danything/outboard/out/board-top.png

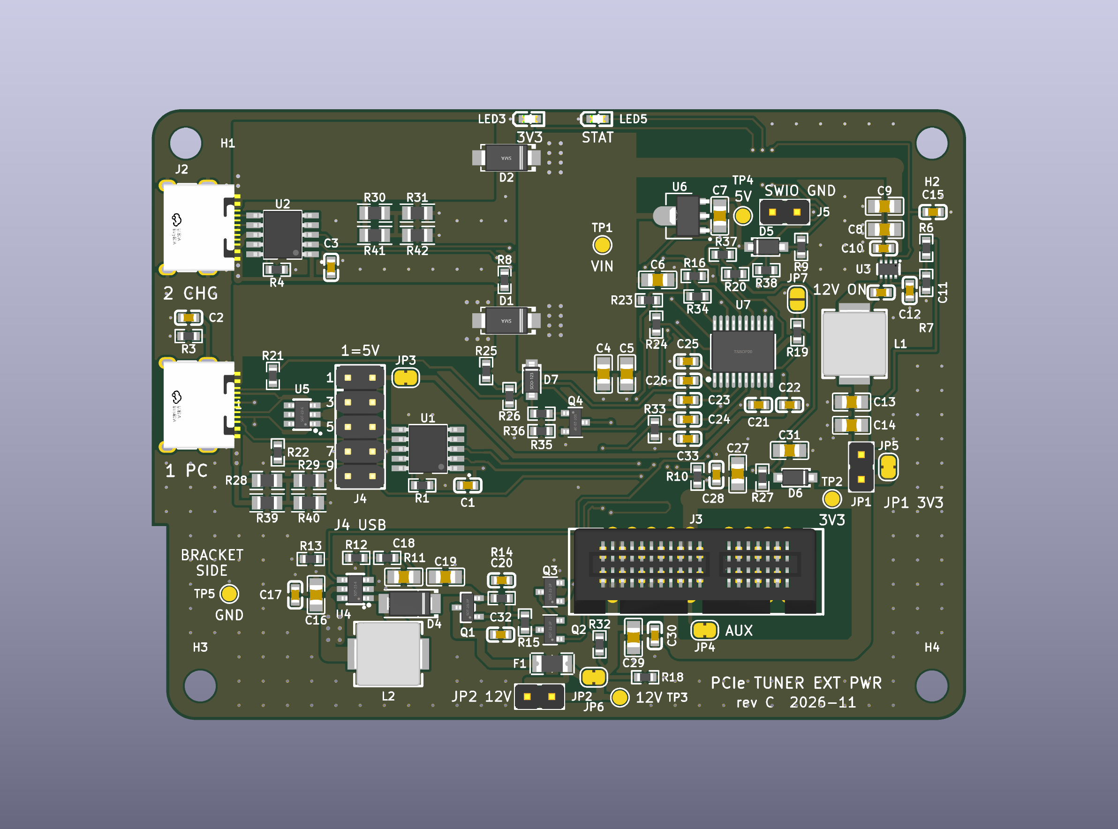
out/board-top.png
