danything/outboard/README.md

# PCIe チューナー外付け基板 (rev C・試作前)

PCIe のスロットから電源だけを取るチューナーカード (PLEX PX-MLT5PE・MLT8PE など。データは内部 USB) を、
PC のスロットなしで外付けの USB チューナーとして使うための基板です。USB-C を 2 つ持ちます。

- J1 (① PC): データ + 電源。D+/D− は ESD 保護 (U5) を通って、内部 USB ヘッダ J4 へ
- J2 (② 充電器): 電源だけ
- どちらも PD で 9V を要求 (CH224A)。取れなければ 5V。2 つの入力はダイオードで VIN にまとめる
- VIN → 3.3V・3A (TPS62933)、VIN → 12V・0.5A (MT3608B + 出力スイッチ + 自動復帰ヒューズ)、VIN → 5V (HT7550-1。マイコンと J4 の VBUS 用)
- 基板は 84 × 63mm・2 層。**USB-C はカードのブラケットと同じ側 (左の辺)**。USB-C の口の面とブラケットの外の面を同じ面にそろえてある
- マイコン (CH32V003) が CC・VIN・VBUS・12V を読み、3.3V と 12V を入り切りする
- ハードで保証していること: ② だけつないでも 3.3V は出ない / 3.3V が無ければ 12V は出ない / マイコンが空なら 12V は出ない / VIN が約 13V を超えたら 12V は入らない (止まっている状態からの保護。下の「過電圧の遮断」)

**実機では何も確かめていません。** 回路図・基板・検査はすべて計算機の上のものです。ファームウェアはまだありません。
rev C は、rev B の再レビューの指摘 (回路の値と小さな追加) と、ケースに入れるための配置替えを入れた版です (下の「rev C で変えた所」)。
**ブラケットの寸法は推定の値で作っています。発注の前に、実物のカードで測ってください (「実物で測る所」)。**

## フォルダの中身

| 場所 | 中身 |
|---|---|
| `pcie-tuner-board.kicad_pro / .kicad_sch / .kicad_pcb / .kicad_dru` | KiCad 10 のプロジェクト (回路図は 1 枚・A2)。ファイルは KiCad 10.0.8 で作った KiCad 10 の形式で、KiCad 9 以前では開けない |
| `lib/` | 自前のシンボル (`pcie-tuner.kicad_sym`)、フットプリント (`pcie-tuner.pretty`)、3D モデル |
| `scripts/` | 作り直すためのスクリプトと、検査のスクリプト |
| `routing/route.ses` | 自動配線の結果 (検査を通ったもの。基板はこれから作り直せる) |
| `fab/` | JLCPCB に出すもの: `pcie-tuner-board-gerber.zip`、`bom.csv`、`cpl.csv` (`gerber/` は zip の中身) |
| `out/` | 回路図の PDF、基板の画像、**寸法の図 (`dimensions.pdf`・`.svg`)**、ERC・DRC・検査の結果、ネットリスト、Q1 のゲートの波形 (`sim/`) |
| `build/` | 途中のファイル (git には入れない) |

## KiCad での開き方と作り直し方

KiCad 10.0 で `pcie-tuner-board.kicad_pro` を開きます。ライブラリはプロジェクトの中を見るので、ほかに何も入れなくて開けます。
**回路図と基板はスクリプトが作ったものです。直すときはスクリプトを直して作り直します。**

Git Bash で、リポジトリの根から (KiCad 10.0.8 が `C:\Program Files\KiCad\10.0` にあること):

```sh
sh scripts/build_all.sh sch      # 回路図・ライブラリ・ERC・ネットリスト・ネットリストの検査
sh scripts/build_all.sh board    # 配置と手配線 → 自動配線 (wslc のコンテナ) → 仕上げ
sh scripts/build_all.sh check    # DRC (回路図との一致つき) と基板の検査
sh scripts/build_all.sh out      # fab/ と out/ の書き出し (寸法の図も)
```

- 自動配線 (freerouting) は**実行のたびに結果が変わります**。つなぎ残す回のほうが多いので、`sh scripts/route_until_clean.sh 8` で、
  DRC が 0 になるまでやり直します (rev C では 4〜5 回に 1 回ほど通りました。1 回 約 70 秒)。通った結果は `routing/route.ses` に残り、リポジトリに入っています
- いまの `routing/route.ses` から基板だけ作り直すなら、KiCad の python で `scripts/finish_board.py`
- 主なスクリプト: `parts.py` (部品)、`gen_project.py` (ルール)、`gen_schematic.py` (回路)、`check_netlist.py`、`board_lib.py` (基板を組む小道具)、
  `make_board.py` (配置と手配線)、`export_dsn.py`・`route.sh` (自動配線)、`finish_board.py` (取り込み・ベタ・シルク)、`check_board.py`、`make_drawing.py` (寸法の図)、`export_fab.py`
- 手で端から端まで引いたネット (電源・USB・CC など) は「Hand」のネットクラスにしてあり、自動配線には触らせません。自動配線が引くのは細い信号と +5V だけです。
  電源の銅の面の上は、自動配線の線を通さないようにしています (DSN にだけ通行止めを足す)
- 外の道具 (コンテナの中でだけ実行): easyeda2kicad 1.0.1 (`python:3.13-slim`)、freerouting 2.5.0 (`eclipse-temurin:25-jre`、sha256 は `route.sh`)、
  ngspice 44.2 (`debian:trixie-slim`。`out/sim/` の波形)。EasyEDA の API は easyeda2kicad 自身からは 403 になるので、データの取得だけ素の curl で行っています

## 機構: ブラケットと USB-C の口 (rev C の中心)

図は `out/dimensions.pdf` (左が全体、右がブラケットのまわりの 6 倍の拡大)。座標は基板の左上の角が (0, 0)、x は右、y は下、単位は mm。
上の長い辺がカードのはんだ面 (A) の側、下が部品面 (B) の側です。

| もの | 位置 | 根拠 |
|---|---|---|
| USB-C の口の面 = ブラケットの外の面 | x = −0.99 (基板の左の辺より 0.99 外) | 口の面と基板の端の差 0.99 は、JLCPCB (EasyEDA) の TYPE-C-31-M-12 のフットプリントの外形から (原点から口まで 5.07、基板の端まで 4.08)。基板の端が後ろの殻の足から 5.79 なのはデータシートの図 |
| スロットの 1 番ピンの中心 | x = 46.55、y = 47.0 ± 1.25 (A 列が上) | 口の面から 47.54。**推定**: PCIe CEM 1.2 を写した KiCad のライブラリ (lucanastasio/PCIexpress-KiCad) の値。CEM そのものは読めていない |
| ブラケットの板 | x = −0.99 〜 −0.13 (厚み 0.86)、y = 44.94 〜 63.36 (幅 18.42) | 厚みは 0.81〜0.86 (Keystone のカタログ)。幅 18.42 と、スロットの中心線から A 面の側へ 約 2.06・B 面の側へ 約 16.36 という分け方は、PCIe CEM 2.0 の図 6-4・6-16 から導いた値 (https://tecsmith.github.io/homeassistant-pc-switch/specs/pci-express-card-electromechanical-specification-revision-2.pdf)。**図の読み方で幅があり、A 面の側は 2.5 とも読める** |
| ブラケットをよける段 | y ≥ 43.0 では、基板の左の辺を x = 1.5 に引っ込めた | ブラケットの下の舌は、基板のおもての面より下まで伸びる (標準の高さで 約 11.8mm、ロープロファイルで 約 7.7mm) ので、そこに基板があると当たる。ブラケットの内の面から 1.63、ブラケットの A 面の側の端から 1.94 (2.5 と読んだときは 1.50) の余裕 |
| カードの基板の端 | x = 0.90 (1 番ピンから 45.65) | 同じライブラリの値。基板より上を通るので当たらない |
| J1 (① PC) / J2 (② 充電器) | 中心 y = 30.5 / 12.2。殻の幅 8.94 | 2 つともカードのはんだ面の側。間隔 18.3 (プラグの樹脂どうしが当たらない) |
| J4 (内部 USB) | 中心 (21.5, 32.8)。カードの面から 14.2 (ヘッダの端から 7.7) | J1 のすぐ奥。カードのはんだ面の側なので、挿したケーブルのプラグ (高さ 約 14) がカードの部品に当たらない。ケースの外からは触らない |
| LED (3.3V・STAT) | (39.0, 1.0)・(46.0, 1.0)。胴体の端は上の辺から 0.6 | 上の長い辺 (はんだ面の側) を選んだ: 下の辺の側はカードの部品 (高さ 14.5 まで) が基板の外まで張り出して LED を上から隠す。上の辺は J4 のケーブルから 20 以上離れている。横向きに光る LED は Basic・Preferred に無いので、ふつうの 0603 (C2286) を辺のすぐそばに置いた |

**ケースの床**: ブラケットの舌は基板のおもての面より下へ、標準の高さのブラケットで 約 11.8mm、ロープロファイルで 約 7.7mm 出ます。
基板の厚み 1.6mm を引いて、基板の下に 10.2mm (ロープロファイルは 6.1mm) 以上の空きか、床に舌の通る穴が要ります。取り付けの足の高さはそれで決まります。

ケースの後ろの板は、内の面がブラケットの板に当たる面 (x = −0.13) になる想定です。ブラケットの厚みが 0.86 なら、USB-C の口は板の穴の中へ 0.86 入ります (指示の 0〜1mm の中)。

取り付け穴 (M3 用、穴 3.2mm、めっきなし):

| 穴 | x | y |
|---|---|---|
| H1 | 3.5 | 3.5 |
| H2 | 80.5 | 3.5 |
| H3 | 5.0 | 59.5 |
| H4 | 80.5 | 59.5 |

H3 だけ、段のぶん 1.5 右に寄っています。

**カードの長さ**: PX-MLT8PE の基板の長さは、公表の値を見つけられませんでした (メーカーの仕様に外形の記載を見つけられず、検索で出たのは非公式のケースの頒布だけ)。
図では、カードが基板の右の端より先へ続くことだけを示しています。基板の右の端は 1 番ピンから 37.45mm、スロットの右の端から 約 14mm なので、ふつうのロープロファイルのカード (120mm 以上) は基板から右へはみ出します。

### 実物で測る所 (発注の前に)

1. **1 番ピンの中心 (カードでは端子の 1 番の中心) からブラケットの外の面まで**: 設計は 47.54。違っていたら `make_board.py` の `PIN1_TO_BRACKET` を直して作り直す
2. **ブラケットの板の厚み**と、**ブラケットがカードの面からどちらへ何 mm 張り出しているか** (設計は A 面の側へ 2.06〜2.5、B 面の側へ 16.36)。A 面の側が 3.5 を超えると、段との余裕が 0.5mm を切る (4.0 で当たる)
3. **ブラケットの下の舌が、スロットに挿したとき基板のおもての面より何 mm 下へ出るか** (設計は 11.8 / 7.7mm と見ている) と、その幅 (幅 18.42 の全部をよけている)
4. カードのはんだ面の側の部品の高さ (J4 のプラグまで 7.7 ある)、カードの USB のケーブルが J4 に届くか
5. カードの基板の長さ (ケースの奥行きを決めるため)
6. USB-C のプラグの樹脂が、ケースの板とブラケットに当たらないか (J1 の殻の下の端からブラケットの端まで 約 10)

## JLCPCB への出し方 (発注はまだしていません)

1. 見積もりで `fab/pcie-tuner-board-gerber.zip` を上げる。2 層、84 × 63mm、1.6mm、銅 1oz、ほかは標準。外形は左下に 1.5mm の段がある (入り隅は工具の丸みになる)
2. 「PCB Assembly」をオン。**Economic**、Top Side、数量 2。**備考欄に「J1/J2 (USB-C) overhang the left board edge by 1 mm」と書く** (基板の端から部品が出ることを先に伝える)
3. BOM に `fab/bom.csv` (36 行)、CPL に `fab/cpl.csv` (98 個) を上げる
4. 部品の割り当ての画面で、全部の行が LCSC の品番で見つかること、在庫、Basic / Extended の区分を確かめる
5. **部品の配置の絵で向きを確かめる** (下の一覧)。ずれていたらその場で回す

**見積もりの画面で見る所 (確かめられなかったこと)**:

- **C404113 (PCIe スロット)・C492422 (2×5 ヘッダ)・C165948 (USB-C) が Economic で載せられるか**。部品検索の API には Economic / Standard の区分の欄が無く (見た欄: `componentLibraryType`・`assemblyComponentFlag` など)、確かめられなかった。
  「Standard only」と出たら、段取り費が大きく変わる (下の見積もりの Standard の列)。その部品だけ載せずに自分で付ける手もある
- **スルーホールの部品 (J3・J4) に Extended の手数料 (Feeder Loading 3.07 ドル) がかかるか**。料金のページは「ピックアンドプレースのフィーダーの段取りの手数料」と説明していて、手はんだの部品にかかるとも、かからないとも書いていない。下の見積もりは、かかるものとして数えている (かからなければ 6.14 ドル安い)
- 実装の最小の枚数 (API の `leastPatchNumber` は、見た 3 部品とも 2)

JLCPCB が付ける物: 表面実装の部品全部と、スルーホールの **J3 (PCIe スロット) と J4 (2×5 のピンヘッダ)**。

載せない物:

- TP1〜TP5、H1〜H4
- はんだジャンパー JP3・JP4・JP5・JP6 (幅 1.0mm の銅の橋で最初からつながっている。切るときはカッターで橋を切る) と JP7 (最初は開いている)
- **1×2 のピンヘッダ J5・JP1・JP2**: 穴だけ作って載せない

届いてから手ですること:

- J4 の 9 番ピン (シルクの「9」の横) を抜く。マザーボードのヘッダと同じ、誤挿し防止の欠けピンにするため
- カードのケーブルが 1 列 5 ピンのときは、**シルクに 1・3・5・7・9 と数字のある列 (J1 に近い列)** に挿す。「1=5V」の側が 1 番 (5V)、3 が D−、5 が D+、7 が GND
- J5 (SWIO・GND) に 2 ピンのヘッダを付けるか、書き込みのときだけ線を当てる
- 電流を測るときだけ: JP5 (3.3V) か JP6 (12V) の橋を切り、JP1 か JP2 にヘッダを付けて電流計を挟む。測らないなら何もしない
- 12V を手で強制オンにしたいとき: JP7 をはんだでつなぐ (ファームウェアが SW1_IN を読む)

J4 は囲いのない 2×5 のヘッダ (C492422) のままです。囲いつきは IDC 用の箱形ヘッダ (C19193807・C53207560、どちらも Extended) しか無く、
マザーボードの USB ヘッダ用のプラグ (欠けピンで向きを決める) は IDC の箱の切り欠きに合う作りではないので、採っていません (判断。実物では確かめていない)。

### 配置の絵で見る所 (CPL の回転は補正 0。フットプリントを JLCPCB のライブラリのものにそろえたので理屈では合うが、確かめていない)

基板を「USB-C が左、スロットが下寄り」に置いて見たとき (rev C で向きが変わった):

| 部品 | 正しい向き |
|---|---|
| D1・D2 (SS54)・D4 (SS34)・D6 (1N4148W) | 帯 (カソード) が右 |
| D5 (1N4148W) | 帯が左 |
| D7 (BZT52B12) | 帯が上 |
| Q1・Q2・Q3 | 足 1 本の側が左、2 本の側が右 |
| Q4 (MMBT3904) | 足 2 本の側が左、1 本の側が右 |
| U1・U2 (CH224A)・U4 (MT3608B)・U5 (SRV05-4) | 1 番ピンが右下 |
| U3 (TPS62933) | 1 番ピンの丸印が右上 |
| U6 (HT7550-1) | 大きいタブが左 |
| U7 (CH32V003) | 1 番ピンが左下 |
| LED3・LED5 | カソードの印が左 |
| J1・J2 | 口が左 (基板の外) |
| J3 | 切り欠きが中央より右、「A」が上・「B」が下 |
| J4 | 1 番ピン (四角のパッド) が左上 |

## rev C で変えた所

配置 (持ち主の希望):

| # | 何を | どうした |
|---|---|---|
| 1 | USB-C | ブラケットと同じ側 (左の辺) へ。口の面 = ブラケットの外の面。基板をブラケットの側へ伸ばし、ブラケットが通る所は辺を 1.5mm 引っ込めた (上の「機構」) |
| 2 | LED | 2 個とも上の長い辺に、辺から 0.6mm、間隔 7mm、基板のまん中あたり (x = 39・46。基板の幅は 84) |
| 3 | 取り付け穴 | 四隅 (上の表) |
| 4a | D1・D2 の銅 | アノードはおもての面 212mm² (VBUS1)・230mm² (VBUS2)、カソードは 2 個で共用のおもての面 406mm² + うらの面 372mm²。カソードのパッドのすぐ横に外径 0.8mm のビア 8 個ずつ (`check_board.py` の値) |
| 4b | CC の線 | USB-C の殻の下を通さない: パッドから奥へ出して手で引いた。① は J4 のピンの間を抜けて U1 へ。`check_board.py` (殻の四角と CC の線・ビア) と、DRC のルール (`.kicad_dru`) の両方で見ている |
| 4c | うらの面の線 | **目標の 150mm には届いていない: 257mm** (rev B は 約 250mm)。降圧・昇圧の下は 0 本。USB のデータ線の下は、D+ 自身の A6 の渡り (2.3mm) だけで、ほかのネットは 0 本 (検査あり)。長い順: LED3_A 36、EN_3V3 25、I2C2_SCL 22、I2C1_SCL 21、I2C2_SDA 16、+5V 15、CC2_SENSE 15mm。手で決めたうらの線は、VIN の面をくぐる 3 本 (I2C2 と EN_3V3、各 14mm)、降圧への幹をくぐる 3 本 (各 3.6mm)、PERST# (13mm)、Q3 のゲートの +3V3 (14mm)、① の殻 (9mm)、U1 の VBUS (5mm) |
| 4d | F1 | Q1 から 10.5mm、D4 から 16.0mm、L2 から 16.9mm (中心どうし)。スロットの 1 番ピンのすぐ下 |
| 4e | JP5 などの橋 | 閉じたはんだジャンパーの銅の橋を、幅 0.6mm から 1.0mm に (JP3・JP4・JP6 も同じフットプリント) |
| 4f | J3 の柱の穴 | **2 か所とも 2.35mm (rev B と同じ)**。UMAX の図面 (318307001、4/5 枚目) の推奨が 2 か所とも ø2.35±0.05。柱は、切り欠きの横が ø2.20±0.10、端が ø2.05±0.10 (1/5 枚目)。切り欠きの横を 2.40 に広げる案は、A11・B11 の穴との壁が 0.47mm に減るのでやめた (2.35 で 0.495mm、パッドの銅まで 0.27mm)。柱が最大 (2.30) で穴が最小 (2.30) だと、すきまは 0 |
| 4g | 部品の外枠 (コートヤード) の DRC | 有効にして 0 件。除外は無い |
| 追加 | J4 | JLCPCB に載せてもらう (C492422、Extended)。J1 のすぐ奥、カードのはんだ面の側 |

回路 (再レビューの指摘):

| # | 何を | どうした |
|---|---|---|
| 5 | Q1 のゲート | C20 100nF → **1µF**、R15 100kΩ → **150kΩ** (C22807)、C32 47nF → **33nF** (C21117)、R14 は 100kΩ のまま (下の「Q1 のゲート」) |
| 6 | F1 | nSMD075-16V → **1206L110/16NR** (C7542961、LUTE、保持 1.1A・遮断 2.2A・16V、1206)。データシートの表で 60℃ 0.72A・70℃ 0.66A・85℃ 0.55A。在庫 18,883 (2026-11-11) |
| 7 | ブリーダ | VBUS1・VBUS2 それぞれ、1kΩ 0805 (C17513、125mW) を 2 直列 × 2 並列 = 1kΩ。21V で 1 本 110mW、9.9V で 25mW (`check_netlist.py` が定格と比べる) |
| 8 | 直列の 1kΩ | マイコンの PC4 と PERST# の間に R37、PC3 と U3 の EN の間に R38。PC4 が Low のとき PERST# は 0.21V、PC3 が Low のとき EN は 0.05V (VBUS1 が 20V でも 0.20V) |
| 9 | D1・D2 | **SS54 のまま** (下の「SSL54 との比べ」) |
| 追加 | CH224A の CC | 端子の CC1 を IC の 6 番 (CC2)、CC2 を 7 番 (CC1) へ**入れ替えてつないだ**。基板の上で 2 本を交差させない (うらを通さない) ため。CH224A のデータシートは 2 本とも「Type-C CC 信号線」としていて、区別が出てくるのは使っていない eMarker の模擬 (オス端子) だけ。向きを IC がどちらと見るかが変わるだけで、動作は同じと判断した (**実機では確かめていない**) |
| 追加 | 分圧の下の抵抗 | R24・R26 は上の抵抗のそばへ移した (回路は同じ)。R8 (EN の分圧の上) は D1 のアノードの面の右上へ |

マイコンのピンは rev B と同じです。

## 設計の決めごとと根拠

### VIN や VBUS が 20V になったとき (充電器の異常) と、12V の過電圧の遮断

TVS は載せていません (Basic に 20V 級は無い。Preferred の SMF24A は抑える電圧が 38.9V で、守りにならない)。
20V (PD の上限は 21V) がかかっても壊れないこと:

- VIN の側: U3 30V (最大定格 32V)、U4 24V (最大定格 26V)、U6 30V、コンデンサ 25V 以上、D1・D2 40V
- VBUS の側: CH224A の VHV・VBUS は 30V 級、CC は直列 100kΩ でマイコンへ (0.15mA)、**ブリーダは 21V で 1 本 110mW (定格 125mW)**、VBUS のコンデンサ 50V、
  U3 の EN は D5 が 5.7V に抑える (20V のとき D5 に 0.14mA)、マイコンの ADC は 20V で 4.96V

昇圧は止めていても入力を出力へ通すので、VIN が高いとき Q1 を入れるとカードにその電圧がかかります。これをハードで止めます:
VIN → D7 (BZT52B12、12V ±2%) → R35 (10kΩ) → Q4 (MMBT3904) のベース、R36 (10kΩ) でベースを GND へ。Q4 のコレクタが Q2 のゲートを GND に引きます。

- 効きはじめる VIN = Vz + 2 × Vbe → **12.2〜13.6V** (下の端は計算で 12.16V)。確実に切れるのは 13.8V 以上 (hFE 30 として)。9V の PD (VIN は最大 9.5V) では必ず入り、15V では必ず切れる
- **これは「止まっている状態」の保護です。** 12V を出している最中に VIN が 9V から 20V へ上がった場合、Q1 が切れるまで数十 ms かかり (ゲートの 1µF と 33nF を 100kΩ で放電する。
  下の表の「オフの遅れ」は 157ms)、その間はカードに高い電圧がかかります。防ぐのはファームウェアの役目で、CH224A に 9V より上を決して要求しないことです
- **12V 固定の AC アダプタ (PD でない、VIN が 11.6〜12.3V) は、下のしきい値 (12.16V) に触れます。** その入力では 12V の出力は保証しません (入ったり入らなかったりする)
- Q1 (AO3401A) の Vgs は、切れる手前の 13.8V でも −5.5V。最大定格は ±12V
- ツェナーの数十 µA での電圧は、データシートの表に無く、見積もりです

20V を超える電圧、挿した瞬間の跳ね上がりは、防いでいません。

### Q1 のゲート (ngspice の結果。`out/sim/` に回路・波形・表)

回路: Q1 のゲート-ソースに R14 100kΩ と C20、ドレイン-ゲートに C32、ゲートから R15 を通って Q2・Q3 で GND へ。

| | rev B (100k / 100n / 47n) | 再レビューの案 (33k / 1µ / 47n) | **採った値 (150k / 1µ / 33n)** |
|---|---|---|---|
| 挿した瞬間の Vgs (9V の PD、VIN 8.6V) | Vth を超えて Q1 が入る | −0.38V | **−0.27V** (4.6V のとき −0.15V) |
| 同 (20V の異常、19.6V) | — | — | −0.63V (Vth が最小 0.5V の個体は、出力に 2.5V 漏れる) |
| オンのときの Vgs (12.36V / 13.8V) | −6.2 / −6.9V | −9.3 / **−10.4V** | **−4.94 / −5.52V** |
| 立ち上がり・突入 (負荷のコンデンサ 100 / 220µF、無負荷) | — | 0.7 / 1.3A | 1.8V/ms、**0.21 / 0.42A** (14.7ms の遅れのあと) |
| オフの遅れ (SW12_ON を下げてから出力が下がりはじめるまで) | — | — | 157ms (0.5V まで 207ms)。0.5A を流したまま切ると Q1 に 53mJ |

- 挿した瞬間は、C32 と C20 の分圧でゲートが取り残されます (Vgs = VIN × C32 / (C32 + C20) = 8.6 × 33n / 1.033µ = 0.27V)。AO3401A の Vth の最小は 0.5V なので入りません。`check_netlist.py` がこの式で見ています
- 再レビューの案は、13.8V で Vgs が −10.4V (定格 ±12V に近い) で、突入も大きいので採っていません
- オンの Vgs −4.9V は、データシートの −4.5V の条件 (最大 60mΩ) より少し深い。0.5A で 30mV・15mW
- **出力の短絡は、SW12_ON を下げても守れません** (切れるまで 50〜250ms、その間 Q1 に 1〜3J)。EN_12V を下げても、昇圧は D4 で素通しなので電流は止まりません。
  短絡のときは Q1 を入れたまま F1 に任せます (ファームウェアの仕様 5)。
  **次の版の候補**: ゲートを速く放電する回路 (Q1 のゲート-ソースを小さな PNP か P-MOSFET で短絡する、または R14 を小さくして専用のドライバで引く) を足し、短絡でも数 ms で切れるようにする。rev C には入れていません

### ブリーダ抵抗と、D1・D2 (SS54) の熱、SSL54 との比べ

SS54 (MDD、C22452、`build/ds/C22452.pdf`): 逆電流は最大 1.0mA (25℃)・50mA (100℃) (40V)。9V のときはグラフ (typical) から 25℃ 約 4µA、75℃ 約 0.2mA、100℃ 約 3mA。
順電圧は最大 0.55V (5A)、グラフ読みで 2A 約 0.36V・3A 約 0.42V。RθJA 60℃/W (5 × 5cm の銅)。接合温度は 125℃ まで。

SSL54 (C41410770、Preferred、在庫 13,264。データシート `build/ds/C41410770.pdf`): 順電圧は最大 0.48V (5A)、グラフ読みで 2A 約 0.36V・3A 約 0.38V。
逆電流は最大 0.5mA (25℃)・50mA (100℃) (40V)、9V のグラフ読みで 25℃ 約 15µA・100℃ 約 4.5mA。RθJA 80℃/W、接合温度 150℃ まで。

| | SS54 | SSL54 |
|---|---|---|
| 3A のときの損失 | 約 1.26W | 約 1.14W (1 割減) |
| 9V・100℃ の逆電流 (typical) → 1kΩ のブリーダでの VBUS | 約 3mA → 3.0V | 約 4.5mA → 4.5V |
| 9V・75℃ | 約 0.2mA → 0.2V | グラフから読めない (SS54 より多い) |
| 手数料 | Basic | Preferred (FAQ では Extended の手数料がかからない) |

**替えていません。** 順電圧の得は 3A で 0.04V ほど (グラフ読みの粗さと同じくらい) なのに、熱いときの逆電流が 1.5 倍で、② だけつないだときに VBUS1 が 0.8V (vSafe0V) を超える温度が下がります。
SSL54 には EasyEDA のフットプリントも無く、SS54 のランドを流用することになります。熱は、銅を広げたこと (rev C) で対処しました。

ブリーダ: ② だけに 9V が来ているとき、D1 の逆電流が VBUS1 に流れ込みます。1kΩ なら 75℃ で 0.2V、0.8V に届くのは 0.8mA (グラフでは 85〜90℃)。
U3 の EN がオンになる 2.9V に届くのは 2.9mA (約 100℃)。**熱いときの余裕は typical の線に対するもの**です。

熱 (計算。損失は rev B と同じ): 5V・3A で 1.26W、5V・2.5A で 約 1.0W、9V・2A で 0.72W、9V・1.35A で 約 0.45W。
rev C では、アノードとカソードそれぞれに 200〜400mm² のおもての銅と、うらの面 (ビア 8 個) が付いたので、熱抵抗はデータシートの 60℃/W (25cm² の銅) と rev B (パッドのそば 33mm²) の間のどこかです。
**何 ℃/W かは計算できていません。** 60〜90℃/W と見れば、5V・3A で 76〜113℃ の上がり (まわりが 40℃ なら接合 116〜153℃) で、**5V で 3A を流し続けるのはまだ危ない**見込みです。試作で温度を測ります。

### 値の計算

- **3.3V**: 0.8V × (1 + 47k/15k) = 3.307V。500kHz、4.7µH。ソフトスタート 100nF → 14.5ms。出力 22µF × 3
- **U3 の EN**: VBUS1 × 68k / 168k。データシートのしきい値は、上がりが標準 1.21V・最大 1.28V、下がりが標準 1.17V・最小 1.10V。EN のピンの電流 (0.7µA、オンのあと +1.4µA) を入れて VBUS1 に直すと、
  **オンは標準 2.92V・最大 3.09V、オフは標準 2.68V・最小 2.51V**。5V で 2.11V、9V で 3.73V、12V で 4.94V。C15 1µF で 約 37ms の遅れ
- **12V**: 0.6V × (1 + 100k/5.1k) = 12.36V。F1 の抵抗 0.04〜0.25Ω (データシート) で、0.5A のとき 0.02〜0.13V 下がる
- **PERST#**: 15kΩ × 10µF = 150ms、2.0V まで 約 140ms
- **ADC**: VIN・VBUS1・+12V は 100k/33k (0.248 倍)。5V → 1.24V、9V → 2.23V、12.36V → 3.07V、20V → 4.96V。CC は直列 100kΩ
- **配線** (`check_board.py` が道すじをたどって見ている): 3.3V は 1.5〜2.0mm (JP1 から A10 まで 9.5mΩ、B8 まで 10.6mΩ。rev B は 5.5 / 13.5)。
  VIN は面と 1.5〜2.0mm。昇圧へはうらの帯 (最細 1.1mm・平均 3.4mm。ビアや段でくびれる)。
  VBUS は、パッドの上だけ 0.5〜0.6mm、列を出たら 0.8〜0.9mm で面へ (① の下のパッドは、CC2 の線の横の 1.5mm が 0.5mm のまま)。
  ① の下のパッドからは、うらの帯 (最細 1.3mm・平均 2.7mm・長さ 約 57mm)。② の下のパッドからは、うらの橋 (1.2mm × 約 10mm)。
  12V は 0.8〜1.0mm。**F1 から JP2 (ヘッダ) への枝だけ 0.6mm** (ふだんの電流は、幅 0.8mm の JP6 の側を通る)
- **USB**: D+ と D− の主な道 (B6 → J4 の 5、A7 → J4 の 3) は同じ長さ (差 0)。線の中心で 14.72mm (`check_board.py`)、パッドの中の端まで数えると 約 14.9mm。
  裏返しに挿したときの A6 の側は、うらの渡りを通るぶん長く、約 17.7mm。rev B の形のまま 180 度回した

### マイコンのピン (CH32V003F4P6、TSSOP20)

| ピン | 名前 | つなぐ先 | | ピン | 名前 | つなぐ先 |
|---|---|---|---|---|---|---|
| 1 | PD4/A7 | VIN_SENSE | | 11 | PC1/SDA | U1 の SDA |
| 2 | PD5/A5 | VBUS1_SENSE | | 12 | PC2/SCL | U1 の SCL |
| 3 | PD6/A6 | CC1_SENSE | | 13 | PC3 | R38 1kΩ → EN_3V3 (Low に引くか Hi-Z) |
| 4 | PD7/NRST | 未接続 | | 14 | PC4 | R37 1kΩ → PERST# (Low に引くか Hi-Z) |
| 5 | PA1/A1 | CC2_SENSE | | 15 | PC5 | U2 の SCL (I2C1 を付け替え) |
| 6 | PA2/A0 | 12V_SENSE | | 16 | PC6 | U2 の SDA |
| 7 | VSS | GND | | 17 | PC7 | 未接続 |
| 8 | PD0 | LED_STAT | | 18 | PD1 | SWIO (J5 の 1 番) |
| 9 | VDD | +5V | | 19 | PD2 | EN_12V (U4 の EN。100kΩ で GND へ) |
| 10 | PC0 | SW1_IN (10kΩ で +5V へ。JP7 をつなぐと GND) | | 20 | PD3 | SW12_ON (10kΩ を通して Q2 のゲートへ。ゲートは 100kΩ で GND へ) |

### PCIe のピンの対応の確かめ方

部品は UMAX 3183-10200P1T (C404113。品番の読み: 黒・Dual Post・1µ" 金・足 2.30mm・36 ピン)。データシートの推奨パターンと EasyEDA のフットプリントを突き合わせました:
1 番ピンの側に 11 ピン、切り欠き、7 ピン。A 列が上、B 列が下。カードの側は同じデータシートの図で B 面 = 部品面、ブラケット (I/O PANEL DIRECTION) は 1 番ピンの先。
つなぎ先は `check_netlist.py` が 36 ピンとも検査しています。B7 (GND、内側の列) は、うらでは 2 列の間の細い GND にしかつながらないので、おもてで B4 (GND) にもつないであります。

## 部品 (rev C で替えたもの・足したもの)

区分と在庫は、JLCPCB の部品検索の API を 2026-11-11 に読んだ値です (Basic 351 件・Preferred 1,235 件の全件から探した)。

| 部品 | 品番 | 区分 | 在庫 | メモ |
|---|---|---|---|---|
| F1 1206L110/16NR | C7542961 | Extended | 18,883 | 保持 1.1A・16V。1812 の 33V 品 (C142747 44,580 個、C269134 380,450 個) も候補だったが、70℃ の保持が 0.63A でこれより低い |
| R28〜R31・R39〜R42 1kΩ 0805 | C17513 | Basic | | ブリーダ |
| R15 150kΩ | C22807 | Basic | | |
| C32 33nF 50V | C21117 | Basic | | |
| R37・R38 1kΩ 0603 | C21190 | Basic | | 既存の品 |
| J4 2×5 ピンヘッダ | C492422 | Extended | | 載せることにした |
| (削除) | nSMD075-16V、2kΩ、47nF | | | |

Extended は 9 種類: USB-C (C165948)、PCIe スロット (C404113)、CH224A (C42459160)、TPS62933 (C3200405)、MT3608B (C19189893)、CH32V003 (C5187096)、
4.7µH (C167220)、PTC (C7542961)、2×5 ヘッダ (C492422)。Preferred は 3 種類 (HT7550-1、BZT52B12、SRV05-4)。残りは Basic。
降圧 IC とマイコンは替えていません (指示)。Extended のままにした理由は rev B と同じです (Basic・Preferred に代わりが無い)。

### 見積もり (実装 2 枚・基板は 5 枚)

料金は https://jlcpcb.com/help/article/pcb-assembly-price (2026-10-22 更新) の Economic の値: Setup 8.18、Stencil 1.53、Extended の手数料 (Feeder Loading) 3.07、
手はんだ 3.58 + 1 か所 0.0164 ドル。「1 種類ごとに 3.07 ドル」とはページに明記が無く、そう読んでいます。Preferred に手数料がかからないのは FAQ の記述から。
実装の最小の枚数は確かめられていません (2 枚と仮定)。部品代は概算です。

| | rev B (Economic) | **rev C (Economic)** | rev C (Standard になった場合) |
|---|---|---|---|
| Extended の種類 | 8 | **9** (J4 のヘッダが増えた) | 部品 36 種類の全部に手数料 |
| 部品の段取りの手数料 (Feeder Loading) | 24.56 | **27.63** (3.07 × 9) | 55.08 (1.53 × 36。Basic にもかかる) |
| 段取り + ステンシル | 9.71 | 9.71 | 33.77 (25.56 + 8.21、片面) |
| スルーホール (3.58 + か所 × 0.0164 × 2 枚) | 4.76 (36 か所) | 5.09 (46 か所。J3 と J4) | 5.09 |
| 表面実装のはんだ (概算) | 0.8 | 0.9 | 0.9 |
| 部品 (2 枚ぶん、概算) | 9.2 | 9.6 | 9.6 |
| Standard だけの費用 | — | — | 取り扱い 14.93 以上 + 梱包 0.5 + 1 枚ずつの実装 0.48 × 2。治具 (16.42) が要るかは不明 |
| 合計 (基板の代金・送料・税は別) | 約 49 ドル | **約 53 ドル** (スルーホールに手数料がかからなければ 約 47 ドル) | 約 121 ドル (治具が要れば 約 137 ドル) |

Standard の列は、料金のページ (2026-10-22 更新) の Standard PCBA の値をそのまま足したものです。USB-C・スロット・ヘッダのどれかが「Standard only」だった場合の目安で、
実際にそうなるかは見積もりの画面でしか分かりません (上の「見積もりの画面で見る所」)。

基板は 84 × 63mm で、100 × 100mm 以下の料金の枠に入ります (rev B は 90 × 48mm)。

## ファームウェアが最低限やること (仕様)

1. I2C のピン (PC1/PC2・PC5/PC6) は必ずオープンドレイン。プッシュプルで High を出さない (CH224A の中のプルアップに任せる)
2. **I2C のペリフェラルは 1 つ (I2C1) だけ**。U1 と話すときは PC1/PC2、U2 と話すときは PC5/PC6 に付け替える (AFIO の I2C1_RM)。付け替える前に、いま使っていない側のピンを入力 (Hi-Z) に戻す。2 つの IC は同じアドレスなので、同時にはつながない
3. CH224A のレジスタ 0x0A に、9V より上 (2 以上) を書かない。**これが、動いている最中の過電圧からカードを守る唯一の手段** (ハードの遮断は間に合わない)
4. VIN_SENSE が 12.0V を超えたら 12V を入れない。入っていたら SW12_ON と EN_12V を下げる (短絡でないとき。負荷の電流は小さいので、Q1 が切れるまでの 約 0.2 秒は熱の問題にならない)
5. **12V を入れる順 (必須)**: EN_12V を上げ、VIN_SENSE と時間で昇圧が立ったと見てから SW12_ON を上げる。昇圧が止まったまま SW12_ON を上げない
   (5V 入力では昇圧の出力に VIN が素通しで 約 4.6V しか無く、Q1 の Vgs が −1.84V で半端にオンする)。
   **12V の短絡を見たとき** (+12V の ADC が上がらない・落ちる): 昇圧は D4 で入力から出力へ素通しなので、EN_12V を下げても短絡の電流は止まらない。
   電流が流れているまま SW12_ON を下げると、Q1 が線形の状態を数十 ms 通って危ない。→ **Q1 は入れたままにして、F1 (と電源の側の保護) に任せる。
   +12V の電流が落ちた (F1 が切れた、または VIN が落ちた) のを VIN_SENSE・12V_SENSE で見てから、SW12_ON と EN_12V を下げる。そのあと一定の時間 (例: 10 秒) は 12V を入れ直さない**
6. **3.3V が落ちたら (EN_3V3 を下げるとき・VBUS1 が無くなったとき)、先に 12V を切る** (EN_12V と SW12_ON を下げ、+12V の ADC が下がってから 3.3V を切る)。入れる順は 3.3V → 12V
7. 電力が足りると分かるまで EN_3V3 を Low に押さえる。PD の相手は CH224A の I2C の状態と電流から、PD でない相手だけ CC の電圧から判断する
8. **PC3 (EN_3V3) と PC4 (PERST#) は、Low を出すか Hi-Z (入力) にするかの 2 通りだけ。** プッシュプルの High は決して出さない (PC3 は 5V で、U3 の EN の推奨 5.5V に近く、PC4 は 5V を 3.3V の PERST# に押し込む。直列の 1kΩ は、まちがえたときの電流を抑えるだけ)
9. ADC は中の基準電圧 (Vrefint) で補正する (5V 入力では VDD が 4.2〜4.4V になる)
10. スタンバイは使わない
11. PERST# は、3.3V と 12V が立ってから 100ms 後に離す (それまで PC4 で Low に押さえる。ハードの遅れは 約 140ms)
12. 5V 入力では 12V の電流を抑える (値は、試作で U4 の温度を測ってから決める)

STAT (LED5) の点滅の案: 点灯 = 正常 / 1 回 = 電力不足で 3.3V を入れていない / 2 回 = 12V を止めた (過電圧・短絡・電圧の低下) /
3 回 = PD の交渉に失敗 (9V が取れず 5V) / 4 回 = JP7 で 12V を強制オン中。

## 試作で最初に確かめること

- 上の「実物で測る所」(発注の前)
- CH224A が電源の無いときに相手から見えるか (Rd)。9V を出せない相手で 5V に落ちるか。**CC を入れ替えてつないだまま、表でも裏でも PD が通るか**
- **D1・D2 の温度** (5V・2.5A)。5V 入力で 12V・0.5A のときの U4 の温度
- 充電器を挿した瞬間に +12V の線が動かないこと (Q1 が入らないこと)。12V を入れたときの立ち上がりと突入
- VIN を 9V から上げていって、12V が入らなくなる電圧 (12.2〜13.6V の見込み)
- 5V 入力のとき J4 の VBUS が 4.2〜4.4V になること (カードが受け付けるか)
- ② だけつないだとき VBUS1 が 0.8V 以下か (ブリーダ)、熱いときも
- PC に ① をつないだとき、カードが USB 機器として見えるか

## 検査の結果 (2026-11-12、rev C)

| 検査 | 結果 | 記録 |
|---|---|---|
| ERC | エラー 0・警告 0 | `out/erc.rpt` |
| DRC (回路図との一致つき、全部の重さ、部品の外枠の重なりも) | 違反 0・未配線 0・不一致 0 | `out/drc.rpt` |
| ネットリストの検査 | 84 項目 OK | `out/netlist_check.txt` |
| 基板の検査 | 75 項目 OK (うらの線の 150mm の目標は未達と記録) | `out/board_check.txt` |
| シンボルと EasyEDA のピンの突き合わせ | 不一致 0 | `out/lib_check.txt` |

DRC の決まり: めっきのない穴と銅は 0.2mm (ほかは 0.3mm)、文字の高さは 0.8mm 以上、CC の線は USB-C の殻の下に入れない。`lib_footprint_issues`・`lib_footprint_mismatch` は切ってあります。

## 確かめていないこと・不安な所

- 実際の電気的な動作、発熱、PD の相手ごとの振る舞いは、何も確かめていない
- **ブラケットの寸法は推定**。1 番ピンからブラケットまでが違えば、USB-C の口とブラケットの面がずれる
- **うらの面の線が 257mm** あり、うらの GND は細かく区切られている。浮いた島はビアで全体につないである (DRC の未接続 0) が、信号の帰り道としては rev B より良くなっていない。
  ① の VBUS の下のパッドと昇圧の VIN は、うらの帯 (VBUS1: 最細 1.3mm・長さ 約 57mm、VIN: 最細 1.1mm) を通り、そのぶんもうらの GND が切れている
- **D1・D2 の熱**: 銅は増やしたが、熱抵抗は計算できていない。5V・3A は危ない見込みのまま
- **CH224A の CC の入れ替え**は、データシートの記述からの判断
- **USB の信号**: 差動 90Ω にはなっていない (0.2mm と 0.5mm 幅、長さ 約 14.9mm、裏返しの A6 の側は 約 17.7mm)。CC1・CC2 と CC2 を読む線が J4 のピンの間 (すき間 0.84mm に 0.2mm の線) を通る
- **3.3V の出口**は降圧の下の端からスロットまで 約 20mm (9.5mΩ)。3A で 29mV 下がる
- **12V 固定のアダプタ**では 12V の出力を保証しない。動いている最中の過電圧はファームウェア頼み
- **12V の短絡**は、F1 が切れるまで Q1 を入れたままにするファームウェアの手順に頼っている (ハードで速く切る回路は無い)
- **JLCPCB の Economic で USB-C・スロット・ヘッダを載せられるか**は確かめられていない
- **Q1 の立ち上がりと挿した瞬間**は ngspice だけ (AO3401A のモデルはデータシートの値から作ったもの)
- **自動配線**: 4〜5 回に 1 回しか通らない。線は IC のピンの所で 0.15〜0.19mm にしぼられる所がある (0.125mm になった所は 0.15mm に戻している)
- **ダイオード・LED・ツェナーの極性と、SOT-23 のピンの並び**は、EasyEDA のシンボルを信じている。CPL の回転は補正 0 で、確かめていない
- **過電圧の遮断のしきい値**は計算だけ
- **CH224A**: DP/DM を浮かせてよいか、PG を浮かせてよいか、I2C のプルアップの電圧は、データシートに書かれていない
- 部品の在庫と区分は、発注の日に見積もりの画面で確かめる
