danything/outboard/out/sim/README.txt

12V 高い側スイッチ (Q1 AO3401A + R14/R15/C20/C32) の過渡解析  2026-11-11

■ 道具と版
  コンテナ : wslc 3.0.3.0 / debian:trixie-slim (Debian 13.7)
  ngspice  : 44.2 (Debian trixie のパッケージ)
  Python   : 3.13.5 / matplotlib 3.10.1 / numpy 2.2.4
  回し方 (Git Bash):
    MSYS_NO_PATHCONV=1 wslc run --rm -v "$(cygpath -w /d/danything/pcie-tuner-board/out/sim):/w" -w /w \
      debian:trixie-slim sh -c 'apt-get update -qq && apt-get install -y -qq ngspice python3-matplotlib >/dev/null && python3 -B sim.py'

■ ファイル
  hs_switch.cir  共通の部分 (Q1 のモデル、ゲートの回路、出力の側)。各場面から .include
  plug.cir / on.cir / off.cir / short.cir  場面 1〜4 (既定値は A 案・Vth typ。単体で ngspice -b でも回る)
  sim.py         .param を差し替えて全部の組を回し、results.csv と PNG を書く
  results.csv    全部の組の数値 (1 行 = 1 回の解析)
  plug.png / on.png / off.png / short.png  波形 (A・B・C 案を重ねた)

■ モデルの置き方
  Q1: LEVEL=1 の PMOS。KP=26.7 A/V^2、RD=31mΩ、RS=5mΩ、LAMBDA=0.01、VTO=-0.9 (typ) / -0.5 (min)
      → Rds(on) 47mΩ@-4.5V・60mΩ@-2.5V (データシート typ) に一致。gfs は 14.6 S @4A (データシート 17 S)
      外付け: Cgs 590pF、Cgd 55pF、Cds 25pF (データシート Ciss 645 / Coss 80 / Crss 55 pF @Vds=-15V)、Rg 7.8Ω
      ※ 依頼の文には Crss 約 80pF とあったが、データシート (Rev 3.1) は Coss 80pF・Crss 55pF
  SWN (Q2+Q3): 理想スイッチ 10Ω / 開放。F1: 0.2Ω の抵抗。コンデンサは理想 (ESR なし)
  場面 1: S を理想の電圧源で 0 → VIN (立ち上がり 10µs / 100µs / 1ms)。CL 100µF、負荷なし
  場面 2〜4: 12.36V の電源 → 1Ω → S、S に 44µF (20µF も試した: 差なし)
  時刻はどの場面も t = 1ms が出来事の始まり (CSV と図は そこを 0 とした)
  案: A = R15 150k / C20 1µ / C32 33n、B = 33k / 1µ / 47n、C (旧 rev B) = 100k / 100n / 47n、R14 は全部 100k
      D = A の C20 を 2.2µ に、E = R15 220k / C20 1µ / C32 22n (詰める候補。数値だけ)

■ 数値 (Vth typ。( ) の中は Vth min -0.5V のモデル)
                                      A            B            C           D           E
 1 挿した瞬間 Vgs 最小 [V] 4.6V     -0.15        -0.21        -1.31       -0.07       -0.10
                           8.6V     -0.27        -0.39        -1.88       -0.13       -0.19
                          19.6V     -0.63        -0.88        -2.89       -0.29       -0.42
   OUT に漏れる最大 [V]   4.6V       0.00         0.00       1.57 (2.86)   0.00        0.00
                           8.6V      0.00         0.00       5.54 (6.85)   0.00        0.00
                          19.6V    0.01 (2.54)  0.01 (7.43)  16.5 (17.8)   0.01        0.00
   Id 最大 [A]            8.6V       0            0          11.9 (15.1)   0           0
                          19.6V    0 (0.24)     0 (1.96)     44.6 (48.1)   0           0
   (立ち上がり 10µs の値。100µs・1ms でも A・B・D・E の Vgs はほぼ同じ。C は 1ms で -1.09〜-1.30V)
 2 オン  遅れ (10% まで) [ms]        14.7          3.4          2.0        30.4        21.5
   立ち上がり 10→90% [ms] CL100µ      5.6          1.8          4.6         6.5         6.3
   傾き [V/ms]             CL100µ    1.77         5.60         2.13        1.52        1.58
   突入の最大 [A] CL100µ / 220µ   0.21 / 0.42  0.70 / 1.28  0.24 / 0.47  0.20 / 0.38  0.20 / 0.38
     24Ω の負荷つき                0.62 / 0.78  1.02 / 1.54  0.68 / 0.88  0.60 / 0.72  0.60 / 0.74
   S の落ち込み [V] CL100µ / 220µ 0.21 / 0.42  0.69 / 1.28  0.24 / 0.47  0.20 / 0.38  0.20 / 0.38
   最終の Vgs [V] @12.36V / @13.8V -4.94 / -5.52 -9.29 / -10.37 -6.18 / -6.90 -4.92 / -5.49 -3.86 / -4.31
 3 オフ  90% を割るまで [ms]      157 (207)    227 (278)     31 (40)    335 (440)   129 (178)
   0.5V まで [ms]                 207 (289)    292 (384)     82 (125)   402 (551)   168 (241)
   Q1 の損失 [mJ] (CL100µ)         53 (90)      71 (119)     53 (91)     75 (125)    39 (68)
   瞬時電力の最大 [W]              1.38         1.41         1.39        1.41        1.34
 4 短絡  Id の最大 [A] (瞬間)      16.7         16.8         16.8        16.7        16.6
   Id @50ms [A] / S [V]           9.1 / 3.2    9.1 / 3.2    8.8 / 3.6   9.2 / 3.2   9.1 / 3.3
   Q1 の損失 50ms [mJ]            213          194          328         202         235
   SWN オフから止まるまで [ms]    143 (213)    174 (249)     48 (72)    335 (472)   113 (178)
   その間の Q1 の損失 [J]         1.9 (2.6)    2.2 (3.1)    0.9 (1.3)   3.7 (5.1)   1.6 (2.3)
   (止まる = Id < 10mA。瞬時電力の最大は 29W)

■ 読み方
  ・挿した瞬間の Vgs は容量の分圧 -VIN × C32/(C20+C32) で決まる (A 3.2%、B 4.5%、C 32%)。立ち上がりの速さにはほぼよらない
  ・オンの傾きは (ゲートを引く電流)/C32、突入は (CL+10µF) × 傾き
  ・オフの遅れは R14 × C20 でゲートが抜ける時間。短絡のときも同じだけ待たされる

■ 注意 (モデルが粗い)
  ・LEVEL=1 は しきい値より下の電流 (サブスレッショルド) が 0。実物は |Vgs| < Vth でも µA〜mA が流れうる
  ・Vth の温度による動き (高温で約 -2mV/℃ ぶん小さくなる)、Rds の温度係数、自己発熱は入っていない
  ・Cgd は一定値 (実物は Vds が小さいと数倍になる)。C32 が 33nF 以上なので影響は小さい
  ・飽和の電流は実物より大きく出る (LEVEL=1 は 2 乗則のまま。データシートの -4.5V の曲線は 20A 台で寝る)
  ・電源は「12.36V + 1Ω」。本物の昇圧は 0.5A ほどで垂れるので、短絡の 9A・1.9J は上限の見積もり。
    一方で昇圧はダイオードで入力から素通しになるので、短絡の電流は入力の側 (USB の電源) の制限で決まる
  ・PTC は 0.2Ω のまま (切れない)。コンデンサの DC バイアスによる減り・ESR・配線のインダクタンスはなし
  ・2N7002 の Coss や漏れ、ゲートの保護は入っていない
