danything/outboard/out/netlist_check.txt

# ネットリストの検査 (scripts/check_netlist.py が out/netlist.net を読んで作る)

部品 115 個、ネット 56 本 (未接続の印のピン 42 本)

[OK] J3: 電源・GND・PERST# の 18 ピンが決めたネットにつながっている
       +12V x5, +3V3 x3, +3V3AUX x1, PERST# x1, GND x9
[OK] J3: ほかの 17 ピン (PRSNT#・WAKE#・JTAG・SMBus・REFCLK・レーン) はどこにもつながっていない
       17 ピン
[OK] J3: +12V のネットに乗っているスロットのピンは A2 A3 B1 B2 B3 だけ
       A2 A3 B1 B2 B3
[OK] J3: +3V3AUX のネットに乗っているスロットのピンは B10 だけ
       B10
[OK] J3: PERST# のネットに乗っているスロットのピンは A11 だけ
       A11
[OK] J3: +3V3 のネットに乗っているスロットのピンは A9 A10 B8 だけ
       A10 A9 B8
[OK] 電源のネットが別々に存在する (名前の取り違えで 1 つにまとまっていない)
       13 本
[OK] 直流で素通しになる部品 (コイル・ジャンパー) がつなぐネットは決めたとおり
       JP1: +3V3 - +3V3_BUCK; JP2: +12V - +12V_F; JP3: +5V - USBH_VBUS; JP4: +3V3 - +3V3AUX; JP5: +3V3 - +3V3_BUCK; JP6: +12V - +12V_F; JP7: GND - SW1_IN; L1: +3V3_BUCK - SW_3V3; L2: SW_12V - VIN
[OK] 端子のほかに 2 本以上の電源にまたがる部品は D1・D2・Q1・F1・U6 だけ (3.3V と 12V と VIN を直接つなぐ部品はない)
       D1:VBUS1/VIN D2:VBUS2/VIN F1:+12V_F/+12V_SW Q1:+12V_BOOST/+12V_SW U6:+5V/VIN
[OK] 電源と電源を直接つなぐ抵抗はない
       0 個
[OK] USB_DP: J1 の A6・B6、U5 の 1 (IO1)、J4 の 5 だけ
       J1.A6 J1.B6 J4.5 U5.1
[OK] USB_DN: J1 の A7・B7、U5 の 3 (IO2)、J4 の 3 だけ
       J1.A7 J1.B7 J4.3 U5.3
[OK] J4: 1・2 = USBH_VBUS、7・8 = GND、4・6・9・10 は未接続
[OK] U5: 2 = GND、5 (REF) は未接続 (REF の TVS は 6V で、9V の VBUS にはつなげない)、4・6 (IO3・IO4) も未接続
[OK] J2 の D+/D-/SBU と J1 の SBU は未接続
[OK] U1: VHV(1)・VBUS(8) = VBUS1、IC の 6・7 (CC2・CC1) = J1 の A5・B5 (CC1・CC2。基板の上で線を交差させないため入れ替えてある。IC は 2 本を同じに扱う)、GND、DP/DM と PG は未接続
[OK] VBUS1: GND へのブリーダは合成 1kΩ 以下。VBUS が 21V (20V の PD の上限) でも 1 本の損失が定格以下。VBUS1 から GND へじかにつながる抵抗はない
       R28 R39 + R29 R40: 合成 1000Ω、21V で 1 本 110 mW (定格 125 mW)、9.9V で 25 mW
[OK] U1: CFG1 と GND の間に 6.8kΩ (データシートの表 5-1 で 9V)、CFG1 にはほかに何もつながない
       ['R1'] 6800Ω
[OK] VBUS1 (端子の側) のコンデンサは合計 10µF 以下で、VHV に 1µF がある
       C1 = 1.0µF
[OK] U1: I2C は I2C1_SCL(2)・I2C1_SDA(3) で、マイコンのピンとだけつながる
[OK] U2: VHV(1)・VBUS(8) = VBUS2、IC の 6・7 (CC2・CC1) = J2 の A5・B5 (CC1・CC2。基板の上で線を交差させないため入れ替えてある。IC は 2 本を同じに扱う)、GND、DP/DM と PG は未接続
[OK] VBUS2: GND へのブリーダは合成 1kΩ 以下。VBUS が 21V (20V の PD の上限) でも 1 本の損失が定格以下。VBUS2 から GND へじかにつながる抵抗はない
       R30 R41 + R31 R42: 合成 1000Ω、21V で 1 本 110 mW (定格 125 mW)、9.9V で 25 mW
[OK] U2: CFG1 と GND の間に 6.8kΩ (データシートの表 5-1 で 9V)、CFG1 にはほかに何もつながない
       ['R4'] 6800Ω
[OK] VBUS2 (端子の側) のコンデンサは合計 10µF 以下で、VHV に 1µF がある
       C3 = 1.0µF
[OK] U2: I2C は I2C2_SCL(2)・I2C2_SDA(3) で、マイコンのピンとだけつながる
[OK] U1 と U2 の I2C は別のバス (アドレスを選べないため)
[OK] D1: アノード = VBUS1、カソード = VIN
       VBUS1 -> VIN
[OK] D2: アノード = VBUS2、カソード = VIN
       VBUS2 -> VIN
[OK] D4: アノード = SW_12V、カソード = +12V_BOOST
       SW_12V -> +12V_BOOST
[OK] D5: アノード = EN_3V3、カソード = +5V
       EN_3V3 -> +5V
[OK] D6: アノード = PERST#、カソード = +3V3
       PERST# -> +3V3
[OK] LED3: アノード = LED3_A、カソード = GND
       LED3_A -> GND
[OK] LED5: アノード = LED5_A、カソード = GND
       LED5_A -> GND
[OK] VIN から VBUS1・VBUS2 へ戻る道は D1・D2 (逆向き) だけ
[OK] VBUS1 と VBUS2 を直接つなぐ部品はない
[OK] U3: 1 RT 未接続 (500kHz)、2 EN、3 VIN、4 GND、5 SW、6 BST、7 SS、8 FB
[OK] U3: 出力 = 0.8V × (1 + Rtop/Rbot) が 3.3V ± 3% (PCIe の許す幅は ±9%)
       R6/R7 -> 3.307V
[OK] U3: BST-SW に 100nF、SS に 6.8nF 以上 (浮かせない)、入力に 10µF 以上と 100nF
[OK] U3: ソフトスタートの時間 = Css × 0.8V / 5.5µA
       14.5 ms
[OK] U3: 出力のコンデンサの公称の合計 (データシートの実効の目安 40µF、最小 15µF)
       66.1µF
[OK] U3 の EN は J1 の VBUS (VBUS1) からの分圧だけで上がる (VIN や VBUS2 からの抵抗はない)
       R8=100k / R9=68k, 比 0.405
[OK] EN: VBUS1 が 4.0V (USB の下限) で確実にオン (しきい値の最大 1.28V)
       オンになる VBUS1: 標準 2.92V・最大 3.09V (EN 1.21V / 1.28V)、オフ: 標準 2.68V・最小 2.51V (EN 1.17V / 1.10V)
[OK] EN: VBUS1 が 5V・9V・9.9V・12V のとき 5.5V (推奨の上限) 以下
       5V -> 2.11V / 9V -> 3.73V / 9.9V -> 4.09V / 12V -> 4.94V
[OK] EN: 分圧だけで 6V (最大定格) に届く VBUS1
       14.8V (5.5V に届くのは 13.6V)
[OK] EN: それ以上の異常な電圧は D5 (EN -> +5V) が +5V + 0.7V = 5.7V 以下に抑える (最大定格 6V 未満)
       20V のとき D5 に流れる電流 0.14 mA
[OK] EN_3V3 につながるのは U3 の EN・分圧・コンデンサ・D5 と、マイコンの PC3 への直列 1kΩ だけ
       C15.1 D5.2 R38.2 R8.2 R9.1 U3.2
[OK] EN: マイコンが PC3 を Low にしたとき、直列 1kΩ があっても EN はオフのしきい値 (最小 1.1V) より十分低い
       VBUS1 が 20V でも 0.20V、5V で 0.05V
[OK] EN: VBUS1 が 5V になってから EN がしきい値に届くまで 20ms 以上 (挿した直後のばたつきを避ける)
       C15 1.0µF: 37 ms
[OK] U4: 1 SW、2 GND、3 FB、4 EN、5 VIN、6 NC
[OK] U4: 出力 = 0.6V × (1 + R1/R2) が 12V ± 8% の中 (PCIe の許す幅)
       R11/R12 -> 12.36V
[OK] U4: コイルは VIN と SW の間、D4 は SW から +12V_BOOST
[OK] U4 の EN は抵抗で GND に落ちている (マイコンが空・リセット中は昇圧しない)
       ['R13'] 100k
[OK] U4 の EN につながるのは U4・プルダウン・マイコンの PC3 だけ
[OK] Q1: 1 G = Q1_G、2 S = +12V_BOOST、3 D = +12V_SW (ボディダイオードは出力から昇圧の側を向く)
[OK] Q1 (AO3401A、Vgs の最大 ±12V): ゲートはソースへ抵抗で引かれ (ふだんはオフ)、オンのときの Vgs は -4.5V から -12V の中。VIN が 20V (昇圧の出力に 19.5V が素通し) でも -12V を超えない
       R14/R15 -> Vgs = -4.9V、VIN 20V のとき -7.8V
[OK] Q1: ドレイン-ゲートの間に 33nF (立ち上がりを緩める)、ゲート-ソースの間に 1µF。挿した瞬間に容量の分圧でできる Vgs が 0.5V (Vth の最小) より小さい
       C32 33nF / C20 1.0µF: 9V の PD (VIN 8.6V) で -0.27V、20V の異常 (19.6V) で -0.63V。波形は out/sim/
[OK] Q2: 1 G = Q2_G、3 D = Q2_D、2 S = Q2_S。ゲートは抵抗で GND に落ちている (マイコンが空なら 12V は出ない)。マイコンの SW12_ON からは 10kΩ を通る
[OK] 過電圧の遮断: D7 (カソード = VIN) -> R35 -> Q4 のベース、R36 でベースを GND へ、Q4 のコレクタ = Q2 のゲート
[OK] 過電圧の遮断: 9V の PD (VIN の最大 9.5V) では必ず入り、15V では必ず切れる
       効きはじめる VIN 12.2〜13.6V、確実に切れるのは 13.8V 以上。15V のときベース電流 0.14 mA (要るのは 0.015 mA)
[OK] Q1: 過電圧の遮断が効く手前 (VIN が最大でも上の値) まで入っていても、Vgs は -12V の中
       昇圧の出力が VIN の素通しで 13.8V になっても Vgs = -5.5V (最大定格 ±12V。データシートで確認)
[OK] Q3: 1 G = +3V3、3 D = Q2_S、2 S = GND (3.3V が無ければ、Q1 のゲートを引く道が切れて 12V は出ない)
[OK] F1 (PTC): Q1 の出力 (+12V_SW) と JP2 (+12V_F) の間
[OK] +12V の線に GND への抵抗がある (切ったあと 0V まで下げる)
       R18
[OK] U6: 1 GND、2 VIN、3 VOUT = +5V。入力と出力に 10µF
[OK] U7: ピンの割り当てが README の表のとおり (ADC は A7・A5・A6・A1・A0、I2C は PC1/PC2 と PC5/PC6、SWIO は PD1)
[OK] J5: 1 = SWIO、2 = GND
[OK] JP7 (開いたはんだジャンパー): マイコンの入力 SW1_IN と GND の間。入力は +5V へプルアップ
[OK] VIN_SENSE: VIN が 3〜20V (TVS が抑える上限) のどこでも、ピンの電圧 ≤ マイコンの電源
       比 0.248: 5V->1.24V, 9V->2.23V, 20V->4.96V (電源 5.0V)。余裕の最小 0.04V @ 20.0V
[OK] VIN_SENSE: VIN からマイコンのピンへは抵抗を通る (直結していない)
[OK] VBUS1_SENSE: VBUS1 が 3〜20V (TVS が抑える上限) のどこでも、ピンの電圧 ≤ マイコンの電源
       比 0.248: 5V->1.24V, 9V->2.23V, 20V->4.96V (電源 5.0V)。余裕の最小 0.04V @ 20.0V
[OK] VBUS1_SENSE: VBUS1 からマイコンのピンへは抵抗を通る (直結していない)
[OK] 12V_SENSE: +12V が 3〜20V (TVS が抑える上限) のどこでも、ピンの電圧 ≤ マイコンの電源
       比 0.248: 5V->1.24V, 9V->2.23V, 20V->4.96V (電源 5.0V)。余裕の最小 0.04V @ 20.0V
[OK] 12V_SENSE: +12V からマイコンのピンへは抵抗を通る (直結していない)
[OK] CC1_SENSE: J1_CC1 から直列の抵抗を通る。CC が 20V に触れても、ピンへ流れ込む電流は 4mA (最大定格) 未満
       R21 100kΩ -> 0.15 mA。ふだんの CC は 2.1V 以下
[OK] J1_CC1 につながるのは端子・PD の IC・直列の抵抗だけ (PD の通信の線にコンデンサを直接ぶら下げない)
[OK] CC2_SENSE: J1_CC2 から直列の抵抗を通る。CC が 20V に触れても、ピンへ流れ込む電流は 4mA (最大定格) 未満
       R22 100kΩ -> 0.15 mA。ふだんの CC は 2.1V 以下
[OK] J1_CC2 につながるのは端子・PD の IC・直列の抵抗だけ (PD の通信の線にコンデンサを直接ぶら下げない)
[OK] PERST#: +3V3 へ抵抗、GND へコンデンサ。2.0V に届くまで 100ms 以上 (PCIe の T_PVPERL)
       R27·C31: τ = 150 ms、2.0V まで 140 ms
[OK] PERST#: D6 が抵抗に並列 (3.3V が落ちたらコンデンサをすぐ空にする)。マイコンの PC4 へは直列 1kΩ を通る
       PC4 が Low のとき PERST# = 3.3V × 1k / (R27 + 1k) = 0.21V (Low の上限 0.8V より下)
[OK] F1 (PTC): 保持電流 1.1A (25℃)・定格 16V 以上。60℃ / 70℃ でも 0.5A 以上 (データシートの表の値)
       1206L110/16NR (C7542961): 25℃ 1.1A、60℃ 0.72A、70℃ 0.66A、16V
[OK] VIN・VBUS・12V の線のコンデンサは耐圧 25V 以上
       すべて 25V か 50V
[OK] 部品を載せるものには全部 LCSC の品番がある (J4 も載せる)
       115 個中、載せないのは TP・H・はんだジャンパー・1x2 のピンヘッダ (J5・JP1・JP2)
[OK] 全部の部品にフットプリントがある
[OK] ピンが 1 つしか乗っていないネットはない (ラベルの書き違いがない)

結果: 84 項目中 OK 84、NG 0
