danything/outboard/out/dimensions.pdf

bracket | inner face -> board edge mouth beyond board edge 39.0 | 7.0 CARD: A (solder) side up, B (component) side down. Continues to the right - length not published, measure card PCB end x = 0.90 (pin 1 - 45.65) H1 (3.5, 3.5) H3 (5.0, 59.5) J2 (charger) J1 (PC) | LED 3V3 / STAT pin 1 | USB-C mouth face = bracket outer face (difference 0.00)
card PCB H2 (80.5, 3.5) H4 (80.5, 59.5) 18.42 (est) bracket | 43.0 step | 30.5 | 12.2 | BRACKET (est) | 47.0 slot centre | 1.94 (est)

J4

J3 PCIe x1

0.86

0.99

1.63 bracket

(est) = estimated value, to be measured on the real card and case before ordering: - pin 1 centre to bracket outer face 47.54 (from a KiCad library built from PCIe CEM 1.2; CEM itself not read) - bracket plate 0.86 thick, 18.42 wide: 2.06 (up to 2.5 by another reading) to the A side and 16.36 to the B side of the slot centre line (derived from PCIe CEM 2.0 figures 6-4 and 6-16) - the bracket tongue goes below the board top surface (about 11.8 standard / 7.7 low profile), so the edge is set back 1.5 mm for y >= 43 USB-C mouth 0.99 beyond the board edge: outline of the JLCPCB (EasyEDA) footprint of TYPE-C-31-M-12; board edge

is 5.79 from the rear shell legs (datasheet drawing). Case panel: inner face = bracket plate, so the mouth

sticks 0.86 into the panel hole when the bracket is 0.86 thick. | USB-C J1 BOARD

top view, mm. left: whole board 1:1. right: detail x6. origin (0, 0) = top-left corner of the board, x right, y down.

47.54 (est) USB-C mouth = bracket outer face -> pin 1

84.0 | 63.0

## PCIe tuner external power board rev C - bracket / USB-C / board edge
