danything/outboard/out/board-bottom.png

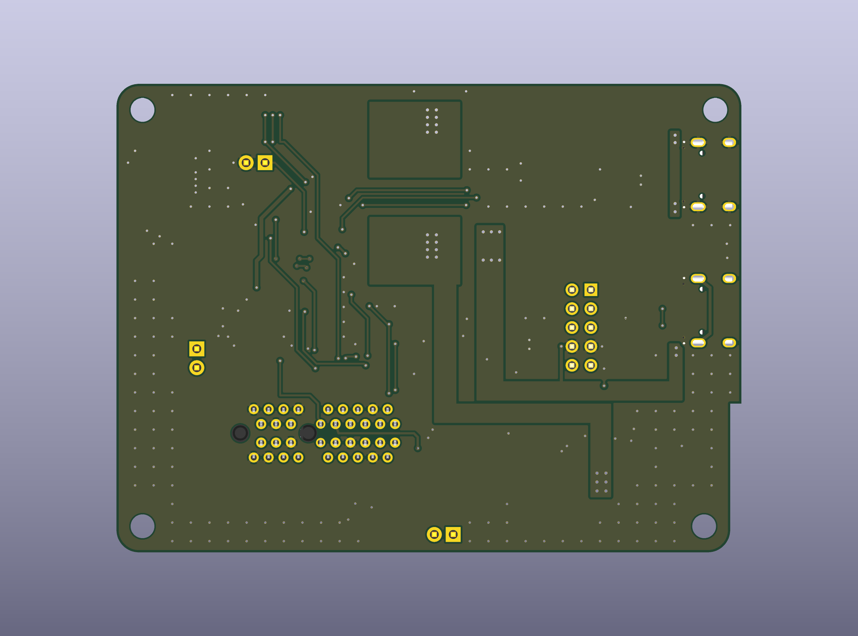
out/board-bottom.png
