danything/outboard/out/sim/off.png

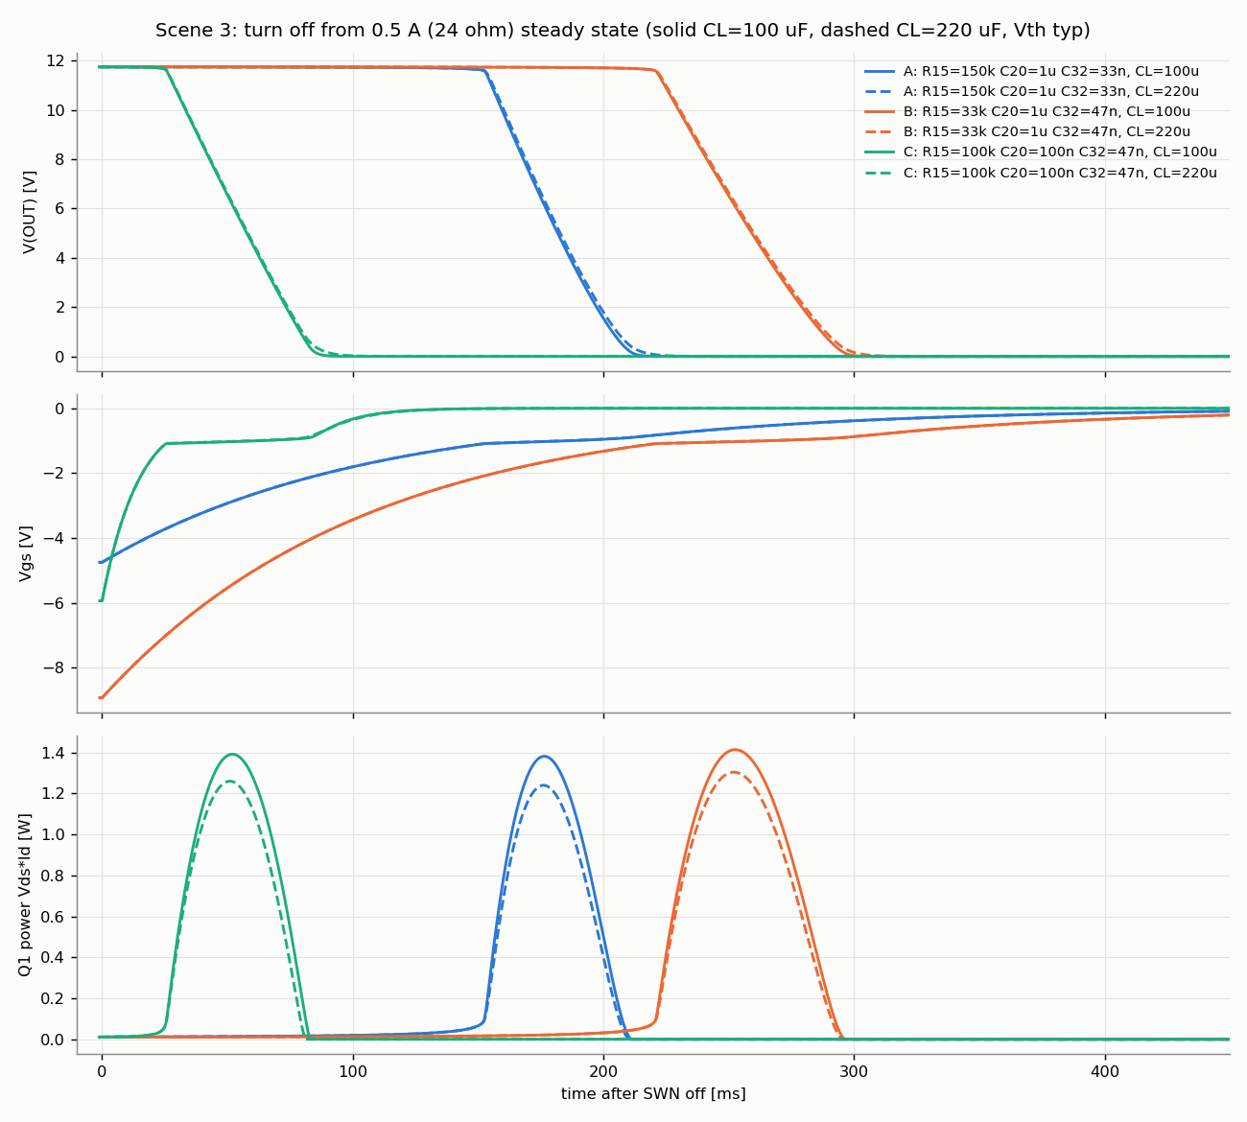
out/sim/off.png
