danything/outboard/out/sim/on.png

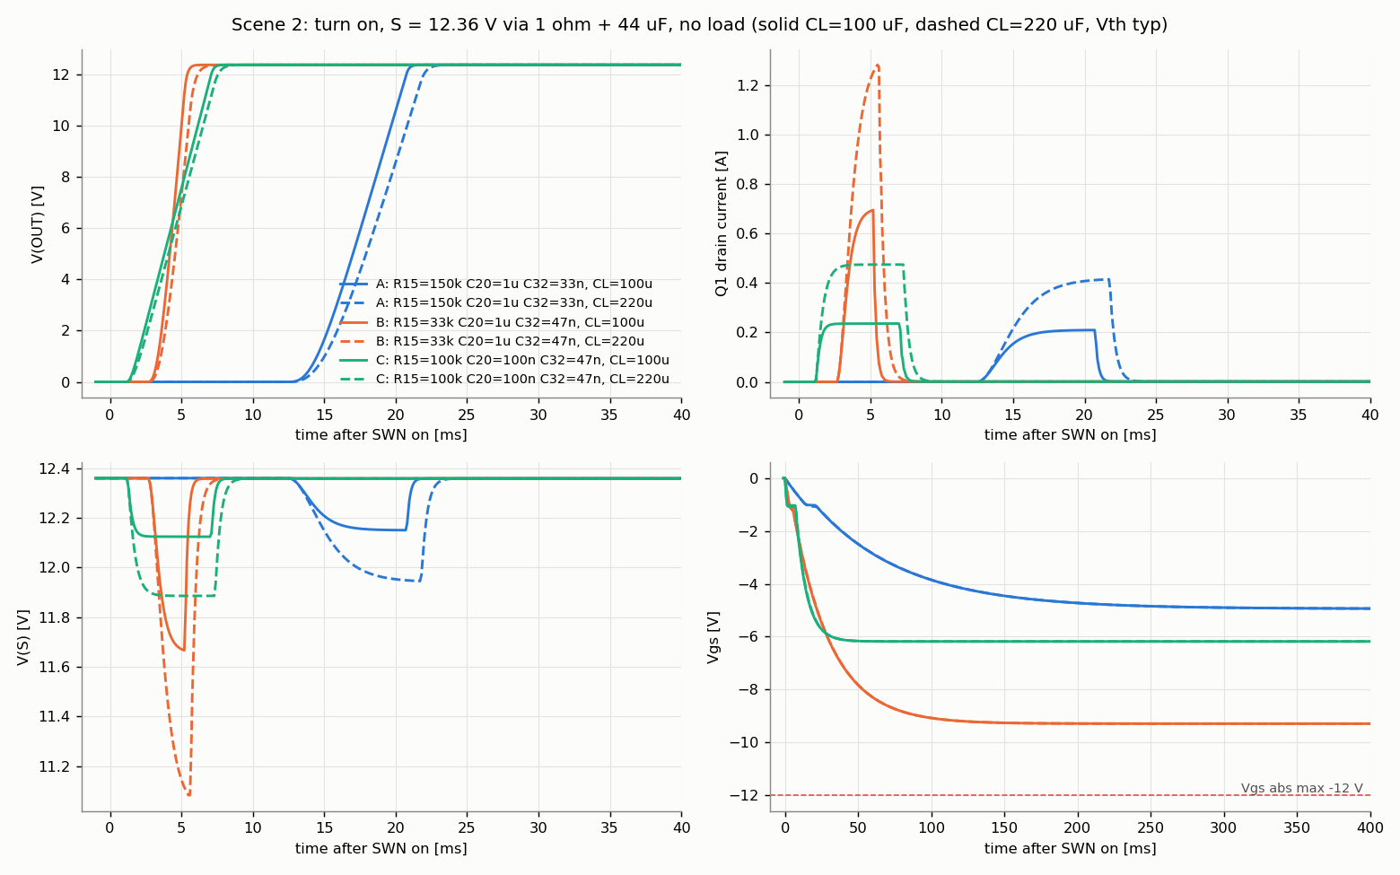
out/sim/on.png
