danything/outboard/out/sim/plug.png

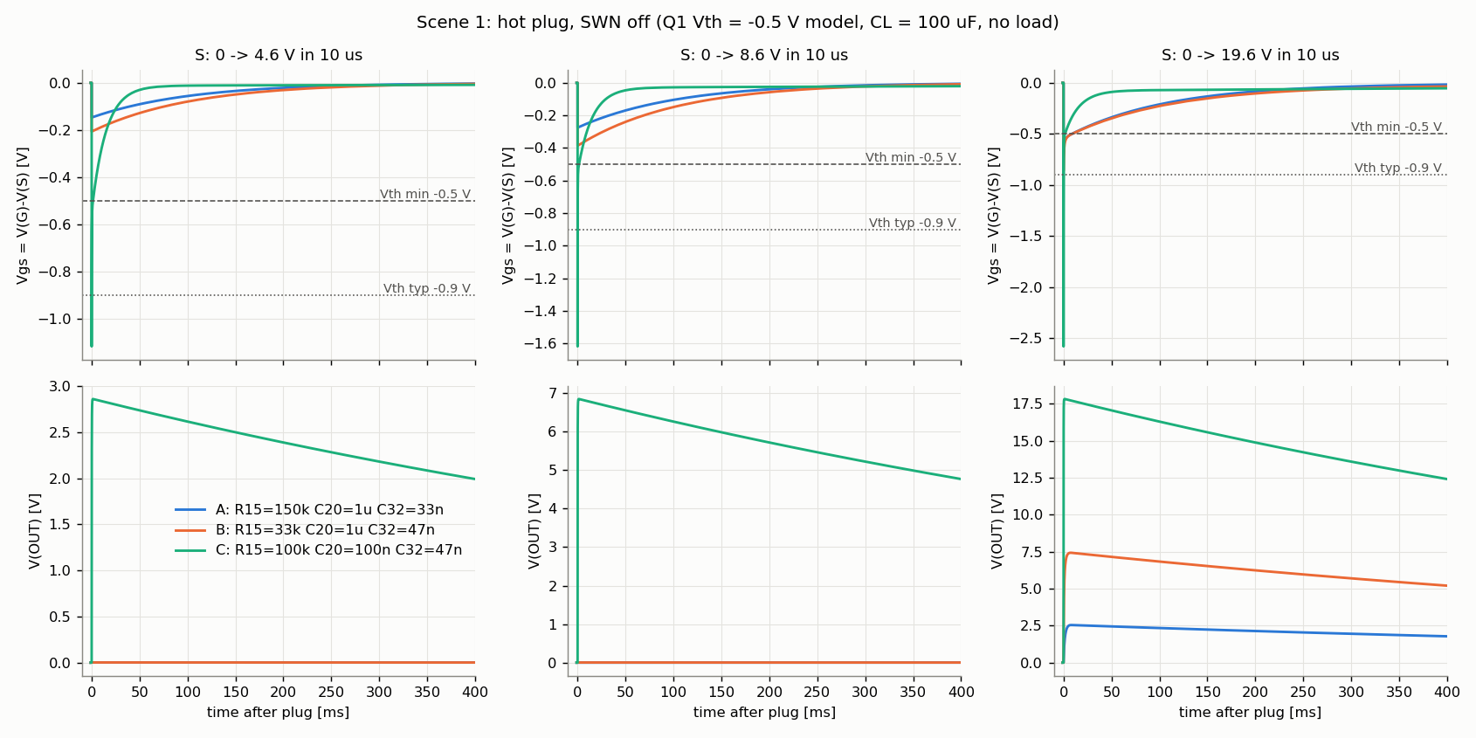
out/sim/plug.png
