danything/outboard/out/sim/short.png

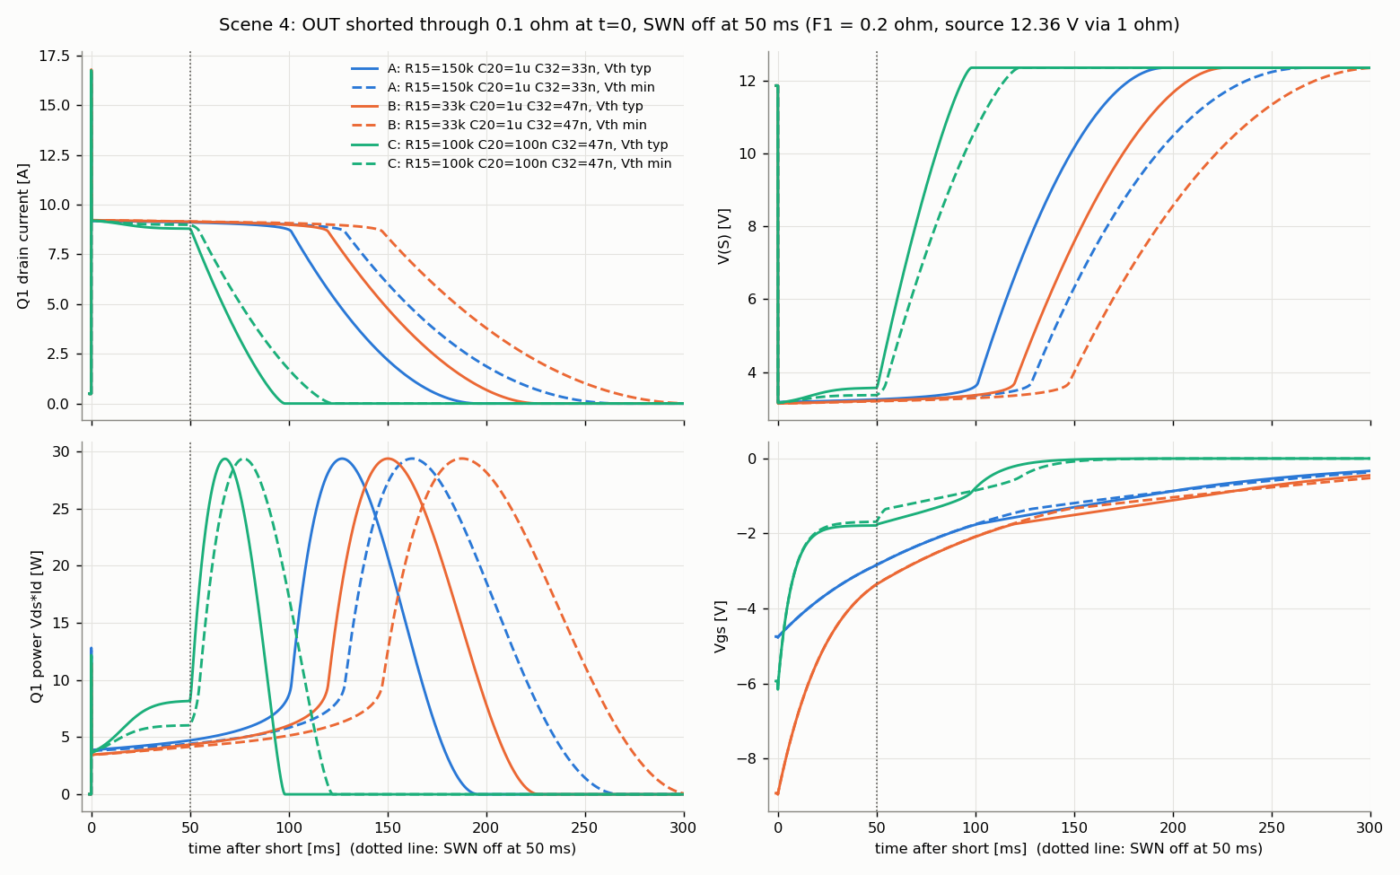
out/sim/short.png
