danything/outboard/scripts/lcsc_parts.txt

# LCSC の品番  用途 (easyeda2kicad でシンボル・フットプリント・3D を作る部品の一覧)
C165948   J1 J2 USB-C TYPE-C-31-M-12
C404113   J3 PCIe x1 3183-10200P1T
C492422   J4 2x5 PZ254V-12-10P
C492401   JP1 JP2 J5 1x2 PZ254V-11-02P
C42459160 U1 U2 CH224A
C3200405  U3 TPS62933DRLR
C19189893 U4 MT3608B
C85364    U5 SRV05-4-P-T7
C16106    U6 HT7550-1
C5187096  U7 CH32V003F4P6
C15155    Q1 AO3407A
C8545     Q2 2N7002
C22452    D1 D2 SS54
C19077506 D3 SMF12A
C8678     D4 SS34
C167220   L1 L2 FXL0630-4R7-M
C431540   SW1 MSK12C02
C2290     LED white KT-0603W
C2286     LED red KT-0603R
C23212    R 6.8k 0603
C25804    R 10k 0603
C21190    R 1k 0603
C25803    R 100k 0603
C23186    R 5.1k 0603
C22935    R 1M 0603
C14663    C 100nF 50V 0603
C15849    C 1uF 50V 0603
C15850    C 10uF 25V 0805
C45783    C 22uF 25V 0805
C1621     C 4.7nF 50V 0603
C25819    R 47k 0603
C22809    R 15k 0603
C23231    R 68k 0603
C4216     R 33k 0603
C23162    R 4.7k 0603
C81598    D 1N4148W SOD-123
C15127    Q1 AO3401A (rev B)
C70079    F1 nSMD075-13.2V PTC 1206 (rev B)
C1622     C 47nF 50V 0603 (rev B)
C22975    R 2k 0603 (rev B)
C22395569 D7 BZT52B12 zener 12V 2% SOD-123 (rev B)
C20526    Q4 MMBT3904 (rev B)
C70080    F1 nSMD075-16V PTC 0.75A 16V 1206 (rev B)
C7542961  F1 1206L110/16NR PTC 1.1A 16V 1206 (rev C)
C17513    R 1k 0805 (rev C, bleeders)
C22807    R 150k 0603 (rev C)
C21117    C 33nF 50V 0603 (rev C)
C21263091 J3 PCIe x1 straddle X1613WS-36D-9TV01 (rev D)
C492433   J4 2x5 right angle PZ254R-12-10P (rev D)
