danything/outboard/fab/bom.csv

Comment | Designator | Footprint | LCSC Part #
CL10A105KB8NNNC 1uF 50V | C1,C3,C15,C20,C22 | C0603 | C15849
CC0603KRX7R9BB104 100nF 50V | C2,C10,C11,C12,C17,C21,C23,C24,C25,C26,C28,C30,C33 | C0603 | C14663
CL21A226MAQNNNE 22uF 25V | C4,C5,C13,C14,C16,C18,C19,C27 | C0805 | C45783
CL21A106KAYNNNE 10uF 25V | C6,C7,C8,C9,C29,C31 | C0805 | C15850
CL10B333KB8NNNC 33nF 50V | C32 | C0603 | C21117
SS54 | D1,D2 | SMA_L4.4-W2.8-LS5.4-R-RD | C22452
SS34 | D4 | SMA_L4.3-W2.6-LS5.2-RD | C8678
1N4148W | D5,D6 | SOD-123F_L2.7-W1.6-LS3.8-RD | C81598
BZT52B12 | D7 | SOD-123_L2.7-W1.6-LS3.7-RD | C22395569
1206L110/16NR | F1 | F1206 | C7542961
TYPE-C-31-M-12 | J1,J2 | USB-C_SMD-TYPE-C-31-M-12_1 | C165948
3183-10200P1T PCIe x1 slot | J3 | CONN-TH_36P-P1.00-V_3183-XXXXXPXT | C404113
PZ254V-12-10P J4 USB header | J4 | HDR-TH_10P-P2.54-V-M-R2-C5-S2.54 | C492422
FXL0630-4R7-M 4.7uH FXL0630 | L1,L2 | IND-SMD_L7.0-W6.6 | C167220
KT-0603R Red | LED3,LED5 | LED-SMD_L1.6-W0.8-R-RD | C2286
AO3401A | Q1 | SOT-23_L2.9-W1.3-P1.90-LS2.4-BR | C15127
2N7002 | Q2,Q3 | SOT-23-3_L2.9-W1.3-P1.90-LS2.4-BR | C8545
MMBT3904 | Q4 | SOT-23-3_L2.9-W1.3-P1.90-LS2.4-BR | C20526
0603WAF6801T5E 6.8k | R1,R4 | R0603 | C23212
0603WAF1004T5E 1M | R3 | R0603 | C22935
0603WAF4702T5E 47k | R6 | R0603 | C25819
0603WAF1502T5E 15k | R7,R27 | R0603 | C22809
0603WAF1003T5E 100k | R8,R11,R13,R14,R16,R21,R22,R23,R25,R32 | R0603 | C25803
0603WAF6802T5E 68k | R9 | R0603 | C23231
0603WAF1001T5E 1k | R10,R20,R37,R38 | R0603 | C21190
0603WAF5101T5E 5.1k | R12 | R0603 | C23186
0603WAF1503T5E 150k | R15 | R0603 | C22807
0603WAF1002T5E 10k | R18,R19,R34,R35,R36 | R0603 | C25804
0603WAF3302T5E 33k | R24,R26,R33 | R0603 | C4216
0805W8F1001T5E 1k | R28,R29,R30,R31,R39,R40,R41,R42 | R0805 | C17513
CH224A | U1,U2 | ESSOP-10_L4.9-W3.9-P1.0-LS6.0-TL-EP | C42459160
TPS62933DRLR | U3 | SOT-583-8_L2.1-W1.2-P0.50-LS1.6-BR | C3200405
MT3608B | U4 | SOT-23-6_L2.9-W1.6-P0.95-LS2.8-BR | C19189893
SRV05-4-P-T7 | U5 | SOT-23-6_L2.9-W1.6-P0.95-LS2.8-BR | C85364
HT7550-1 | U6 | SOT-89-3_L4.5-W2.5-P1.50-LS4.2-BR | C16106
CH32V003F4P6 | U7 | TSSOP-20_L6.5-W4.4-P0.65-LS6.4-BL | C5187096
