danything/outboard/out/sim/results.csv

scene | plan | vth | vin_V | rise | CL | load | vgs_min_V | t_absvgs_gt_0p5_ms | vd_max_V | vout_max_V | id_max_mA | CS | vbst_V | vout_final_V | t_delay_10pct_ms | t_rise_10_90_ms | slew_V_per_ms | id_max_A | s_min_V | s_dip_V | vgs_final_V | vout_start_V | t_delay_90pct_ms | t_fall_90_10_ms | t_to_0p5V_ms | e_q1_mJ | e_q1_fall_only_mJ | p_max_W | id_at_50ms_A | s_at_50ms_V | vgs_at_50ms_V | e_q1_50ms_mJ | p_at_50ms_W | t_stop_after_off_ms | e_q1_after_off_mJ
plug | A | typ | 4.6 | 10u | 100u | none | -0.1471 | 0.0 | 0.0043 | 0.0013 | 0.0362
plug | A | typ | 4.6 | 100u | 100u | none | -0.147 | 0.0 | 0.0016 | 0.0013 | 0.0036
plug | A | typ | 4.6 | 1m | 100u | none | -0.1464 | 0.0 | 0.0014 | 0.0013 | 0.0004
plug | A | typ | 8.6 | 10u | 100u | none | -0.2749 | 0.0 | 0.008 | 0.0025 | 0.0677
plug | A | typ | 8.6 | 100u | 100u | none | -0.2748 | 0.0 | 0.0031 | 0.0025 | 0.0067
plug | A | typ | 8.6 | 1m | 100u | none | -0.2736 | 0.0 | 0.0026 | 0.0025 | 0.0007
plug | A | typ | 19.6 | 10u | 100u | none | -0.6266 | 23.241 | 0.0183 | 0.0057 | 0.1543
plug | A | typ | 19.6 | 100u | 100u | none | -0.6263 | 23.323 | 0.007 | 0.0057 | 0.0154
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
