danything/outboard/out/assembly-top.pdf

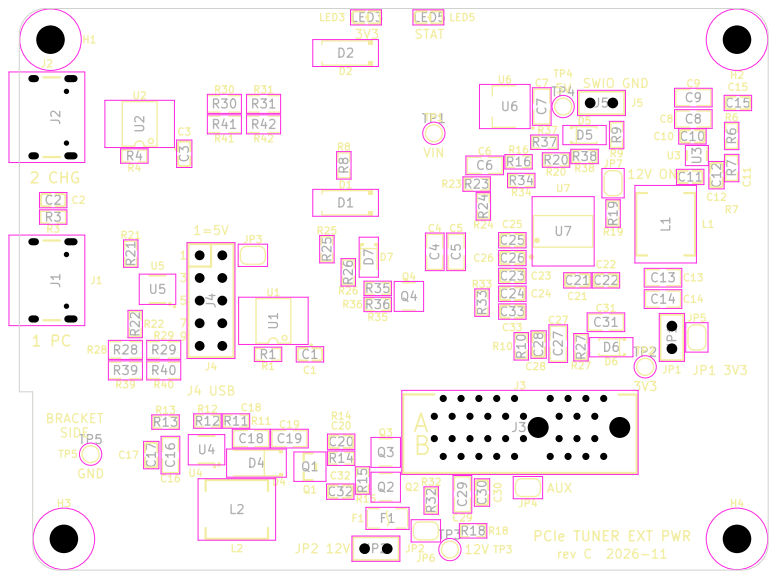
[picture p7: page 1]

9 BRACKET SIDEGND
JP1 3V3 PCIe TUNER EXT PWR 1 PC
