danything/outboard/out/board-layers.pdf

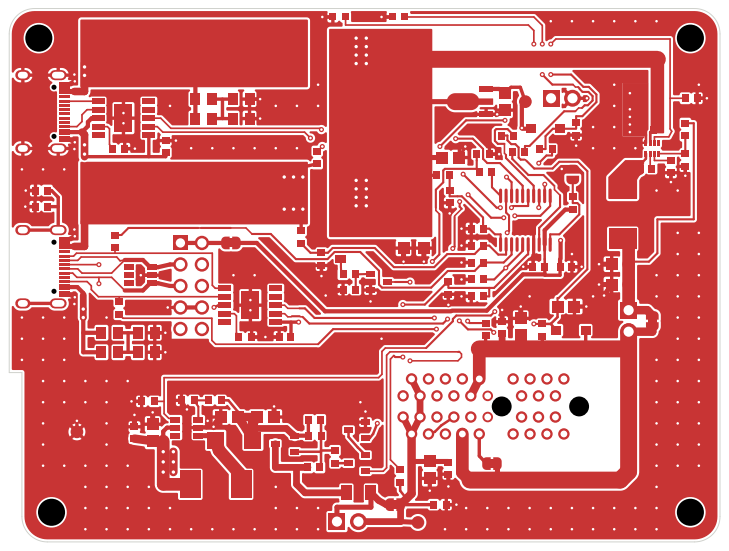
[picture p9: page 1]

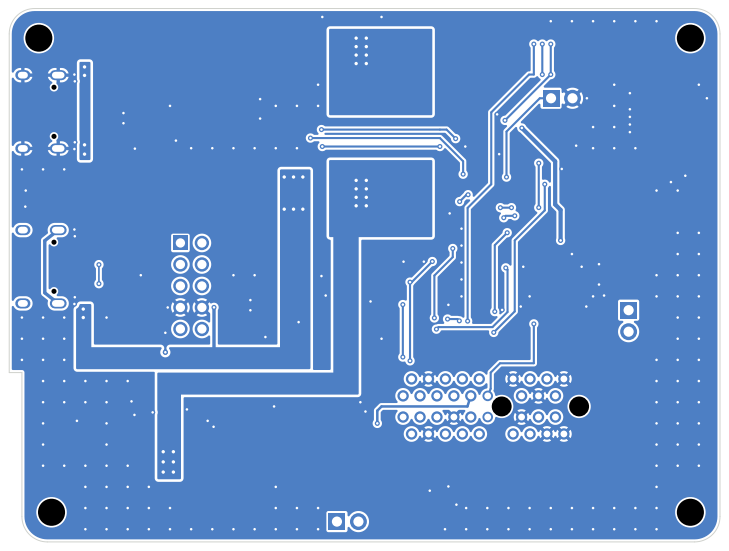
[picture p10: page 2]

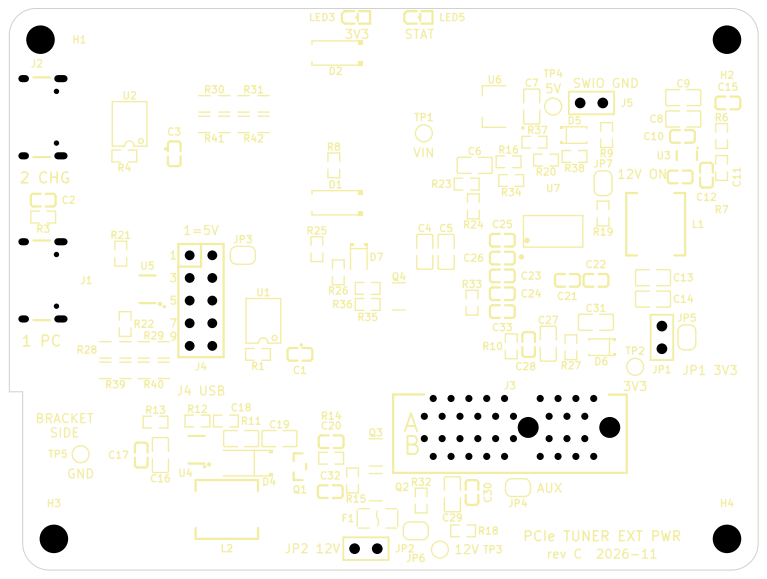
[picture p11: page 3]

9 BRACKET SIDEGND
JP1 3V3 PCIe TUNER EXT PWR 1 PC

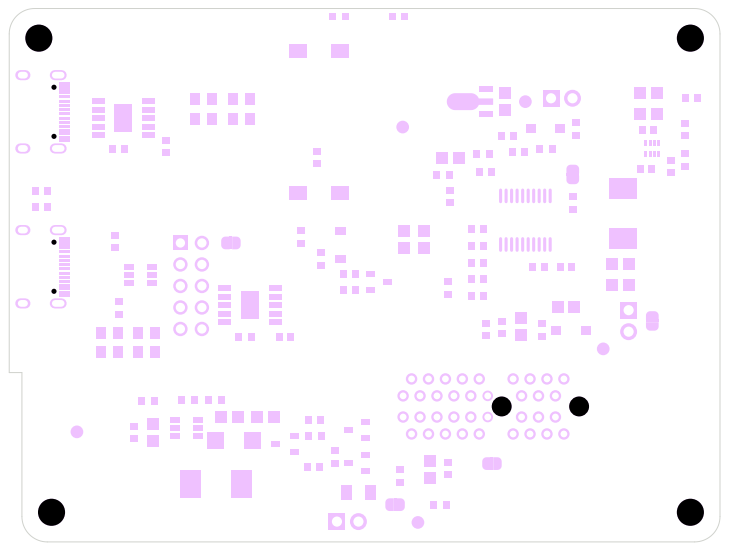
[picture p12: page 4]
