danything/outboard/out/sim/on.cir

* on.cir - scene 2: turn on. S fed from VBST through RSRC, SWN closes at t = 1 ms
.param VBST=12.36
.param RSRC=1
.param R14=100k
.param R15=150k
.param C20=1u
.param C32=33n
.param CL=100u
.param RL=1e9
.param VTO=-0.9
.param CS=44u
VB   src 0 {VBST}
RSRC src s {RSRC}
CS   s 0 {CS}
VCTL ctl 0 PWL(0 0 1m 0 1.001m 1)
.include hs_switch.cir
.tran 20u 700m 0 100u
.end
