danything/outboard/pcie-tuner-board.kicad_pcb

## KiCad design pcie-tuner-board.kicad_pcb (2026-11-12)

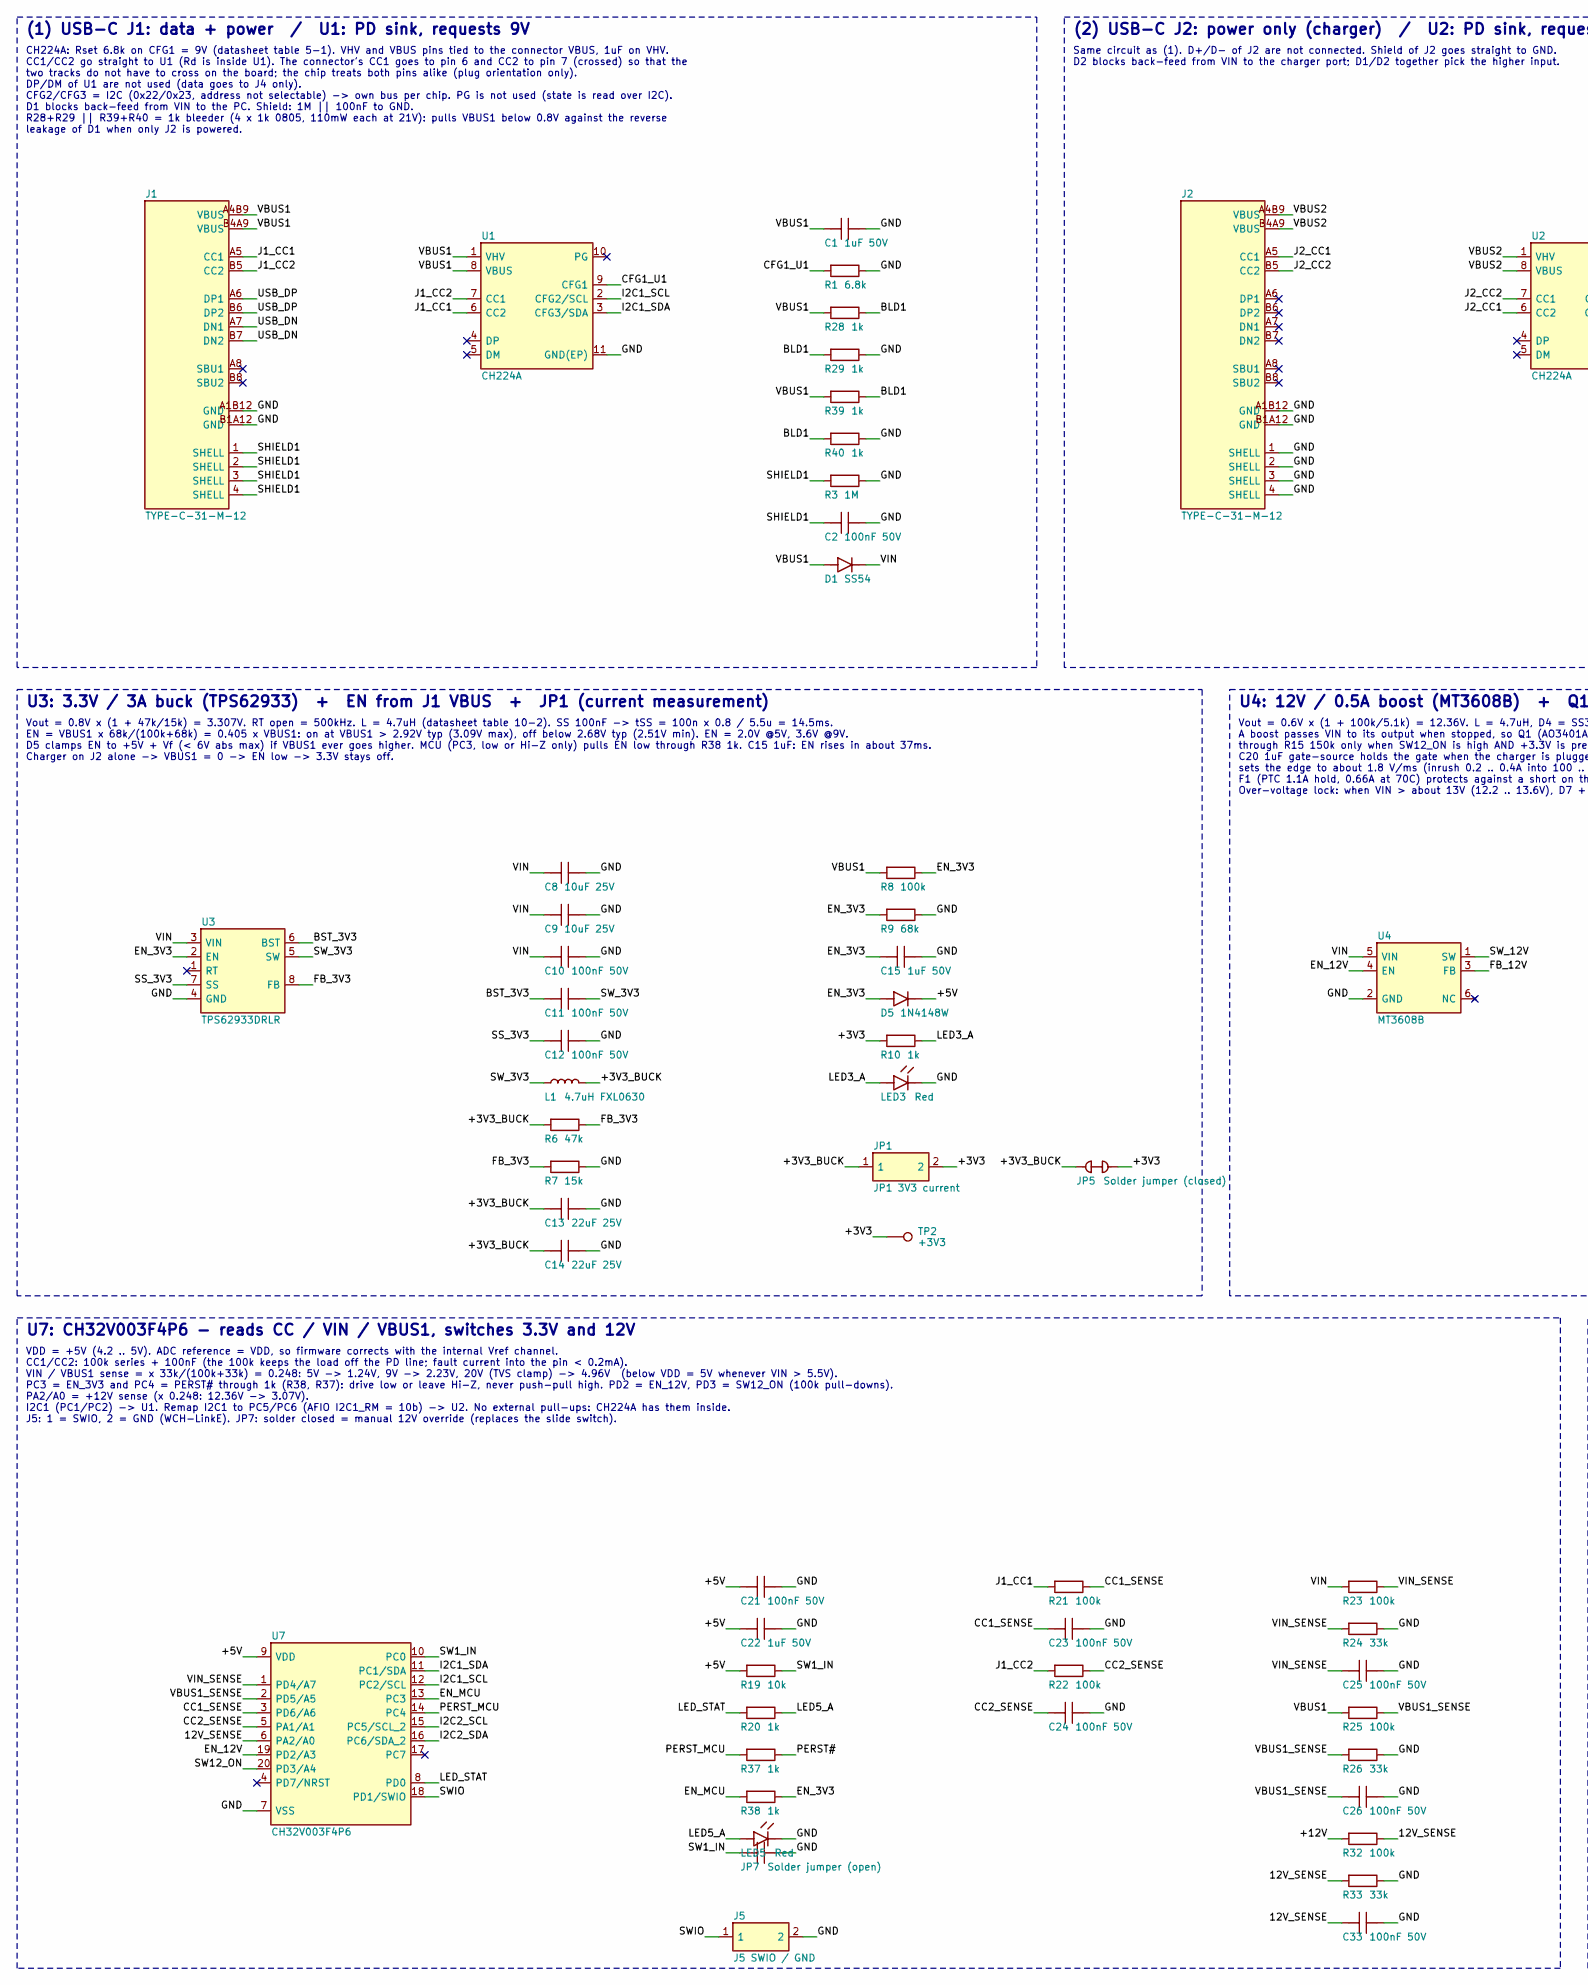
[picture p13: schematic pcie-tuner-board.kicad_sch, outboard - PCIe tuner external power board, part in row 1, column 1]

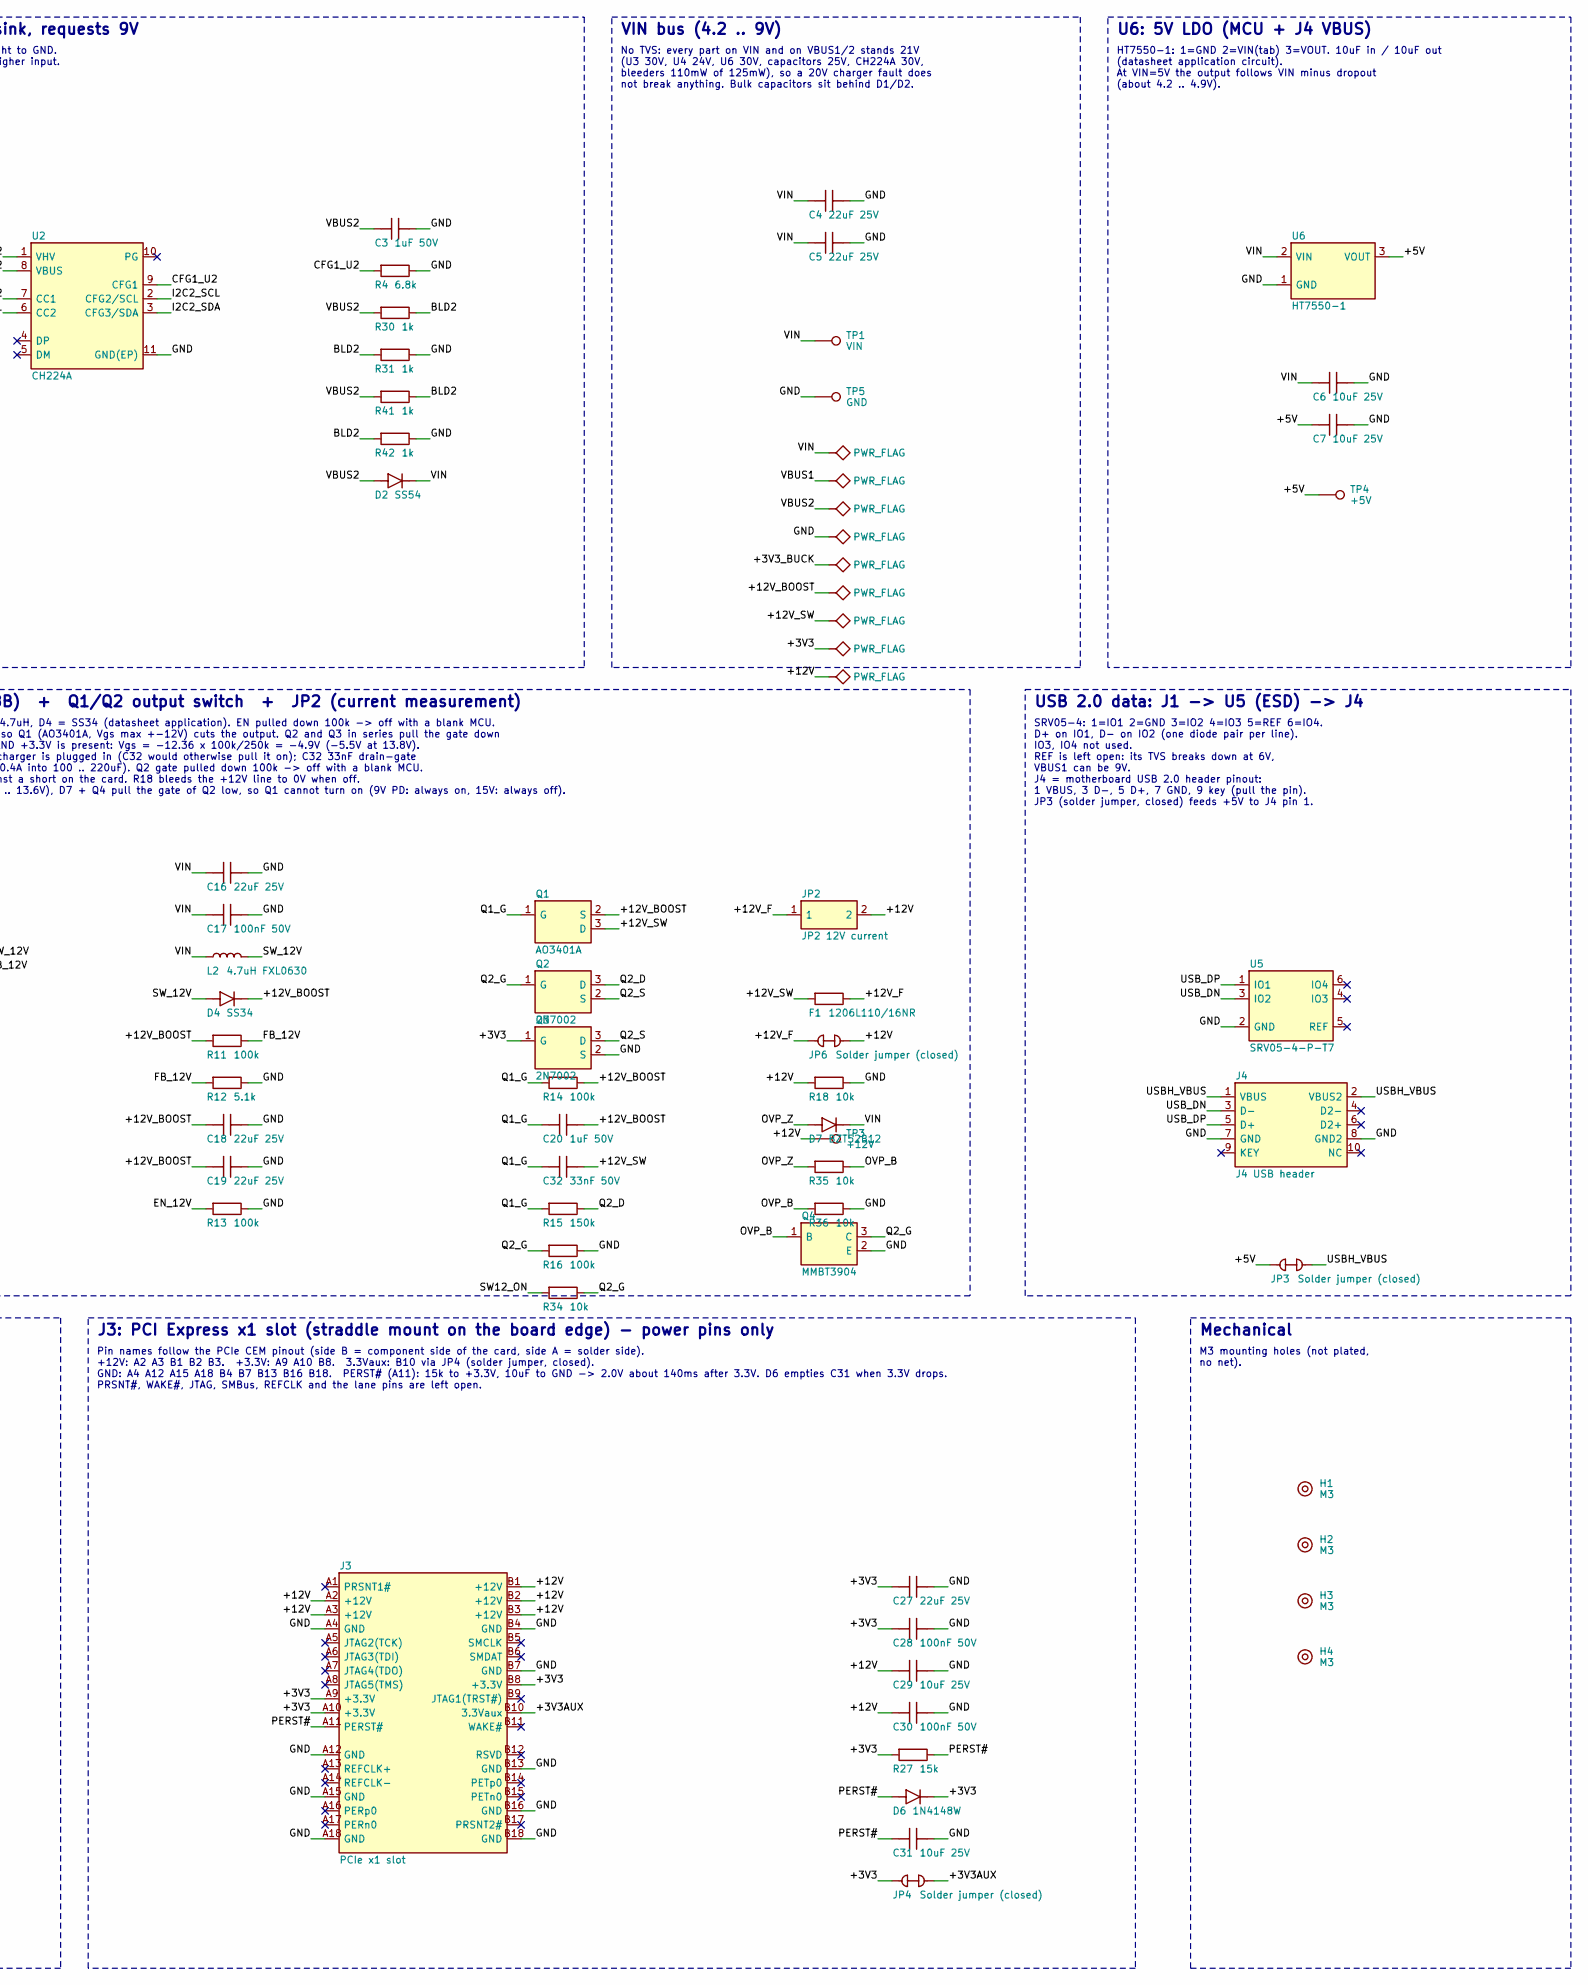
[picture p14: schematic pcie-tuner-board.kicad_sch, outboard - PCIe tuner external power board, part in row 1, column 2]

Parts:
C1, C3, C15, C20, C22: 1uF 50V; C0603; MPN CL10A105KB8NNNC; LCSC C15849
C2, C10, C11, C12, C17, C21, C23, C24, C25, C26, C28, C30, C33: 100nF 50V; C0603; MPN CC0603KRX7R9BB104; LCSC C14663
C4, C5, C13, C14, C16, C18, C19, C27: 22uF 25V; C0805; MPN CL21A226MAQNNNE; LCSC C45783
C6, C7, C8, C9, C29, C31: 10uF 25V; C0805; MPN CL21A106KAYNNNE; LCSC C15850
C32: 33nF 50V; C0603; MPN CL10B333KB8NNNC; LCSC C21117
D1, D2: SS54; SMA_L4.4-W2.8-LS5.4-R-RD; MPN SS54; LCSC C22452
D4: SS34; SMA_L4.3-W2.6-LS5.2-RD; MPN SS34; LCSC C8678
D5, D6: 1N4148W; SOD-123F_L2.7-W1.6-LS3.8-RD; MPN 1N4148W; LCSC C81598
D7: BZT52B12; SOD-123_L2.7-W1.6-LS3.7-RD; MPN BZT52B12; LCSC C22395569
F1: 1206L110/16NR; F1206; MPN 1206L110/16NR; LCSC C7542961
H1, H2, H3, H4: M3; MountingHole_3.2mm_M3
J1, J2: TYPE-C-31-M-12; USB-C_SMD-TYPE-C-31-M-12_1; MPN TYPE-C-31-M-12; LCSC C165948
J3: PCIe x1 slot; CONN-SMD_36P-P1.00_X1613WS-36-9TV01; MPN X1613WS-36D-9TV01; LCSC C21263091
J4: J4 USB header; HDR-TH_10P-P2.54-H-M-R2-C5-S2.54; MPN PZ254R-12-10P; LCSC C492433
J5: J5 SWIO / GND; HDR-TH_2P-P2.54-V-M; MPN PZ254V-11-02P
JP1: JP1 3V3 current; HDR-TH_2P-P2.54-V-M; MPN PZ254V-11-02P
JP2: JP2 12V current; HDR-TH_2P-P2.54-V-M; MPN PZ254V-11-02P
JP3, JP4, JP5, JP6: Solder jumper (closed); SolderJumper-2_P1.3mm_Bridged_RoundedPad1.0x1.5mm
JP7: Solder jumper (open); SolderJumper-2_P1.3mm_Open_RoundedPad1.0x1.5mm
L1, L2: 4.7uH FXL0630; IND-SMD_L7.0-W6.6; MPN FXL0630-4R7-M; LCSC C167220
LED3, LED5: Red; LED-SMD_L1.6-W0.8-R-RD; MPN KT-0603R; LCSC C2286
Q1: AO3401A; SOT-23_L2.9-W1.3-P1.90-LS2.4-BR; MPN AO3401A; LCSC C15127
Q2, Q3: 2N7002; SOT-23-3_L2.9-W1.3-P1.90-LS2.4-BR; MPN 2N7002; LCSC C8545
Q4: MMBT3904; SOT-23-3_L2.9-W1.3-P1.90-LS2.4-BR; MPN MMBT3904; LCSC C20526
R1, R4: 6.8k; R0603; MPN 0603WAF6801T5E; LCSC C23212
R3: 1M; R0603; MPN 0603WAF1004T5E; LCSC C22935
R6: 47k; R0603; MPN 0603WAF4702T5E; LCSC C25819
R7, R27: 15k; R0603; MPN 0603WAF1502T5E; LCSC C22809
R8, R11, R13, R14, R16, R21, R22, R23, R25, R32: 100k; R0603; MPN 0603WAF1003T5E; LCSC C25803
R9: 68k; R0603; MPN 0603WAF6802T5E; LCSC C23231
R10, R20, R37, R38: 1k; R0603; MPN 0603WAF1001T5E; LCSC C21190
R12: 5.1k; R0603; MPN 0603WAF5101T5E; LCSC C23186
R15: 150k; R0603; MPN 0603WAF1503T5E; LCSC C22807
R18, R19, R34, R35, R36: 10k; R0603; MPN 0603WAF1002T5E; LCSC C25804
R24, R26, R33: 33k; R0603; MPN 0603WAF3302T5E; LCSC C4216
R28, R29, R30, R31, R39, R40, R41, R42: 1k; R0805; MPN 0805W8F1001T5E; LCSC C17513
TP1: VIN; TestPoint_Pad_D1.5mm
TP2: +3V3; TestPoint_Pad_D1.5mm
TP3: +12V; TestPoint_Pad_D1.5mm
TP4: +5V; TestPoint_Pad_D1.5mm
TP5: GND; TestPoint_Pad_D1.5mm
U1, U2: CH224A; ESSOP-10_L4.9-W3.9-P1.0-LS6.0-TL-EP; MPN CH224A; LCSC C42459160
U3: TPS62933DRLR; SOT-583-8_L2.1-W1.2-P0.50-LS1.6-BR; MPN TPS62933DRLR; LCSC C3200405
U4: MT3608B; SOT-23-6_L2.9-W1.6-P0.95-LS2.8-BR; MPN MT3608B; LCSC C19189893
U5: SRV05-4-P-T7; SOT-23-6_L2.9-W1.6-P0.95-LS2.8-BR; MPN SRV05-4-P-T7; LCSC C85364
U6: HT7550-1; SOT-89-3_L4.5-W2.5-P1.50-LS4.2-BR; MPN HT7550-1; LCSC C16106
U7: CH32V003F4P6; TSSOP-20_L6.5-W4.4-P0.65-LS6.4-BL; MPN CH32V003F4P6; LCSC C5187096

Connections:
/12V_SENSE: C33.1, R32.2, R33.1, U7.6 (PA2/A0)
/+3V3: C27.1, C28.1, D6.1 (K), J3.A9 (+3.3V), J3.A10 (+3.3V), J3.B8 (+3.3V), JP1.2, JP4.1, JP5.2, Q3.1 (G), R10.1, R27.1, TP2.1
/+3V3AUX: J3.B10 (3.3Vaux), JP4.2
/+3V3_BUCK: C13.1, C14.1, JP1.1, JP5.1, L1.2, R6.1
/+5V: C7.1, C21.1, C22.1, D5.1 (K), JP3.1, R19.1, TP4.1, U6.3 (VOUT), U7.9 (VDD)
/+12V: C29.1, C30.1, J3.A2 (+12V), J3.A3 (+12V), J3.B1 (+12V), J3.B2 (+12V), J3.B3 (+12V), JP2.2, JP6.2, R18.1, R32.1, TP3.1
/+12V_BOOST: C18.1, C19.1, C20.2, D4.1 (K), Q1.2 (S), R11.1, R14.2
/+12V_F: F1.2, JP2.1, JP6.1
/+12V_SW: C32.2, F1.1, Q1.3 (D)
/BLD1: R28.2, R29.1, R39.2, R40.1
/BLD2: R30.2, R31.1, R41.2, R42.1
/BST_3V3: C11.1, U3.6 (BST)
/CC1_SENSE: C23.1, R21.2, U7.3 (PD6/A6)
/CC2_SENSE: C24.1, R22.2, U7.5 (PA1/A1)
/CFG1_U1: R1.1, U1.9 (CFG1)
/CFG1_U2: R4.1, U2.9 (CFG1)
/EN_3V3: C15.1, D5.2 (A), R8.2, R9.1, R38.2, U3.2 (EN)
/EN_12V: R13.1, U4.4 (EN), U7.19 (PD2/A3)
/EN_MCU: R38.1, U7.13 (PC3)
/FB_3V3: R6.2, R7.1, U3.8 (FB)
/FB_12V: R11.2, R12.1, U4.3 (FB)
/GND: C1.2, C2.2, C3.2, C4.2, C5.2, C6.2, C7.2, C8.2, C9.2, C10.2, C12.2, C13.2, C14.2, C15.2, C16.2, C17.2, C18.2, C19.2, C21.2, C22.2, C23.2, C24.2, C25.2, C26.2, C27.2, C28.2, C29.2, C30.2, C31.2, C33.2, J1.A1B12 (GND), J1.B1A12 (GND), J2.1 (SHELL), J2.2 (SHELL), J2.3 (SHELL), J2.4 (SHELL), J2.A1B12 (GND), J2.B1A12 (GND), J3.A4 (GND), J3.A12 (GND), J3.A15 (GND), J3.A18 (GND), J3.B4 (GND), J3.B7 (GND), J3.B13 (GND), J3.B16 (GND), J3.B18 (GND), J4.7 (GND), J4.8 (GND2), J5.2, JP7.2, LED3.2 (K), LED5.2 (K), Q3.2 (S), Q4.2 (E), R1.2, R3.2, R4.2, R7.2, R9.2, R12.2, R13.2, R16.2, R18.2, R24.2, R26.2, R29.2, R31.2, R33.2, R36.2, R40.2, R42.2, TP5.1, U1.11 (GND(EP)), U2.11 (GND(EP)), U3.4 (GND), U4.2 (GND), U5.2 (GND), U6.1 (GND), U7.7 (VSS)
/I2C1_SCL: U1.2 (CFG2/SCL), U7.12 (PC2/SCL)
/I2C1_SDA: U1.3 (CFG3/SDA), U7.11 (PC1/SDA)
/I2C2_SCL: U2.2 (CFG2/SCL), U7.15 (PC5/SCL_2)
/I2C2_SDA: U2.3 (CFG3/SDA), U7.16 (PC6/SDA_2)
/J1_CC1: J1.A5 (CC1), R21.1, U1.6 (CC2)
/J1_CC2: J1.B5 (CC2), R22.1, U1.7 (CC1)
/J2_CC1: J2.A5 (CC1), U2.6 (CC2)
/J2_CC2: J2.B5 (CC2), U2.7 (CC1)
/LED3_A: LED3.1 (A), R10.2
/LED5_A: LED5.1 (A), R20.2
/LED_STAT: R20.1, U7.8 (PD0)
/OVP_B: Q4.1 (B), R35.2, R36.1
/OVP_Z: D7.2 (A), R35.1
/PERST#: C31.1, D6.2 (A), J3.A11 (PERST#), R27.2, R37.2
/PERST_MCU: R37.1, U7.14 (PC4)
/Q1_G: C20.1, C32.1, Q1.1 (G), R14.1, R15.1
/Q2_D: Q2.3 (D), R15.2
/Q2_G: Q2.1 (G), Q4.3 (C), R16.1, R34.2
/Q2_S: Q2.2 (S), Q3.3 (D)
/SHIELD1: C2.1, J1.1 (SHELL), J1.2 (SHELL), J1.3 (SHELL), J1.4 (SHELL), R3.1
/SS_3V3: C12.1, U3.7 (SS)
/SW1_IN: JP7.1, R19.2, U7.10 (PC0)
/SW12_ON: R34.1, U7.20 (PD3/A4)
/SWIO: J5.1, U7.18 (PD1/SWIO)
/SW_3V3: C11.2, L1.1, U3.5 (SW)
/SW_12V: D4.2 (A), L2.2, U4.1 (SW)
/USBH_VBUS: J4.1 (VBUS), J4.2 (VBUS2), JP3.2
/USB_DN: J1.A7 (DN1), J1.B7 (DN2), J4.3 (D-), U5.3 (IO2)
/USB_DP: J1.A6 (DP1), J1.B6 (DP2), J4.5 (D+), U5.1 (IO1)
/VBUS1: C1.1, D1.1 (A), J1.A4B9 (VBUS), J1.B4A9 (VBUS), R8.1, R25.1, R28.1, R39.1, U1.1 (VHV), U1.8 (VBUS)
/VBUS1_SENSE: C26.1, R25.2, R26.1, U7.2 (PD5/A5)
/VBUS2: C3.1, D2.1 (A), J2.A4B9 (VBUS), J2.B4A9 (VBUS), R30.1, R41.1, U2.1 (VHV), U2.8 (VBUS)
/VIN: C4.1, C5.1, C6.1, C8.1, C9.1, C10.1, C16.1, C17.1, D1.2 (K), D2.2 (K), D7.1 (K), L2.1, R23.1, TP1.1, U3.3 (VIN), U4.5 (VIN), U6.2 (VIN)
/VIN_SENSE: C25.1, R23.2, R24.1, U7.1 (PD4/A7)

Notes on the sheet:
Vout = 0.6V x (1 + 100k/5.1k) = 12.36V. L = 4.7uH, D4 = SS34 (datasheet application). EN pulled down 100k -> off with a blank MCU. A boost passes VIN to its output when stopped, so Q1 (AO3401A, Vgs max +-12V) cuts the output. Q2 and Q3 in series pull the gate down through R15 150k only when SW12_ON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
No TVS: every part on VIN and on VBUS1/2 stands 21V (U3 30V, U4 24V, U6 30V, capacitors 25V, CH224A 30V, bleeders 110mW of 125mW), so a 20V charger fault does not break anything. Bulk capacitors sit behind D1/D2.
Vout = 0.8V x (1 + 47k/15k) = 3.307V. RT open = 500kHz. L = 4.7uH (datasheet table 10-2). SS 100nF -> tSS = 100n x 0.8 / 5.5u = 14.5ms. EN = VBUS1 x 68k/(100k+68k) = 0.405 x VBUS1: on at VBUS1 > 2.92V typ (3.09V max), off below 2.68V typ (2.51V min). EN = 2.0V @5V, 3.6V @9V. D5 clamps EN to +5V + V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
Mechanical
Same circuit as (1). D+/D- of J2 are not connected. Shield of J2 goes straight to GND. D2 blocks back-feed from VIN to the charger port; D1/D2 together pick the higher input.
CH224A: Rset 6.8k on CFG1 = 9V (datasheet table 5-1). VHV and VBUS pins tied to the connector VBUS, 1uF on VHV. CC1/CC2 go straight to U1 (Rd is inside U1). The connector's CC1 goes to pin 6 and CC2 to pin 7 (crossed) so that the two tracks do not have to cross on the board; the chip treats both pi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
USB 2.0 data: J1 -> U5 (ESD) -> J4
Pin names follow the PCIe CEM pinout (side B = component side of the card, side A = solder side). +12V: A2 A3 B1 B2 B3. +3.3V: A9 A10 B8. 3.3Vaux: B10 via JP4 (solder jumper, closed). GND: A4 A12 A15 A18 B4 B7 B13 B16 B18. PERST# (A11): 15k to +3.3V, 10uF to GND -> 2.0V about 140ms after 3.3V. D6 e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
U4: 12V / 0.5A boost (MT3608B) + Q1/Q2 output switch + JP2 (current measurement)
SRV05-4: 1=IO1 2=GND 3=IO2 4=IO3 5=REF 6=IO4. D+ on IO1, D- on IO2 (one diode pair per line). IO3, IO4 not used. REF is left open: its TVS breaks down at 6V, VBUS1 can be 9V. J4 = motherboard USB 2.0 header pinout: 1 VBUS, 3 D-, 5 D+, 7 GND, 9 key (pull the pin). JP3 (solder jumper, closed) feeds +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
VDD = +5V (4.2 .. 5V). ADC reference = VDD, so firmware corrects with the internal Vref channel. CC1/CC2: 100k series + 100nF (the 100k keeps the load off the PD line; fault current into the pin < 0.2mA). VIN / VBUS1 sense = x 33k/(100k+33k) = 0.248: 5V -> 1.24V, 9V -> 2.23V, 20V (TVS clamp) -> 4.9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
HT7550-1: 1=GND 2=VIN(tab) 3=VOUT. 10uF in / 10uF out (datasheet application circuit). At VIN=5V the output follows VIN minus dropout (about 4.2 .. 4.9V).
VIN bus (4.2 .. 9V)
U3: 3.3V / 3A buck (TPS62933) + EN from J1 VBUS + JP1 (current measurement)
(1) USB-C J1: data + power / U1: PD sink, requests 9V
U6: 5V LDO (MCU + J4 VBUS)
U7: CH32V003F4P6 - reads CC / VIN / VBUS1, switches 3.3V and 12V
J3: PCI Express x1 slot (straddle mount on the board edge) - power pins only
(2) USB-C J2: power only (charger) / U2: PD sink, requests 9V
M3 mounting holes (not plated, no net).

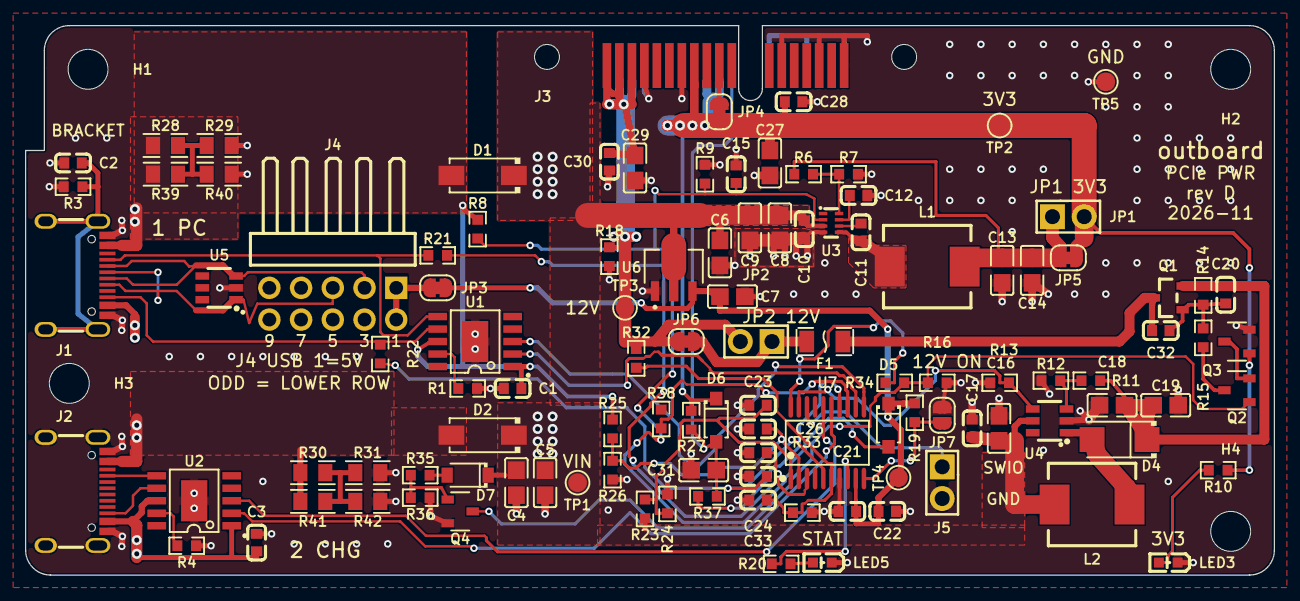
[picture p15: board pcie-tuner-board.kicad_pcb from above]

Board: 2 copper layers, 100.0 x 44.0 mm, 115 parts (0 on the bottom side), 56 nets.
