danything/outboard/scripts/make_board.py

"""基板を組み立てる (1 段目): 外形・部品の配置・電源と USB と長い制御線の手配線・GND のビア・銅の面。rev D。

出力: build/pre_route.kicad_pcb (自動配線の前の基板)
このあと scripts/export_dsn.py・scripts/route.sh (freerouting)・scripts/finish_board.py (取り込み・ベタ・シルク) を実行する。

座標は基板の左上の角を (0, 0) とした mm。x は右、y は下。基板は 100 x 44mm の 1 枚。
- 左の辺 (x = 0) がカードのブラケットの側で、USB-C が 2 つ並ぶ。USB-C の口の面は x = -0.99 = ブラケットの外の面。
- 上の長い辺 (y = 0) がカードの側。PCIe のスロット J3 が辺をまたいで付き (straddle mount)、カードは基板と同じ平面で
  y < 0 の側に来る。おもて = カードの部品面 (B) の側。J3 の B 列がおもて、A 列がうら。
- ブラケットの板が通る所 (y < 10) は、左の辺を 1.5mm 引っ込めてある。
- J4 (内部 USB、横向き) はプラグが上 (カードの辺の側) へ寝る。プラグの下は D1 のアノードの面 (銅だけ)。

置き方の筋 (どのネットも、おもてでは交差させない):
  左: USB-C 2 個と PD の IC・J4。その右に VIN の帯 (D1・D2 のカソード)。
  帯の右の上の段: 3.3V の降圧 (入力が左、出力が右) と、その上を左へ戻る 3.3V の幹。
  下の段: マイコン (帯のすぐ右) と 12V の昇圧 (右)。12V は右上の Q1 から「戻りの列」(y = 25.3) を左へ戻り、
  帯の右を上がって、VIN の幹の下だけうらでくぐり、スロットのうらのパッド (A2・A3) に入る。
  左右をまたぐ信号は、VIN の帯をうらでくぐる (本数と長さは check_board.py が記録する)。

降圧・昇圧・USB の線・マイコンの電源は rev B で確かめた形のまま、回して置き直している (board_lib.py の「枠」)。

使い方: "C:\\Program Files\\KiCad\\10.0\\bin\\python.exe" scripts/make_board.py
"""
from __future__ import annotations

import math
import os
import shutil
import sys

import pcbnew

sys.path.insert(0, os.path.dirname(os.path.abspath(__file__)))
from board_lib import B, F, ROOT, Board, rect  # noqa: E402

W, H, R = 100.0, 60.0, 2.0
STEP_X, STEP_Y = 1.5, 11.5      # ブラケットをよける段: y < STEP_Y では左の辺が x = STEP_X

# --- 機構の寸法 (build/REVD_BRIEF.md) -------------------------------------------
JX = 4.08                       # USB-C の原点の x。基板の端は原点から 4.08mm、口の面は 5.07mm
MOUTH = JX - 5.07               # USB-C の口の面 = ブラケットの外の面 (x = -0.99)
PIN1_TO_BRACKET = 47.54         # 1 番ピンの中心からブラケットの外の面まで (推定)
BRACKET_T = 0.86                # ブラケットの板の厚み
# ブラケットの板の幅 18.42 は、rev D では基板の厚みの向き (z)。基板の中心が 0、おもて (B 面の側) が +
BRACKET_A, BRACKET_B = 2.06, 16.36
BRACKET_A_MAX = 2.5
BRACKET_FULL_Y = 7.68           # 板が全幅の所の端 (推定)。ここから 45 度で細くなる
TONGUE_Y, TONGUE_Y_LP = 14.95, 10.85   # 舌の先 (標準・ロープロファイル。推定)
TONGUE_Z = (2.05, 12.24)        # 舌の幅 10.19 の z の範囲
CARD_END = 45.65                # 1 番ピンからカードの基板の端 (ブラケットの側) まで
CARD_EDGE_Y, MOUTH_Y = -13.0, -8.1     # カードの下の辺・コネクタの口 (推定)
SLOT = (MOUTH + PIN1_TO_BRACKET + 9.5, 3.2)   # J3 の原点 (1 番ピンは原点から -9.5)。パッドは y = 1.4〜5.0
KEY_X, KEY_W, KEY_D = SLOT[0] + 2.0, 1.90, 6.0   # キーの切り欠き (中心 x・幅・辺からの深さ。先は半円)
EARS = ((38.4, 45.1), (67.0, 73.7))    # コネクタの耳 (基板をはさむ樹脂) の x の範囲。y = 0〜EAR_Y に部品を置かない
EAR_Y = 9.0
SHELL_MIN_Y = 15.45             # USB-C の殻はここより下 (ブラケットの舌をよける)
Z_TOP, Z_BOTTOM = 16.36, 2.98   # 厚みの限り: おもては基板の中心から +16.36、うらは基板の面から 2.98 (コネクタの胴体の中)

# --- 配置の基準になる座標 ---------------------------------------------------
J1Y, J2Y = 20.0, 37.3           # USB-C の中心の y (上が ① PC、下が ② 充電器)。間に取り付け穴 H3
J4X, J4Y = 24.6, 22.27          # J4 の原点。180 度回して置く: プラグは上 (-y) へ、奇数の列 (下の段) が上
J4_BODY = (J4X - 6.6, J4Y - 5.63, J4X + 6.6, J4Y - 3.09)        # 樹脂
J4_PLUG = (J4X - 6.6, J4Y - 19.63, J4X + 6.6, J4Y - 5.63)       # プラグ (長さ 約 14、幅 約 13.2。推定)
U1X, U1Y = 36.0, 25.3
D1Y, D2Y = 12.0, 32.8
BAND_W, BAND_E = 37.8, 46.0     # VIN の帯 (D1・D2 のカソードが乗る) の左と右
CHAN = 42.0                     # U1 の右では帯の左の辺をここまで下げ、うらへ降りるビアの通り道にする
YT = 8.0                        # +3V3 の幹の y (スロットのパッドのすぐ下を左へ戻る)
U3X, U3Y = 78.0, 17.0           # 降圧 IC (入力が右、出力が左 = スロットの 3.3V のパッドの側)
U4X, U4Y = 76.0, 41.0           # 昇圧 IC (入力が左下、出力が右上)
U7X, U7Y = 60.0, 36.0           # マイコン
Q1X, Q1Y = 85.5, 31.15          # 12V の出力スイッチ (列の下、昇圧の右上)
ROW = 25.3                      # 12V の戻りの列 (Q1 -> F1 -> JP2/JP6 -> 左へ)。降圧のすぐ下
X12 = 48.0                      # 12V が上がる x (帯のすぐ右)
LAND_X = 47.0                   # 帯をうらでくぐった線がおもてへ上がるビアの列 (12V の上がりの線のすぐ下)
RISER = (95.2, 98.8)            # VIN が右の辺を上がる帯の x
STRIP = (52.0, 55.4)            # VIN を昇圧と右の辺へ運ぶ下の帯の y
STRIP_E = 91.4                  # 下の帯の右の端 (取り付け穴 H4 をよける)
TRUNK_X = 55.7                  # +3V3 の幹の縦の部分の x (幅 2.0)
PVX, PVY = 52.3, 17.5           # PERST# がうらから上がるビア (遅延の部品の真ん中)
EN_LAND = (49.4, 23.0)           # EN_3V3 が帯をくぐって上がるビア (列の北)
BUCK = dict(k=0, old=(47.0, 9.0), new=(U3X, U3Y))        # rev B の降圧のまわりをそのままの向きで
BOOST = dict(k=2, old=(33.5, 40.65), new=(U4X, U4Y))     # rev B の昇圧のまわりを 180 度回す
USB1 = dict(k=2, old=(85.92, 13.5), new=(JX, J1Y))       # rev B の USB-C ① のまわりを 180 度回す
USB2 = dict(k=2, old=(85.92, 32.9), new=(JX, J2Y))
MCU = dict(k=0, old=(46.5, 29.0), new=(U7X, U7Y))


def outline(bd: Board):
    E = pcbnew.Edge_Cuts
    kx1, kx2, kr = KEY_X - KEY_W / 2, KEY_X + KEY_W / 2, KEY_W / 2
    bd.line(E, STEP_X + R, 0, kx1, 0, 0.1)
    bd.line(E, kx1, 0, kx1, KEY_D - kr, 0.1)                 # キーの切り欠き
    bd.arc(E, KEY_X, KEY_D - kr, kr, 180, 0, 0.1)
    bd.line(E, kx2, KEY_D - kr, kx2, 0, 0.1)
    bd.line(E, kx2, 0, W - R, 0, 0.1)
    bd.arc(E, W - R, R, R, 270, 360, 0.1)
    bd.line(E, W, R, W, H - R, 0.1)
    bd.arc(E, W - R, H - R, R, 0, 90, 0.1)
    bd.line(E, W - R, H, R, H, 0.1)
    bd.arc(E, R, H - R, R, 90, 180, 0.1)
    bd.line(E, 0, H - R, 0, STEP_Y, 0.1)
    bd.line(E, 0, STEP_Y, STEP_X, STEP_Y, 0.1)               # 段
    bd.line(E, STEP_X, STEP_Y, STEP_X, R, 0.1)
    bd.arc(E, STEP_X + R, R, R, 180, 270, 0.1)


# 取り付け穴 (M3、穴 3.2mm)。H3 は後ろの遠い角が USB-C でふさがるので、2 つの USB-C の間
HOLES = (("H1", STEP_X + 3.5, 3.5), ("H2", W - 3.5, 3.5), ("H3", 3.5, (J1Y + J2Y) / 2), ("H4", W - 3.5, H - 3.5))
LEDS = (("LED3", 88.6), ("LED5", 65.4))     # 下の長い辺 (カードと反対の辺) の LED の x
LED_Y = H - 1.0


def plen(pts):
    return sum(math.hypot(b[0] - a[0], b[1] - a[1]) for a, b in zip(pts, pts[1:]))


def build() -> Board:
    bd = Board()
    outline(bd)
    for ref, x, y in HOLES:
        bd.place(ref, x, y)

    # ---- 端子 ---------------------------------------------------------------
    bd.place("J3", SLOT[0], SLOT[1], 0)       # 口は上 (基板の外)。1 番ピンが左。B 列がおもて、A 列がうら
    bd.place("J1", JX, J1Y, 270)              # 口が左を向く
    bd.place("J2", JX, J2Y, 270)
    bd.place("J4", J4X, J4Y, 180)             # プラグは上へ寝る。1 番ピンが右、奇数の列 (下の段) が上

    # ---- ① USB-C のまわり -----------------------------------------------------
    with bd.frame(**USB1):
        bd.place("U5", 74.5, 12.5, 180)       # 1 (IO1)・3 (IO2) が J4 の側
        bd.place("R3", 86.2, 20.6, pin1="W")
        bd.place("C2", 86.2, 22.5, pin1="W")
    bd.place("U1", U1X, U1Y, 90)              # 6・7 (CC) が左、1 (VHV) が右下
    bd.place("R1", U1X - 0.6, U1Y + 3.76, pin1="W")
    bd.place("C1", U1X + 3.0, U1Y + 3.76, pin1="E")
    bd.place("R22", 28.4, 26.3, pin1="N")     # CC2 の線の上にパッド 1
    bd.place("R21", 33.0, 18.4, pin1="W")     # CC1 の線の先 (J4 の樹脂の右)
    bd.place("JP3", 33.0, 21.0, pin1="E")     # 左が USBH_VBUS (J4 の 1 番)、右が +5V
    bd.place("R8", 36.2, 16.3, pin1="N")      # U3 の EN の分圧の上の抵抗 (D1 のアノードの面のすぐ下)
    # ブリーダ (1kΩ 0805 を 2 直列 x 2 並列)。アノードの面の左の端。J4 のプラグの下には入らない
    bd.place("R28", 11.2, 9.6, pin1="W")
    bd.place("R29", 15.5, 9.6, pin1="W")
    bd.place("R39", 11.2, 11.9, pin1="W")
    bd.place("R40", 15.5, 11.9, pin1="W")
    bd.place("D1", 36.6, D1Y, pin1="W")       # アノードが左 (VBUS1 の面)、カソード (帯) が右 (VIN の帯)

    # ---- ② USB-C のまわり (rev C の形のまま) ----------------------------------
    bd.place("U2", 13.5, J2Y + 0.75, 90)
    bd.place("R4", 12.9, J2Y + 4.35, pin1="W")
    bd.place("C3", 18.5, J2Y + 4.1, pin1="S")
    bd.place("R30", 23.0, J2Y - 1.5, pin1="W")
    bd.place("R31", 27.4, J2Y - 1.5, pin1="W")
    bd.place("R41", 23.0, J2Y + 0.8, pin1="W")
    bd.place("R42", 27.4, J2Y + 0.8, pin1="W")
    bd.place("D2", 36.6, D2Y, pin1="W")
    # 過電圧の遮断 (VIN が約 13V を超えたら Q2 のゲートを GND に引く)。帯の左、D2 の下
    bd.place("D7", 35.4, 36.0, pin1="E")      # カソード (パッド 1、帯) が右 = VIN の帯の側
    bd.place("R35", 31.6, 36.0, pin1="E")
    bd.place("R36", 31.6, 37.8, pin1="W")
    bd.place("Q4", 34.8, 38.9, 180)           # 左上が 1 B、左下が 2 E、右が 3 C

    # ---- VIN の帯の中 ----------------------------------------------------------
    bd.place("C4", 39.3, 36.6, pin1="N")
    bd.place("C5", 41.6, 36.6, pin1="N")
    bd.place("TP1", 44.2, 36.6)

    # ---- 3.3V の降圧 (rev B の形を 180 度回したもの) ---------------------------
    with bd.frame(**BUCK):
        bd.place("U3", 47.0, 9.0, 0)
        bd.place("C10", 49.15, 8.5, pin1="S")
        bd.place("C8", 51.1, 8.6, pin1="S")
        bd.place("C9", 53.5, 8.6, pin1="S")
        bd.place("C11", 44.6, 8.25, pin1="S")
        bd.place("L1", 39.3, 5.5, pin1="E")
        bd.place("C12", 44.8, 11.2, pin1="E")
        bd.place("R7", 45.6, 12.9, pin1="E")
        bd.place("R6", 49.2, 12.9, pin1="E")
        bd.place("C13", 33.3, 5.2, pin1="S")
        bd.place("C14", 30.9, 5.2, pin1="S")
    c14 = bd.G("C14", "1")
    bd.place("JP5", c14[0] - 4.0, c14[1], pin1="E")      # 閉じたはんだジャンパー (3.3V の 3A が通る)。右が降圧、左がスロット
    bd.place("JP1", c14[0] - 3.4, c14[1] + 3.45, pin1="E")   # JP5 に並列のヘッダ (電流を測るとき用。載せない)
    bd.place("R9", 84.0, 20.6, pin1="W")      # EN の分圧の下 (降圧の右下)
    bd.place("C15", 84.0, 22.4, pin1="W")     # EN のコンデンサ
    bd.place("C27", 53.6, 11.0, pin1="N")     # 3.3V の出口のコンデンサ (幹のすぐ下)
    bd.place("C28", 51.2, 10.75, pin1="N")
    bd.place("TP2", TRUNK_X, 11.6)            # 幹の上
    bd.place("JP4", SLOT[0] - 0.5, 6.9, pin1="S")        # B10 (+3V3AUX) のすぐ下。下のパッドは幹の上

    # ---- 5V の LDO (VIN の幹のすぐ下) ------------------------------------------
    bd.place("U6", 55.0, 49.0, 90)            # 下が 2 VIN (タブ。下の帯のすぐ上)
    bd.place("C6", 58.0, 50.3, pin1="S")
    bd.place("C7", 52.2, 47.6, pin1="E")

    # ---- 12V: スロットのそば・戻りの列 ------------------------------------------
    bd.place("C29", 48.8, 11.4, pin1="N")
    bd.place("C30", 46.75, 10.9, pin1="N")
    bd.place("TP3", X12, 22.6)
    bd.place("R18", 46.75, 18.5, pin1="N")
    bd.place("R32", 50.6, 26.65, pin1="N")     # +12V を読む分圧の上の抵抗
    bd.place("JP6", 52.9, ROW, pin1="E")      # 右が +12V_F、左が +12V
    bd.place("JP2", 58.5, ROW, pin1="E")      # JP6 に並列のヘッダ (載せない)
    bd.place("F1", 64.0, ROW, pin1="E")

    # ---- 12V の昇圧 (rev B の形を 180 度回したもの) と出力スイッチ -------------
    with bd.frame(**BOOST):
        bd.place("U4", 33.5, 40.65, 180)
        bd.place("L2", 30.1, 33.95, pin1="E")
        bd.place("D4", 27.9, 39.15, pin1="W")
        bd.place("C16", 37.55, 40.05, pin1="N")
        bd.place("C17", 39.7, 40.05, pin1="N")
        bd.place("C18", 28.5, 41.9, pin1="W")
        bd.place("C19", 24.2, 41.9, pin1="E")
        bd.place("R12", 33.4, 43.87, pin1="W")
        bd.place("R11", 30.2, 43.87, pin1="W")
    bd.place("R13", U4X - 4.0, U4Y - 3.05, pin1="E")
    bd.place("Q1", Q1X, Q1Y, 0)             # 左が 3 D、右上が 2 S、右下が 1 G
    bd.place("R14", Q1X + 2.8, Q1Y - 0.2, pin1="S")
    bd.place("C20", Q1X + 4.6, Q1Y - 0.25, pin1="S")
    bd.place("C32", Q1X - 0.6, Q1Y + 2.62, pin1="E")
    bd.place("R15", Q1X + 2.8, Q1Y + 3.2, pin1="N")
    bd.place("Q3", Q1X + 5.5, Q1Y + 3.5, 0)             # 左が 3 D、右上が 2 S、右下が 1 G
    bd.place("Q2", Q1X + 5.5, Q1Y + 7.4, 0)

    # ---- マイコン -----------------------------------------------------------
    with bd.frame(**MCU):
        bd.place("U7", 46.5, 29.0, 0)         # 下の列が左から 1..10、上の列が左から 20..11
        bd.place("C21", 48.1, 34.5, pin1="E")
        bd.place("C22", 51.3, 34.5, pin1="W")
    # ADC の入力のコンデンサはマイコンの左に縦に並べる (右が信号、左が GND)
    for i, ref in enumerate(("C25", "C26", "C23", "C24", "C33")):
        bd.place(ref, U7X - 5.55, U7Y - 3.0 + 1.9 * i, pin1="E")
    bd.place("R25", 49.8, 29.8, pin1="W")     # VBUS1 を読む分圧 (帯をくぐって上がったビアのすぐ右)
    bd.place("R26", 52.6, 29.8, pin1="W")
    bd.place("R23", 48.0, 50.4, pin1="S")     # VIN を読む分圧 (上の抵抗は下の帯から)
    bd.place("R24", 49.8, 50.0, pin1="S")
    # PERST# の遅延。スロットのすぐ下 (+3V3 の幹の左) に置く。PERST# はうらのパッド A11 から来る
    bd.place("R27", PVX - 1.0, PVY - 2.3, pin1="N")
    bd.place("D6", PVX + 1.0, PVY - 2.3, pin1="N")       # カソード (パッド 1、帯) が上 = +3V3
    bd.place("C31", PVX, PVY + 1.7, pin1="E")
    bd.place("R37", PVX + 0.3, PVY + 3.8, pin1="W")
    bd.place("R38", U7X + 4.6, U7Y - 7.6, pin1="W")
    bd.place("R34", U7X + 5.4, U7Y - 4.8, pin1="W")
    bd.place("R16", U7X + 8.8, U7Y - 4.8, pin1="W")
    bd.place("D5", U7X + 11.0, U7Y - 6.9, pin1="S")     # アノード (EN_3V3) が上、カソード (パッド 1、帯) が下 = +5V
    bd.place("R19", U7X + 7.0, U7Y - 2.4, pin1="N")
    bd.place("JP7", U7X + 9.2, U7Y - 2.2, pin1="S")     # 12V の強制オン (はんだでつなぐ)
    bd.place("TP4", U7X + 5.7, U7Y + 2.8)
    bd.place("J5", U7X + 9.2, U7Y + 3.2, pin1="N")
    bd.place("R33", U7X - 2.0, U7Y + 5.6, pin1="W")
    bd.place("TP5", 86.5, 4.5)
    # LED (下の長い辺。辺から 1mm 以内)。直列の抵抗はすぐ左
    bd.place("R10", Q1X + 4.5, Q1Y + 14.05, pin1="E")    # LED3 (3.3V) の直列抵抗。+3V3 は Q3 のゲートの線から
    bd.place("R20", LEDS[1][1] - 3.3, LED_Y + 0.1, pin1="W")
    for ref, x in LEDS:
        bd.place(ref, x, LED_Y, pin1="W")
    return bd


def route(bd: Board):
    """電源・USB・CC・帯をくぐる線を手で引く。残りの細い信号は freerouting に任せる。"""
    P = bd.P
    T = bd.track

    # ======== USB のデータ線 (J1 -> U5 は rev B の形のまま。その先は J4 の上の列へ) ======
    with bd.frame(**USB1):
        dp6, dn7, dp_a6, dn_b7 = P("J1", "B6"), P("J1", "A7"), P("J1", "A6"), P("J1", "B7")
        io1, io2 = P("U5", "1"), P("U5", "3")
        w0, w1 = 0.2, 0.5
        yp, yn = io1[1] - 0.85, io2[1] + 0.85            # U5 の使わないパッド (IO4・IO3) の外を回る
        dp_a = [dp6, (82.5, dp6[1]), (82.0, dp6[1] - 0.5), (77.9, dp6[1] - 0.5), (76.35, yp)]
        dp_b = [(76.35, yp), (74.2, yp), (io1[0] + 0.2, io1[1]), io1]
        dn_a = [dn7, (81.9, dn7[1]), (81.4, dn7[1] - 0.5), (77.9, dn7[1] - 0.5), (76.35, yn)]
        dn_b = [(76.35, yn), (74.2, yn), (io2[0] + 0.2, io2[1]), io2]
        T("USB_DP", w0, dp_a)
        T("USB_DP", w1, dp_b)
        T("USB_DN", w0, dn_a)
        T("USB_DN", w1, dn_b)
        len_p, len_n = plen(dp_a) + plen(dp_b), plen(dn_a) + plen(dn_b)
        # 裏返しに挿したとき用の D+ (A6): ビアで裏へ回り、D- の下をくぐって D+ に合流
        va, vb = (79.4, dp_a6[1]), (79.4, 11.5)
        T("USB_DP", w0, [dp_a6, va])
        bd.via("USB_DP", *va)
        T("USB_DP", w0, [va, vb], layer=B)
        bd.via("USB_DP", *vb)
        T("USB_DP", w0, [vb, (79.4, dp6[1] - 0.5)])
        T("USB_DN", w0, [dn_b7, (81.9, dn_b7[1]), (81.5, dn_b7[1] + 0.4), (77.3, dn_b7[1] + 0.4), (76.9, yn - 0.1),
                         (76.35, yn)])
        bd.gnd_via(74.45, 12.5, frm=P("U5", "2"), width=0.4)
    # U5 から J4 へ: D- は上の列のすぐ上を、D+ は 2 列の間を通り、3 番・5 番のピンへ。長さは D+ の寄り道でそろえる
    io1, io2 = bd.G("U5", "1"), bd.G("U5", "3")          # D+ (下)、D- (上)
    j5, j3 = bd.G("J4", "5"), bd.G("J4", "3")
    # rev D: 2 本を並べて (間 0.2mm) 奇数の列のすぐ上を通し、D+ は 5 番へ、D- はその先の 3 番へ上から降りる。
    # 並んでいないのは最後の 2.54mm (ピンの間隔) だけ。長さは、足りない側の出だしの寄り道でそろえる
    yl_p, yl_n = j5[1] - 1.2, j5[1] - 1.6
    xr_ = io1[0] + 1.0                                   # D+ が上の段へ上がる x (U5 のパッドと J4 の 9 番の間)

    def dn_tail(d):
        return [io2, (io2[0] + 0.65, io2[1]), (io2[0] + 0.65 + d, io2[1] - d), (io2[0] + 0.65 + 2 * d, io2[1]),
                (io2[0] + 1.25 + 2 * d, yl_n), (j3[0] - 0.25, yl_n), (j3[0], yl_n + 0.25), j3]

    def dp_tail(d):
        return [io1, (xr_ - 0.3, io1[1]), (xr_ - 0.3 + d, io1[1] + d), (xr_ + d, io1[1] + d), (xr_ + d, io1[1] - 0.3),
                (xr_, io1[1] - 0.3 - d), (xr_, yl_p + 0.8), (xr_ + 0.8, yl_p), (j5[0] - 0.25, yl_p), (j5[0], yl_p + 0.25), j5]
    short_p = len_p + plen(dp_tail(0)) < len_n + plen(dn_tail(0))
    lo, hi = 0.0, 0.6
    for _ in range(40):                                  # 寄り道の深さを二分法で決める
        mid = (lo + hi) / 2
        dp_, dn_ = (dp_tail(mid), dn_tail(0)) if short_p else (dp_tail(0), dn_tail(mid))
        if (len_p + plen(dp_) < len_n + plen(dn_)) == short_p:
            lo = mid
        else:
            hi = mid
    T("USB_DP", w0, dp_tail(lo if short_p else 0))
    T("USB_DN", w0, dn_tail(0 if short_p else lo))
    print("USB tail: D+ %.2f D- %.2f detour %.2f on %s" % (len_p + plen(dp_tail(lo if short_p else 0)),
                                                         len_n + plen(dn_tail(0 if short_p else lo)), lo, "D+" if short_p else "D-"))
    # J4 の電源と GND。7・8 番 (GND) はスルーホールなので、うらのベタにそのままつながる
    j41, j42 = bd.G("J4", "1"), bd.G("J4", "2")
    T("USBH_VBUS", 0.5, [j41, j42])
    T("USBH_VBUS", 0.5, [j41, P("JP3", "2")])
    # USB-C の GND のパッド: 1 つにつきビア 2 個 (殻の外)
    for j, fr in (("J1", USB1), ("J2", USB2)):
        with bd.frame(**fr):
            for num, s in (("B1A12", -1), ("A1B12", 1)):
                g = P(j, num)
                T("GND", 0.5, [(g[0] - 0.4, g[1]), (82.25, g[1] + 0.4 * s), (82.3, g[1] + 1.2 * s)])
                bd.via("GND", 82.25, g[1] + 0.4 * s)
                bd.via("GND", 82.3, g[1] + 1.2 * s)

    # ======== ① の CC (殻の下を通さない)。CC1 は J4 の上を回って 3 番と 1 番の列の間を降り、CC2 は J4 の下を通って U1 へ ====
    cc1, cc2 = P("J1", "A5"), P("J1", "B5")          # 上が CC1、下が CC2
    u1 = {n: P("U1", n) for n in ("1", "2", "3", "6", "7", "8", "9", "11")}
    y1 = J1Y - 1.6
    xd = (j3[0] + j41[0]) / 2                        # 3/4 番の列と 1/2 番の列の間
    ya, yb = j42[1] + 1.26, j42[1] + 1.76            # J4 の下の列のすぐ下を通る 2 本 (CC1・CC2)
    T("J1_CC1", 0.2, [cc1, (7.6, cc1[1]), (7.95, y1), (xd - 0.25, y1), (xd, y1 + 0.25), (xd, ya - 0.25),
                      (xd + 0.25, ya), (30.6, ya), (30.6 + ya - u1["6"][1] - 0.2, u1["6"][1] + 0.2),
                      (32.1, u1["6"][1]), u1["6"]])
    T("J1_CC1", 0.2, [(xd - 0.25, y1), P("R21", "1")])
    T("J1_CC2", 0.2, [cc2, (9.2, cc2[1]), (9.7, cc2[1] + 0.5), (9.7, yb - 0.5), (10.2, yb), (31.2, yb),
                      (31.2 + yb - u1["7"][1], u1["7"][1]), u1["7"]])
    # CC1・CC2 を読む線と I2C1・+5V・EN は、U1 の右のビアからうらへ降りて VIN の帯をくぐる
    xv1, xv2 = CHAN - 1.6, CHAN - 0.7
    r21b, r22b, r8b = P("R21", "2"), P("R22", "2"), P("R8", "2")
    ycs = r21b[1] + 0.5
    T("CC1_SENSE", 0.2, [r21b, (xv2 - 0.5, r21b[1]), (xv2, ycs)])
    bd.via("CC1_SENSE", xv2, ycs)
    # うらでは、北の線ほど東の縦の列を通り、LAND_X の縦のビアの列 (12V の上がりの線の終わりのすぐ下) でおもてへ戻る。
    # EN だけは列の北 (降圧の側) へ上がる
    LY = dict(CC1=26.4, P5=27.25, SDA=28.1, SCL=28.95, VB=29.8, CC2=30.65)
    T("CC1_SENSE", 0.25, [(xv2, ycs), (xv2 + 0.6, ycs), (xv2 + 0.9, ycs + 0.3), (46.2, ycs + 0.3 + 46.2 - xv2 - 0.9),
                          (46.2, LY["CC1"] - 0.3), (46.5, LY["CC1"]), (LAND_X, LY["CC1"])], layer=B)
    bd.via("CC1_SENSE", LAND_X, LY["CC1"])
    T("EN_3V3", 0.2, [r8b, (r8b[0] + 0.55, r8b[1] + 0.55), (xv1, r8b[1] + 0.55)])
    yen = r8b[1] + 0.55
    bd.via("EN_3V3", xv1, yen)
    T("EN_3V3", 0.25, [(xv1, yen), (xv1 + 0.6, yen), (xv1 + 0.9, yen + 0.3), (EN_LAND[0] - (EN_LAND[1] - yen - 0.3), yen + 0.3),
                       EN_LAND], layer=B)
    bd.via("EN_3V3", *EN_LAND)
    jp3 = P("JP3", "1")
    T("+5V", 0.4, [jp3, (xv1, jp3[1])])
    bd.via("+5V", xv1, jp3[1])
    T("+5V", 0.4, [(xv1, jp3[1]), (xv1 + 0.6, jp3[1]), (45.5, jp3[1] + 45.5 - xv1 - 0.6), (45.5, LY["P5"] - 0.3),
                   (45.8, LY["P5"]), (LAND_X, LY["P5"])], layer=B)
    bd.via("+5V", LAND_X, LY["P5"])
    # U1 の右の列: I2C1 と VHV (VBUS1)。ビアから斜めに降りる
    for net, pin, ye in (("I2C1_SDA", "3", LY["SDA"]), ("I2C1_SCL", "2", LY["SCL"]), ("VBUS1", "1", LY["VB"])):
        p = u1[pin]
        T(net, 0.25 if net != "VBUS1" else 0.4, [p, (xv1, p[1])])
        bd.via(net, xv1, p[1])
        T(net, 0.25 if net != "VBUS1" else 0.3, [(xv1, p[1]), (xv1 + 0.6, p[1]), (xv1 + 0.6 + ye - p[1], ye), (LAND_X, ye)], layer=B)
        bd.via(net, LAND_X, ye)
    vc = (r22b[0] + 1.2, r22b[1] + 0.15)
    T("CC2_SENSE", 0.2, [r22b, vc])
    bd.via("CC2_SENSE", *vc)
    yc = u1["1"][1] + 1.0
    T("CC2_SENSE", 0.25, [vc, (vc[0] + yc - vc[1], yc), (xv1 + 0.6, yc), (xv1 + 0.6 + LY["CC2"] - yc, LY["CC2"]), (LAND_X, LY["CC2"])],
      layer=B)
    bd.via("CC2_SENSE", LAND_X, LY["CC2"])
    T("VBUS1", 0.3, [(LAND_X, LY["VB"]), P("R25", "1")])
    T("VBUS1_SENSE", 0.25, [P("R25", "2"), P("R26", "1")])
    g = P("R26", "2")
    bd.gnd_via(g[0] + 1.15, g[1], frm=g)
    # U1 のまわり
    T("CFG1_U1", 0.2, [u1["9"], (u1["9"][0] + 1.1, u1["9"][1]), (u1["9"][0] + 1.35, u1["9"][1] + 0.25),
                       (u1["9"][0] + 1.35, P("R1", "1")[1] - 0.5), P("R1", "1")])
    gv = ((P("R1", "2")[0] + P("C1", "2")[0]) / 2, P("R1", "2")[1])
    T("GND", 0.4, [P("R1", "2"), gv, P("C1", "2")])
    bd.via("GND", *gv)
    for dy in (-0.6, 0.6):
        bd.via("GND", u1["11"][0], u1["11"][1] + dy)
    T("VBUS1", 0.4, [u1["1"], (P("C1", "1")[0], u1["1"][1]), P("C1", "1")])
    # U1 の VBUS (8 番) と VHV (1 番) は、うらの細い線でアノードの面から
    xb1 = U1X - 1.0
    v8 = (u1["8"][0] - 1.6, u1["8"][1] + 0.65)
    va1 = (xb1, D1Y + 2.4)
    T("VBUS1", 0.4, [(xv1, u1["1"][1]), (xb1, u1["1"][1]), va1], layer=B)
    bd.via("VBUS1", *va1)
    T("VBUS1", 0.4, [(xb1, u1["1"][1]), (v8[0] + 0.8, u1["1"][1]), (v8[0], u1["1"][1] - 0.8), v8], layer=B)
    bd.via("VBUS1", *v8)
    T("VBUS1", 0.3, [v8, (u1["8"][0] - 0.7, u1["8"][1] + 0.1), u1["8"]])

    # ======== VBUS1: 上のパッド -> おもての面 -> D1。下のパッド -> うらの橋 -> おもての面 ========
    va_, vb_ = P("J1", "A4B9"), P("J1", "B4A9")      # 上、下
    T("VBUS1", 0.6, [va_, (7.7, va_[1])])                      # パッドの列を出たらすぐ 0.9mm に広げる
    T("VBUS1", 0.9, [(7.7, va_[1]), (8.9, va_[1]), (8.9, J1Y - 5.4)])
    # 面は四角に分けて描く (自動配線に渡す通行止めが、へこんだ形だと外接の形で効いてしまうため)
    for i, r_ in enumerate((rect(8.7, 0.5, 35.3, 15.0), rect(8.4, 7.3, 17.0, J1Y - 2.9))):
        bd.zone("VBUS1", F, r_, clearance=0.2, thermal=False, name="D1-anode-%d" % (i + 1), priority=2 + i)
    T("VBUS1", 0.5, [vb_, (8.05, vb_[1]), (8.75, vb_[1] + 0.7), (8.75, J1Y + 5.0)])
    T("VBUS1", 0.8, [(8.75, vb_[1] + 0.95), (8.75, J1Y + 5.0)])
    for y in (J1Y - 5.3, J1Y - 4.3, J1Y + 4.0, J1Y + 5.0):
        bd.via("VBUS1", 8.75, y, dia=0.8, drill=0.4)
    bd.zone("VBUS1", B, rect(8.15, J1Y - 5.9, 9.45, J1Y + 5.7), clearance=0.3, thermal=False, name="VBUS1-bridge")
    # ブリーダ: R28 - R29 と R39 - R40 (中点はつなぐ)。VBUS1 の側のパッドは面の中
    T("BLD1", 0.4, [P("R28", "2"), P("R29", "1")])
    T("BLD1", 0.4, [P("R39", "2"), P("R40", "1")])
    xm = (P("R28", "2")[0] + P("R29", "1")[0]) / 2
    T("BLD1", 0.4, [(xm, P("R28", "2")[1]), (xm, P("R39", "2")[1])])
    for ref in ("R29", "R40"):
        g = P(ref, "2")
        bd.gnd_via(g[0] + 1.25, g[1], frm=g)
    p = P("R8", "1")
    T("VBUS1", 0.4, [p, (p[0] - 1.2, p[1] - 0.9)])
    # 殻 (SHIELD1): 前と後ろの足をおもてで、上と下の足をうらでつなぐ。R3・C2 へ
    s1, s2, s3, s4 = (bd.G("J1", n) for n in "1234")
    T("SHIELD1", 0.4, [s1, s2])
    T("SHIELD1", 0.4, [s4, s3])
    T("SHIELD1", 0.4, [s4, (4.2, s4[1] + 1.25), (4.2, s1[1] - 1.25), s1], layer=B)
    r3, c2 = P("R3", "1"), P("C2", "1")
    T("SHIELD1", 0.4, [s4, (s4[0], r3[1])])
    T("SHIELD1", 0.4, [(s4[0], r3[1]), r3])
    T("SHIELD1", 0.4, [(s4[0], r3[1]), (s4[0], c2[1] + 0.8), (c2[0] + 0.5, c2[1]), c2])
    for ref in ("R3", "C2"):
        g = P(ref, "2")
        bd.gnd_via(g[0] - 1.15, g[1], frm=g)

    # ======== ② : CC はまっすぐ U2 へ。VBUS は上のパッド -> おもての面、下のパッド -> うらの橋 ====
    c21_, c22_ = P("J2", "A5"), P("J2", "B5")
    u2 = {n: P("U2", n) for n in ("1", "2", "3", "6", "7", "8", "9", "11")}
    T("J2_CC1", 0.2, [c21_, u2["6"]])
    T("J2_CC2", 0.2, [c22_, (8.0, c22_[1]), (8.6, c22_[1] - 0.6), (8.6, u2["7"][1] + 0.6), (9.2, u2["7"][1]),
                      u2["7"]])
    wa, wb = P("J2", "A4B9"), P("J2", "B4A9")
    T("VBUS2", 0.6, [wa, (7.7, wa[1])])
    T("VBUS2", 0.9, [(7.7, wa[1]), (8.9, wa[1]), (8.9, J2Y - 5.8)])
    for i, r_ in enumerate((rect(8.4, 27.7, 29.5, J2Y - 2.9), rect(29.3, 30.6, 35.3, J2Y - 2.9))):
        bd.zone("VBUS2", F, r_, clearance=0.2, thermal=False, name="D2-anode-%d" % (i + 1), priority=2 + i)
    T("VBUS2", 0.5, [wb, (8.6, wb[1]), (9.3, wb[1] - 0.7), (9.3, u2["8"][1] + 0.45), (9.75, u2["8"][1]), u2["8"]])
    yv2 = J2Y + 5.3
    T("VBUS2", 0.9, [(8.6, wb[1]), (8.9, wb[1] + 0.3), (8.9, yv2)])
    c3 = P("C3", "1")
    T("VBUS2", 0.4, [(8.9, yv2), (c3[0], yv2), c3])
    T("VBUS2", 0.4, [u2["1"], (u2["1"][0], yv2)])
    for y in (J2Y - 5.3, J2Y - 4.3, J2Y + 3.9, J2Y + 5.0):
        bd.via("VBUS2", 8.9, y, dia=0.8, drill=0.4)
    bd.zone("VBUS2", B, rect(8.3, J2Y - 5.9, 9.6, J2Y + 5.7), clearance=0.3, thermal=False, name="VBUS2-bridge")
    r4 = P("R4", "1")
    T("CFG1_U2", 0.2, [u2["9"], (u2["9"][0] + 1.1, u2["9"][1]), (u2["9"][0] + 1.35, u2["9"][1] + 0.25),
                       (u2["9"][0] + 1.35, r4[1] - 0.5), r4])
    bd.gnd_via(P("R4", "2")[0] + 1.2, r4[1], frm=P("R4", "2"))
    bd.gnd_via(P("C3", "2")[0] + 1.2, P("C3", "2")[1], frm=P("C3", "2"))
    for dy in (-0.6, 0.6):
        bd.via("GND", u2["11"][0], u2["11"][1] + dy)
    T("BLD2", 0.4, [P("R30", "2"), P("R31", "1")])
    T("BLD2", 0.4, [P("R41", "2"), P("R42", "1")])
    xm = (P("R30", "2")[0] + P("R31", "1")[0]) / 2
    T("BLD2", 0.4, [(xm, P("R30", "2")[1]), (xm, P("R41", "2")[1])])
    p30, p41 = P("R30", "1"), P("R41", "1")
    T("VBUS2", 0.5, [(p30[0], J2Y - 3.3), p30, p41])
    for ref in ("R31", "R42"):
        g = P(ref, "2")
        bd.gnd_via(g[0] + 1.25, g[1], frm=g)
    # I2C2: U2 から右へ出て、Q4 の下を通り、VIN の帯をうらでくぐる
    for net, pin, x0, yt, xk, xv, yb_, xs in (("I2C2_SDA", "3", 17.9, J2Y + 1.95, 30.45, 36.9, 41.0, 47.2),
                                              ("I2C2_SCL", "2", 17.5, J2Y + 2.4, 30.0, 35.9, 41.85, 48.4)):
        p = u2[pin]
        T(net, 0.2, [p, (x0, p[1]), (x0 + yt - p[1], yt), (xk, yt), (xk + yb_ - 0.15 - yt, yb_ - 0.15), (xv - 0.15, yb_ - 0.15),
                     (xv, yb_)])
        bd.via(net, xv, yb_)
        T(net, 0.25, [(xv, yb_), (xs - (yb_ - 39.0), yb_), (xs, 39.0)], layer=B)
        bd.via(net, xs, 39.0)
    # 過電圧の遮断
    d7k, d7a = P("D7", "1"), P("D7", "2")
    T("VIN", 0.4, [d7k, (BAND_W + 0.6, d7k[1])])
    r35a, r35b, r36a, r36g = P("R35", "1"), P("R35", "2"), P("R36", "1"), P("R36", "2")
    T("OVP_Z", 0.25, [d7a, r35a])
    qb, qe, qc = P("Q4", "1"), P("Q4", "2"), P("Q4", "3")
    T("OVP_B", 0.25, [r35b, r36a])
    T("OVP_B", 0.25, [(r35b[0], r35b[1] + 1.0), (qb[0] - 0.5, r35b[1] + 1.0), qb])
    gv = (r36g[0] + 0.15, r36g[1] + 1.5)             # R36 と Q4 のエミッタの GND は 1 つのビアで
    bd.gnd_via(*gv, frm=r36g)
    T("GND", 0.4, [qe, gv])
    vq = (qc[0] + 1.3, qc[1])                        # Q4 のコレクタ -> Q2_G: 帯をうらでくぐってマイコンの側へ
    T("Q2_G", 0.2, [qc, vq])
    bd.via("Q2_G", *vq)
    T("Q2_G", 0.25, [vq, (vq[0] + 1.0, vq[1] + 1.0), (44.0, vq[1] + 1.0), (44.0 + vq[1] + 1.0 - 38.0, 38.0), (48.4, 38.0)], layer=B)
    bd.via("Q2_G", 48.4, 38.0)

    # ======== VIN の帯と、D1・D2 のカソード ====================================
    for i, r_ in enumerate((rect(BAND_W, 0.5, BAND_E - 0.6, 15.6), rect(BAND_E - 0.8, 6.2, BAND_E, 15.6),
                            rect(CHAN, 15.4, BAND_E, 30.4), rect(BAND_W, 30.2, BAND_E, STRIP[1]),
                            rect(BAND_E - 0.2, STRIP[0], STRIP_E, STRIP[1]), rect(U4X - 5.4, U4Y + 2.55, U4X - 2.0, STRIP[0] + 0.2),
                            # 右の辺を上がって降圧の入口へ (取り付け穴 H4 をよけて、角を内側に取る)
                            rect(STRIP_E - 3.4, 49.0, STRIP_E, STRIP[1]), rect(STRIP_E - 3.4, 49.0, RISER[1], 52.6),
                            rect(RISER[0], 16.6, RISER[1], 52.6))):
        bd.zone("VIN", F, r_, clearance=0.2, thermal=False, name="VIN-top-%d" % (i + 1), priority=2 + i)
    bd.zone("VIN", B, rect(BAND_W, 6.0, BAND_E, 17.2), clearance=0.3, thermal=False, name="VIN-bottom-D1")
    bd.zone("VIN", B, rect(BAND_W, 31.05, BAND_E, 39.0), clearance=0.3, thermal=False, name="VIN-bottom-D2")
    for dref in ("D2", "D1"):
        k = P(dref, "2")
        for vx in (k[0] + 1.9, k[0] + 3.1):
            for dy in (-1.5, -0.5, 0.5, 1.5):
                bd.via("VIN", vx, k[1] + dy, dia=0.8, drill=0.4)
    for ref in ("C4", "C5"):
        g = P(ref, "2")
        bd.gnd_via(g[0], g[1] + 1.5, frm=g, width=0.6)
    # 分圧 (VIN・VBUS1)
    r23 = P("R23", "1")
    T("VIN", 0.4, [r23, (r23[0], STRIP[0] + 0.3)])
    T("VIN_SENSE", 0.25, [P("R23", "2"), (P("R23", "2")[0] + 0.9, P("R23", "2")[1]), (P("R23", "2")[0] + 0.9, P("R24", "1")[1]), P("R24", "1")])

    # ======== 3.3V の降圧 (rev B の形のまま) ==================================
    with bd.frame(**BUCK):
        BUS = 57.5
        u3 = {n: P("U3", n) for n in "12345678"}
        c9, c8, c10 = P("C9", "1"), P("C8", "1"), P("C10", "1")
        yv = c9[1]
        T("VIN", 1.5, [(BUS, yv), c9, c8])
        T("VIN", 0.8, [c8, (c10[0] + 0.3, yv), c10])
        T("VIN", 0.3, [u3["3"], (c10[0] - 0.25, u3["3"][1]), (c10[0], u3["3"][1] + 0.25)])
        c11s, c11b = P("C11", "2"), P("C11", "1")
        l1sw, l1out = P("L1", "1"), P("L1", "2")
        T("SW_3V3", 0.28, [u3["5"], (u3["5"][0] - 0.6, u3["5"][1]), (u3["5"][0] - 1.1, u3["5"][1] - 0.5)])
        T("SW_3V3", 0.6, [(u3["5"][0] - 1.1, u3["5"][1] - 0.5), (c11s[0] + 0.3, c11s[1]), c11s])
        T("SW_3V3", 0.8, [c11s, (l1sw[0] + 0.6, l1sw[1] + 1.0), l1sw])
        x0, y0 = 47.0, 9.0
        bd.zone("SW_3V3", F, [(x0 - 0.5, y0 - 0.89), (x0 - 0.5, y0 - 0.61), (x0 - 1.1, y0 - 0.61),
                              (x0 - 1.65, y0 - 1.05), (x0 - 3.0, y0 - 1.05), (x0 - 3.4, y0 - 1.8),
                              (x0 - 6.0, y0 - 1.8), (x0 - 6.0, y0 - 5.2), (x0 - 3.4, y0 - 5.2),
                              (x0 - 1.4, y0 - 3.2), (x0 - 1.4, y0 - 0.89)],
                clearance=0.2, min_width=0.2, thermal=False, name="U3-SW")
        T("BST_3V3", 0.2, [u3["6"], (c11b[0] + 0.2, u3["6"][1]), c11b])
        c12 = P("C12", "1")
        T("SS_3V3", 0.2, [u3["7"], (c12[0] + 0.05, u3["7"][1]), (c12[0] + 0.05, c12[1] - 0.2), c12])
        bd.gnd_via(P("C12", "2")[0] - 1.1, c12[1], frm=P("C12", "2"))
        r7, r6 = P("R7", "1"), P("R6", "2")
        T("FB_3V3", 0.2, [u3["8"], (u3["8"][0], r7[1] - 0.6), r7])
        T("FB_3V3", 0.25, [r7, r6])
        bd.gnd_via(P("R7", "2")[0] - 1.1, r7[1], frm=P("R7", "2"))
        r6a, c13s = P("R6", "1"), P("C13", "1")
        T("+3V3_BUCK", 0.25, [r6a, (r6a[0], r6a[1] + 1.0), (38.6, r6a[1] + 1.0), (38.6, 9.6), (c13s[0] + 1.3, 9.6),
                              (c13s[0] + 0.3, 8.6), (c13s[0] + 0.3, c13s[1] + 0.6)])
        bd.zone("VIN", F, [(x0 + 0.5, y0 - 0.39), (x0 + 1.95, y0 - 0.39), (x0 + 1.95, y0 - 0.2),
                           (BUS - 0.5, y0 - 0.2), (BUS - 0.5, y0 + 1.4), (x0 + 1.75, y0 + 1.4),
                           (x0 + 1.75, y0 - 0.11), (x0 + 0.5, y0 - 0.11)],
                clearance=0.2, min_width=0.2, thermal=False, name="U3-VIN")
        c10g = P("C10", "2")
        T("GND", 0.28, [u3["4"], (c10g[0] - 0.55, u3["4"][1]), (c10g[0], u3["4"][1] - 0.35)])
        T("GND", 1.0, [c10g, P("C8", "2"), P("C9", "2")])
        yg = c10g[1] - 1.45
        for x in (x0 + 1.9, x0 + 2.8, x0 + 3.7, x0 + 4.6, x0 + 6.5):
            bd.gnd_via(x, yg, frm=(x, c10g[1] - 0.3), width=0.5)
        bd.zone("GND", F, [(x0 + 0.5, y0 - 0.89), (x0 + 1.4, y0 - 0.89), (x0 + 1.4, y0 - 3.5), (x0 + 7.7, y0 - 3.5),
                           (x0 + 7.7, y0 - 0.45), (x0 + 2.1, y0 - 0.45), (x0 + 1.4, y0 - 0.61), (x0 + 0.5, y0 - 0.61)],
                clearance=0.2, min_width=0.2, thermal=False, name="U3-GND")
        c13, c14 = P("C13", "1"), P("C14", "1")
        T("+3V3_BUCK", 1.5, [(l1out[0], c13[1]), c13, c14])
        for ref in ("C13", "C14"):
            g = P(ref, "2")
            bd.gnd_via(g[0], g[1] - 1.5, frm=g, width=0.6)
        bd.gnd_via(P("C14", "2")[0] - 1.3, P("C14", "2")[1] - 0.9, frm=P("C14", "2"), width=0.6)
        # EN: 2 番ピンから、1 番ピン (RT、未接続) の外を回って出る
        e = u3["2"]
        T("EN_3V3", 0.2, [e, (e[0] + 0.7, e[1]), (e[0] + 0.7, e[1] + 1.7), (e[0] + 1.35, e[1] + 2.05)])
        en_end = bd.to_board(e[0] + 1.35, e[1] + 2.05)
        vin_in = bd.to_board(BUS, yv)
    # VIN の帯 -> 降圧の入口 (幹)
    T("VIN", 2.0, [(BAND_E - 1.0, vin_in[1]), vin_in])
    u6t = P("U6", "2")
    T("VIN", 0.6, [(u6t[0], vin_in[1]), u6t])
    c6 = P("C6", "1")
    T("VIN", 0.6, [(c6[0], vin_in[1]), c6])
    bd.gnd_via(P("C6", "2")[0] + 1.2, P("C6", "2")[1], frm=P("C6", "2"), width=0.5)
    u6g, u6o, c7a, c7g = P("U6", "1"), P("U6", "3"), P("C7", "1"), P("C7", "2")
    bd.gnd_via(u6g[0] - 1.0, u6g[1], frm=u6g)
    T("+5V", 0.5, [u6o, (c7a[0] - 0.9, u6o[1]), (c7a[0], c7a[1])])
    T("+5V", 0.4, [(49.3, P("JP3", "1")[1] + 1.2), (49.7, 22.65), (u6o[0] - 0.4, 22.65), (u6o[0], 22.2), u6o])
    bd.gnd_via(c7g[0] + 1.25, c7g[1], frm=c7g)
    # EN: うらから上がったビア -> R9・C15 -> U3
    ye = en_end[1]
    T("EN_3V3", 0.2, [(RUNS["EN"], 13.2), (RUNS["EN"] + ye - 13.2, ye), en_end])
    for ref, dx, dy in (("R9", 1.2, 0.0), ("C15", 0.0, -1.3)):
        p, g = P(ref, "1"), P(ref, "2")
        T("EN_3V3", 0.2, [p, (p[0], ye)])
        bd.gnd_via(g[0] + dx, g[1] + dy, frm=g)
    p, g = P("C27", "1"), P("C27", "2")
    T("+3V3", 0.8, [p, (p[0], YT)])
    bd.gnd_via(g[0] - 1.25, g[1], frm=g, width=0.6)
    p, g = P("C28", "1"), P("C28", "2")
    T("+3V3", 0.5, [p, (p[0], YT)])
    bd.gnd_via(g[0] + 1.2, g[1], frm=g)
    # 降圧の出口: C14 -> JP5 (と並列の JP1) -> +3V3 の幹
    c14 = P("C14", "1")
    jp5a, jp5b, jp1a, jp1b = P("JP5", "1"), P("JP5", "2"), P("JP1", "1"), P("JP1", "2")
    T("+3V3_BUCK", 1.5, [c14, (jp5a[0] - 0.3, jp5a[1])])
    T("+3V3_BUCK", 1.0, [(jp5a[0] - 0.3, jp5a[1]), jp5a, (jp5a[0], jp5a[1] - 0.9), (jp1a[0], jp5a[1] - 1.6), jp1a])
    T("+3V3", 1.0, [jp5b, (jp5b[0], jp5b[1] - 0.9), (jp1b[0], jp5b[1] - 1.6)])
    T("+3V3", 1.5, [(jp1b[0], jp5b[1] - 1.6), jp1b])

    # ======== +3V3: JP1 -> 幹 (y = YT) -> B8、ビア 4 個でうらへ降りて A9・A10 ===========
    a9, a10, a11, b8, b10 = (P("J3", n) for n in ("A9", "A10", "A11", "B8", "B10"))
    xv3 = [b8[0] - 2.15 + i for i in range(4)]       # 外径 0.8 のビア 4 個 (幹の左の端)
    T("+3V3", 2.0, [jp1b, (jp1b[0], YT), (xv3[1] + 0.3, YT)])
    T("+3V3", 1.0, [(xv3[1] + 0.3, YT), (xv3[0], YT)])
    T("+3V3", 0.7, [(b8[0], b8[1] + 1.4), (b8[0], YT - 0.4)])
    for x in xv3:
        bd.via("+3V3", x, YT, dia=0.8, drill=0.4)
    xa = (a9[0] + a10[0]) / 2
    T("+3V3", 1.7, [(xa, a9[1] + 3.0), (xa, YT)], layer=B)       # A9・A10 の 2 本を受ける
    for p in (a9, a10):
        T("+3V3", 0.7, [(p[0], p[1] + 1.2), (p[0], p[1] + 2.3), (xa, a9[1] + 3.0)], layer=B)
    T("+3V3", 1.6, [(xv3[0], YT), (xa, YT)], layer=B)
    q = P("JP4", "2")
    T("+3V3AUX", 0.4, [(b10[0], b10[1] + 1.4), q])
    # PERST# (A11、うら): 切り欠きの左を降り、VIN の幹をくぐってマイコンの区画へ。+3V3 の細い線も並べて降ろす
    T("PERST#", 0.25, [(a11[0], a11[1] + 1.5), (a11[0], 9.0), (a11[0] - 0.6, 9.6), (RUNS["PERST"] + 0.6, 9.6),
                       (RUNS["PERST"], 10.2), (RUNS["PERST"], 33.0), (RUNS["PERST"] + 0.9, 33.9)], layer=B)
    vp = (RUNS["PERST"] + 0.9, 33.9)
    bd.via("PERST#", *vp)
    d6a, r27b, c31a = P("D6", "2"), P("R27", "2"), P("C31", "1")
    T("PERST#", 0.25, [r27b, (vp[0], r27b[1] + 1.0), vp, d6a])
    T("PERST#", 0.25, [d6a, c31a, P("R37", "2")])
    v33 = (RUNS["V33"], 29.3)
    T("+3V3", 0.3, [(RUNS["V33"], YT), v33], layer=B)
    bd.via("+3V3", *v33)
    d6k, r27a = P("D6", "1"), P("R27", "1")
    T("+3V3", 0.3, [v33, (r27a[0], v33[1] + 0.7), r27a])
    T("+3V3", 0.3, [(r27a[0], v33[1] + 0.7), (d6k[0], v33[1] + 0.7), d6k])
    bd.gnd_via(P("C31", "2")[0], P("C31", "2")[1] - 1.3, frm=P("C31", "2"), width=0.5)
    # スロットの GND のパッド: おもての B4・B7 はすぐ下のビアへ。B13・B16・B18 と、うらの A12・A15・A18 は辺の側でつなぎ、耳の下のビアへ
    for num, dx in (("B4", 0.35), ("B7", 0.0)):
        p = P("J3", num)
        bd.gnd_via(p[0] + dx, 5.85, frm=(p[0], p[1] + 1.5), width=0.4)
    ygn = 0.8
    for layer, nums in ((F, ("B13", "B16", "B18")), (B, ("A12", "A15", "A18"))):
        for n in nums:
            p = P("J3", n)
            T("GND", 0.4, [(p[0], p[1] - 1.5), (p[0], ygn)], layer=layer)
        T("GND", 0.4, [(P("J3", nums[0])[0], ygn), (67.4, ygn), (67.4, 1.3)], layer=layer)
    bd.via("GND", 67.4, 1.3)
    T("GND", 0.4, [(P("J3", "A4")[0], 4.6), (P("J3", "A4")[0], 5.3), (P("J3", "B4")[0] + 0.35, 5.85)], layer=B)

    # ======== 12V の昇圧 (rev B の形のまま。VIN は下の帯からおもてで入る) ============
    with bd.frame(**BOOST):
        x4 = 33.5
        u4 = {n: P("U4", n) for n in "123456"}
        d4k, d4a = P("D4", "1"), P("D4", "2")
        l2v, l2sw = P("L2", "1"), P("L2", "2")
        xb = x4 + 2.8
        c16 = P("C16", "1")
        T("VIN", 1.5, [(xb, l2v[1]), l2v])
        T("VIN", 1.5, [(xb, l2v[1]), (xb, c16[1])])
        T("VIN", 1.0, [(xb, c16[1]), c16, P("C17", "1")])
        T("VIN", 0.5, [(xb, c16[1]), (xb, u4["5"][1] - 0.45), (xb - 0.45, u4["5"][1]), u4["5"]])
        T("SW_12V", 0.6, [u4["1"], (d4a[0] + 0.5, u4["1"][1]), d4a])
        T("SW_12V", 1.5, [d4a, (d4a[0] - 0.4, d4a[1] - 1.2), (l2sw[0] + 0.2, l2sw[1] + 1.3), l2sw])
        c18, c19 = P("C18", "1"), P("C19", "1")
        c18g, c19g = P("C18", "2"), P("C19", "2")
        # 熱い輪: SW -> D4 -> C18 -> GND -> U4 の 2 番
        T("+12V_BOOST", 1.2, [d4k, (d4k[0], c19[1] - 0.6), c19])
        T("+12V_BOOST", 1.0, [c19, c18])
        T("+12V_BOOST", 1.0, [d4k, (d4k[0] + 1.2, c18[1] - 0.8), c18])
        ga, gb = (x4 - 2.45, 40.65 + 0.8), (x4 - 3.15, 40.65 + 0.1)
        T("GND", 0.5, [u4["2"], gb])
        T("GND", 0.5, [gb, ga])
        T("GND", 0.8, [gb, c18g])
        bd.via("GND", *ga)
        bd.via("GND", *gb)
        bd.gnd_via(c19g[0], c19g[1] + 1.25, frm=c19g, width=0.6)
        for ref in ("C16", "C17"):
            g = P(ref, "2")
            bd.gnd_via(g[0], g[1] + 1.4, frm=g, width=0.6)
        r12, r11b, r11t = P("R12", "1"), P("R11", "2"), P("R11", "1")
        T("FB_12V", 0.25, [u4["3"], (u4["3"][0], r12[1] - 0.75), r12])
        T("FB_12V", 0.25, [r12, r11b])
        T("+12V_BOOST", 0.3, [r11t, (r11t[0] - 0.85, r11t[1]), (c18[0], c18[1] + 0.65), c18])
        bd.gnd_via(33.5, 42.8, frm=P("R12", "2"))
    g = P("R13", "2")
    bd.gnd_via(g[0] - 1.2, g[1], frm=g)
    # 出力スイッチ Q1: +12V_BOOST は右の辺を回って上から S へ。D は戻りの列へ。ゲートのまわりはその内側
    d4k = P("D4", "1")
    q1g, q1s, q1d = P("Q1", "1"), P("Q1", "2"), P("Q1", "3")
    xr = W - 0.8
    T("+12V_BOOST", 0.8, [d4k, (xr, d4k[1]), (xr, q1s[1]), q1s])
    r14g, r14s, c20g, c20s = P("R14", "1"), P("R14", "2"), P("C20", "1"), P("C20", "2")
    T("Q1_G", 0.3, [q1g, (q1g[0] + 0.5, r14g[1]), r14g, c20g])
    c32g, c32d = P("C32", "1"), P("C32", "2")
    T("Q1_G", 0.3, [c32g, (q1g[0], q1g[1] + 0.9), q1g])
    T("+12V_SW", 0.5, [q1d, (c32d[0], q1d[1] + 0.6), c32d])
    r15a, r15b = P("R15", "1"), P("R15", "2")
    T("Q1_G", 0.3, [r14g, r15a])
    q2g, q2s, q2d = P("Q2", "1"), P("Q2", "2"), P("Q2", "3")
    q3g, q3s, q3d = P("Q3", "1"), P("Q3", "2"), P("Q3", "3")
    T("Q2_D", 0.3, [r15b, (r15b[0], q2d[1] - 0.9), (r15b[0] + 0.9, q2d[1]), q2d])
    T("Q2_S", 0.3, [q2s, (q2s[0] - 1.0, q2s[1]), (q2s[0] - 1.0, q3d[1] + 0.6), (q3d[0] + 0.4, q3d[1]), q3d])
    bd.gnd_via(q3s[0] - 1.05, q3s[1] - 0.35, frm=q3s)
    # Q2 のゲート: マイコンの区画から、戻りの列と昇圧の間のすきまを右へ通り、C19 の右を降りて Q2 へ
    r16 = P("R16", "1")
    yq = ROW + 1.2
    T("Q2_G", 0.2, [r16, (r16[0], yq + 0.7), (r16[0] + 0.7, yq), (q2d[0] - 3.1, yq), (q2d[0] - 2.5, yq + 0.6), (q2d[0] - 2.5, q2g[1] - 0.15),
                    (q2d[0] - 1.8, q2g[1] + 0.55), (q2g[0] - 0.6, q2g[1] + 0.55), q2g])
    T("Q2_G", 0.25, [P("R34", "2"), r16])
    T("EN_12V", 0.25, [P("R13", "1"), (P("R13", "1")[0] + 0.7, P("R13", "1")[1] + 0.7), P("U4", "4")])
    # Q3 のゲート (+3V3): JP1 から右へ出て、+12V_BOOST の線をうらでくぐる
    v3a, v3b = (q3g[0], q1s[1] - 1.45), (q3g[0], q3g[1] + 0.95)
    T("+3V3", 0.3, [jp1b, (jp1b[0] + 1.3, jp1b[1] + 1.3), (v3a[0] - 1.3, jp1b[1] + 1.3), (v3a[0], jp1b[1] + 2.6), v3a])
    bd.via("+3V3", *v3a)
    r10 = P("R10", "1")
    v3c = (q3g[0], r10[1])
    T("+3V3", 0.3, [v3a, v3b, v3c], layer=B)
    bd.via("+3V3", *v3b)
    bd.via("+3V3", *v3c)
    T("+3V3", 0.3, [v3c, r10])
    T("+3V3", 0.3, [v3b, q3g])
    # +12V_SW: Q1 の D -> 戻りの列を左へ -> F1 -> JP2 (と JP6) -> +12V
    f1a, f1b = P("F1", "1"), P("F1", "2")
    T("+12V_SW", 0.8, [q1d, (q1d[0] - 0.75, q1d[1]), (q1d[0] - 1.95, q1d[1] + 1.2), (q1d[0] - 1.95, ROW - 0.8),
                       (q1d[0] - 2.75, ROW), f1a])
    jp2a, jp2b, jp6a, jp6b = P("JP2", "1"), P("JP2", "2"), P("JP6", "1"), P("JP6", "2")
    T("+12V_F", 0.8, [f1b, jp2a])
    T("+12V_F", 0.8, [jp2a, (jp2a[0] - 1.17, ROW + 1.65), (jp2b[0] - 1.9, ROW + 1.65), (jp6a[0] + 0.65, ROW), jp6a])
    T("+12V", 0.8, [jp2b, (jp2b[0] - 1.2, ROW - 1.35), (jp6b[0] - 0.75, ROW - 1.35), (jp6b[0] - 1.85, ROW)])
    T("+12V", 0.8, [jp6b, (X12, ROW)])
    T("+12V", 1.0, [(X12, ROW), (X12, YV12)])
    p = P("R32", "1")
    T("+12V", 0.4, [p, (p[0], ROW)])
    p = P("R18", "1")
    T("+12V", 0.4, [p, (X12 - 0.4, p[1])])
    bd.gnd_via(P("R18", "2")[0], P("R18", "2")[1] + 1.1, frm=P("R18", "2"))
    # VIN の幹の下だけうらでくぐり、うらのパッド A2・A3 へ。おもての B1・B2・B3 へはパッドのすぐ下のビアで
    a2, a3, b1, b2, b3 = (P("J3", n) for n in ("A2", "A3", "B1", "B2", "B3"))
    xs = (a2[0] + a3[0]) / 2
    T("+12V", 0.8, [(X12 - 0.9, YV12), (X12 + 0.9, YV12)])
    T("+12V", 0.8, [(X12 - 0.9, YV12), (X12 + 0.9, YV12)], layer=B)
    for dx in (-0.9, 0.0, 0.9):
        bd.via("+12V", X12 + dx, YV12, dia=0.8, drill=0.4)
    T("+12V", 1.5, [(xs, YV12 - 0.4), (xs, a2[1] + 3.1)], layer=B)
    for p in (a2, a3):
        T("+12V", 0.7, [(p[0], p[1] + 1.2), (p[0], p[1] + 2.4), (xs, a2[1] + 3.1)], layer=B)
    yp12 = 6.3
    for p in (b1, b2, b3):
        T("+12V", 0.6, [(p[0], p[1] + 1.4), (p[0], yp12)])
    T("+12V", 0.8, [(b1[0], yp12), (b3[0], yp12)])
    T("+12V", 0.8, [(b1[0] + 0.2, yp12), (xs, yp12)], layer=B)
    for x in (b1[0] + 0.2, b1[0] + 1.35):
        bd.via("+12V", x, yp12, dia=0.8, drill=0.4)
    c29, c30 = P("C29", "1"), P("C30", "1")
    T("+12V", 0.6, [(b2[0] + 0.45, yp12), c29, c30])
    bd.gnd_via(P("C29", "2")[0] + 1.3, P("C29", "2")[1], frm=P("C29", "2"), width=0.5)
    bd.gnd_via(P("C30", "2")[0] - 0.15, P("C30", "2")[1] + 1.3, frm=P("C30", "2"), width=0.5)

    # ======== マイコンの電源 (rev B の形のまま) ================================
    with bd.frame(**MCU):
        u7 = {n: P("U7", n) for n in ("9", "7")}
        c22 = P("C22", "1")
        c21p, c21g = P("C21", "1"), P("C21", "2")
        T("+5V", 0.3, [u7["9"], (u7["9"][0], c21p[1] - 0.9), c21p])
        T("GND", 0.3, [u7["7"], (u7["7"][0], c21g[1] - 0.9), c21g])
        T("+5V", 0.4, [c21p, (c21p[0], c21p[1] + 1.0), (c22[0], c21p[1] + 1.0), c22])
        bd.gnd_via(c21g[0] - 1.15, c21g[1], frm=c21g)
        bd.gnd_via(P("C22", "2")[0] + 1.15, P("C22", "2")[1], frm=P("C22", "2"))
    T("SW1_IN", 0.25, [P("R19", "2"), (P("JP7", "1")[0], P("R19", "2")[1]), P("JP7", "1")])
    T("GND", 0.3, [P("JP7", "2"), P("R16", "2")])
    bd.gnd_via(P("R16", "2")[0] + 1.15, P("R16", "2")[1], frm=P("R16", "2"))
    for ref in ("C25", "C26", "C23", "C24"):
        g = P(ref, "2")
        bd.gnd_via(g[0] - 0.95, g[1], frm=g)
    g = P("C33", "2")
    bd.gnd_via(g[0] - 0.95, g[1], frm=g)
    g = P("R24", "2")
    bd.gnd_via(g[0], g[1] - 1.25, frm=g)
    T("GND", 0.4, [P("R33", "2"), (P("C21", "2")[0] - 1.15, P("C21", "2")[1])])
    g = P("R26", "2")
    bd.gnd_via(g[0] + 1.15, g[1], frm=g)
    bd.gnd_via(P("TP5", "1")[0] - 1.4, P("TP5", "1")[1], frm=P("TP5", "1"))
    for ref, _x in LEDS:
        g = P(ref, "2")
        bd.gnd_via(g[0] + 1.25, g[1], frm=g)
    T("LED5_A", 0.25, [P("R20", "2"), P("LED5", "1")])

    # ここまでの線は固定する (自動配線が動かさないように)
    for t in bd.b.GetTracks():
        t.SetLocked(True)


# うらの GND を切らせたくない所 (うらの配線を禁止): 降圧・昇圧・USB のデータ線の下
NO_BOTTOM = {
    "buck-gnd": (U3X - 7.6, U3Y - 5.8, U3X + 18.0, U3Y + 7.0),
    "boost-gnd": (U4X - 7.4, U4Y - 4.2, U4X + 9.0, U4Y + 10.3),
    "usb-gnd-1": (JX + 7.12, J1Y - 1.3, JX + 13.6, J1Y + 3.2),
    "usb-gnd-2": (JX + 13.6, J1Y - 0.65, J4X + 3.0, J1Y + 2.6),
}


def keepouts(bd: Board):
    """自動配線に通らせたくない所。"""
    for name, box in NO_BOTTOM.items():
        bd.keepout([B], rect(*box), name=name)
    with bd.frame(**USB1):
        bd.keepout([B], rect(80.0, 10.9, 82.5, 15.7), name="usb-gnd-0")
    # USB-C の殻の下: ビアを置かせない。おもての線も通さない (CC の線が殻の下へ入らないように)
    for name, y in (("J1", J1Y), ("J2", J2Y)):
        bd.keepout([F, B], rect(0.1, y - 3.7, 5.75, y + 3.7), tracks=False, vias=True, name=name + "-shell-no-via")
        bd.keepout([F], rect(0.1, y - 3.6, 5.6, y + 3.6), name=name + "-shell-no-top-track")
    # D1・D2 の胴体の下: おもての線を禁止
    for name in ("D1", "D2"):
        k = bd.P(name, "2")
        bd.keepout([F], rect(k[0] - 3.75, k[1] - 0.9, k[0] - 1.25, k[1] + 0.9), name=name + "-body")


def drawing(bd: Board):
    """ブラケット・カード・コネクタの口・J4 のプラグ・USB-C の口を Dwgs.User の層に描く (推定の値は est と書く)。"""
    D = pcbnew.Dwgs_User
    x_out, x_in = MOUTH, MOUTH + BRACKET_T

    def box(x1, y1, x2, y2, w=0.1):
        for a, b_ in (((x1, y1), (x2, y1)), ((x2, y1), (x2, y2)), ((x2, y2), (x1, y2)), ((x1, y2), (x1, y1))):
            bd.line(D, a[0], a[1], b_[0], b_[1], w)

    def note(s, x, y, rot=0, just="L"):
        bd.text(s, x, y, size=0.8, thick=0.1, layer=D, rot=rot, just=just)

    # ブラケットの板 (上から見た形: 厚み 0.86 の線)。全幅は y <= 7.68、舌の先は 14.95 (標準)・10.85 (ロープロファイル)
    box(x_out, CARD_EDGE_Y - 3.0, x_in, BRACKET_FULL_Y)
    box(x_out, BRACKET_FULL_Y, x_in, TONGUE_Y, 0.05)
    bd.line(D, x_out - 1.5, TONGUE_Y_LP, x_in + 0.6, TONGUE_Y_LP, 0.05)
    bd.line(D, x_out - 1.5, TONGUE_Y, x_in + 0.6, TONGUE_Y, 0.05)
    bd.line(D, x_out - 1.5, BRACKET_FULL_Y, x_in + 0.6, BRACKET_FULL_Y, 0.05)
    bd.line(D, x_out, CARD_EDGE_Y - 5.0, x_out, H + 2.0, 0.05)        # ブラケットの外の面 = USB-C の口の面
    note("bracket (est): plate x -0.99..-0.13, z -2.06..+16.36", x_out - 0.6, 7.0, rot=90)
    note("full width to y 7.68, tongue tip y 14.95 (LP 10.85), tongue z +2.05..+12.24 (est)", x_out - 2.0, 15.5, rot=90)
    # カード (基板と同じ平面。下の辺は y = -13.0) とコネクタの口 (y = -8.1)
    px = SLOT[0] - 9.5
    cx = px - CARD_END
    bd.line(D, cx, CARD_EDGE_Y, W + 4.0, CARD_EDGE_Y, 0.1)
    bd.line(D, cx, CARD_EDGE_Y, cx, CARD_EDGE_Y - 3.0, 0.1)
    note("card lower edge y -13.0 (est)", 2.0, CARD_EDGE_Y - 1.0)
    box(SLOT[0] - 15.45, MOUTH_Y, SLOT[0] + 15.45, 0.0)
    note("J3 body, mouth y -8.1 (est)", SLOT[0] - 14.5, -4.0)
    bd.line(D, px, MOUTH_Y - 2.0, px, 6.0, 0.05)                     # 1 番ピンの中心
    note("pin 1", px + 0.3, MOUTH_Y - 1.2)
    for x1, x2 in EARS:                                               # 耳の下 (両面とも部品を置かない)
        box(x1, 0.0, x2, EAR_Y, 0.05)
    note("ear (est)", EARS[0][0] + 0.3, EAR_Y - 0.7)
    # J4 の樹脂とプラグ (プラグの下は部品を置かない)
    box(*J4_BODY)
    box(*J4_PLUG, 0.05)
    bd.line(D, J4_PLUG[0], J4_PLUG[1], J4_PLUG[2], J4_PLUG[3], 0.05)
    bd.line(D, J4_PLUG[0], J4_PLUG[3], J4_PLUG[2], J4_PLUG[1], 0.05)
    note("J4 plug 14 x 13.2 (est), no parts below", J4_PLUG[0] + 0.4, J4_PLUG[1] + 1.0)
    for jy in (J1Y, J2Y):                                             # USB-C の口 (幅 8.94mm)
        bd.line(D, MOUTH, jy - 4.47, MOUTH, jy + 4.47, 0.2)
        bd.line(D, MOUTH, jy - 4.47, 0.0, jy - 4.47, 0.1)
        bd.line(D, MOUTH, jy + 4.47, 0.0, jy + 4.47, 0.1)


def main():
    bd = build()
    route(bd)
    keepouts(bd)
    drawing(bd)
    os.makedirs(os.path.join(ROOT, "build"), exist_ok=True)
    out = os.path.join(ROOT, "build", "pre_route.kicad_pcb")
    bd.save(out)
    for ext in ("kicad_pro", "kicad_dru"):
        shutil.copyfile(os.path.join(ROOT, "pcie-tuner-board." + ext), os.path.join(ROOT, "build", "pre_route." + ext))
    for f in ("fp-lib-table", "sym-lib-table"):
        shutil.copyfile(os.path.join(ROOT, f), os.path.join(ROOT, "build", f))
    print("saved", out, "footprints", len(bd.fps))
    return bd


if __name__ == "__main__":
    main()
