danything/outboard/(commit log)

2026-11-11 Schematic, symbol/footprint library and netlist checks
    Claude-Session: https://claude.ai/code/session_01T8TqVdo6LUrWKdVQgbScVU
    [pcie-tuner-board.kicad_sch]
2026-11-11 Board: placement, hand routing, autoroute import, zones, checks
    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
    [pcie-tuner-board.kicad_pcb, pcie-tuner-board.kicad_sch]
2026-11-11 Finish board, fab outputs, README
    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
    [bom.csv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]
2026-11-11 rev B: review fixes (circuit, layout, checks)
    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
    [bom.csv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]
2026-11-11 rev B: README, fab and out regenerated
    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
    [pcie-tuner-board-B_Cu.gbl, pcie-tuner-board-B_Mask.gbs, pcie-tuner-board-B_Paste.gbp, pcie-tuner-board-B_Silkscreen.gbo, pcie-tuner-board-Edge_Cuts.gm1, pcie-tuner-board-F_Cu.gtl, pcie-tuner-board-F_Mask.gts, pcie-tuner-board-F_Paste.gtp]
2026-11-11 rev B: over-voltage lock, Basic part swaps, headers and switch not assembled, copper for D1/D2, all refs on silk
    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
    [bom.csv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]
2026-11-11 rev C: USB-C on the bracket side, stepped outline for the bracket, new floorplan; gate network, PTC, bleeders, series resistors, J4 assembled
    - USB-C mouth plane = bracket outer face (pin 1 at 47.54 mm, estimated), board edge set back 1.5 mm where the bracket passes
    - LEDs on the top long edge, mounting holes at the corners, dimension drawing (out/dimensions.pdf)
    - D1/D2: 200-400 mm2 top copper per node, 8 vias to a bottom VIN plane; CC lines kept out from under the USB-C shells
    - Q1 gate 150k / 1uF / 33nF (ngspice in out/sim), PTC 1.1 A, bleeders 4 x 1k 0805, 1k in series with PC3/PC4
    - courtyard DRC enabled; hand-routed nets excluded from the autorouter; dangling stubs trimmed after import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
    [bom.csv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]
2026-11-11 rev C touch-ups after the third review
    - bracket overhang from CEM 2.0 figures (2.06-2.5 / 16.36), step moved to y = 43
    - VBUS widened right after the pad row, R12 ground via moved off the bottom VIN strip
    - J3 peg holes back to 2.35 mm, row digits on the J4 silk
    - README: short-circuit procedure for 12 V, case floor clearance, real strip widths, Economic/Standard estimate
    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
    [pcie-tuner-board-B_Cu.gbl, pcie-tuner-board-B_Mask.gbs, pcie-tuner-board-B_Paste.gbp, pcie-tuner-board-B_Silkscreen.gbo, pcie-tuner-board-Edge_Cuts.gm1, pcie-tuner-board-F_Cu.gtl, pcie-tuner-board-F_Mask.gts, pcie-tuner-board-F_Paste.gtp]
2026-11-12 rev D (work in progress): straddle-mount PCIe slot and right-angle USB header in the schematic and library
    - J3: XKB X1613WS-36D-9TV01 (C21263091), footprint fixed against the datasheet (B row on the top side, ear holes 2.0 mm, no outline)
    - J4: XFCN PZ254R-12-10P (C492433)
    - board not yet redone (still rev C); this branch is not buildable end to end
    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
    [pcie-tuner-board.kicad_sch]
2026-11-12 rev D board (work in progress): new outline, placement and hand routing; edge rule for the J3 pads
    Not yet autorouted. make_board.py is rewritten for the single board with the
    straddle-mount slot; finish_board.py and check_board.py are only partly adapted.
    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
2026-11-12 rev D board (work in progress): 100 x 44 mm floorplan, rev D checks, project title 'outboard', LICENSE
    Hand routing passes DRC before autorouting; the autorouter does not yet finish
    every signal (2-7 connections left per try). check_board.py is adapted to rev D.
    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
    [pcie-tuner-board.kicad_sch]
2026-11-12 rev D board (work in progress): DRC not yet clean (autorouter leaves 1-3 signals and 3 GND islands)
    Pre-route board passes DRC (clearance, courtyards, edge). After autorouting,
    3-8 unconnected items remain per try in 19 tries; routing/route.ses is the last
    try, not a clean one. check_board.py runs with the rev D checks.
    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
    [pcie-tuner-board.kicad_pcb]
2026-11-12 rev D board (work in progress): layout edits in progress when the KiCad track was stopped
    The design moves to tscircuit from here; this branch is kept as the last state of the KiCad scripts.
    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
